f8kgl/swr_power_meter/src/doc/tuto github desktop.docx

Installation de github desktop

Se rendre à l’adresse https://desktop.github.com/

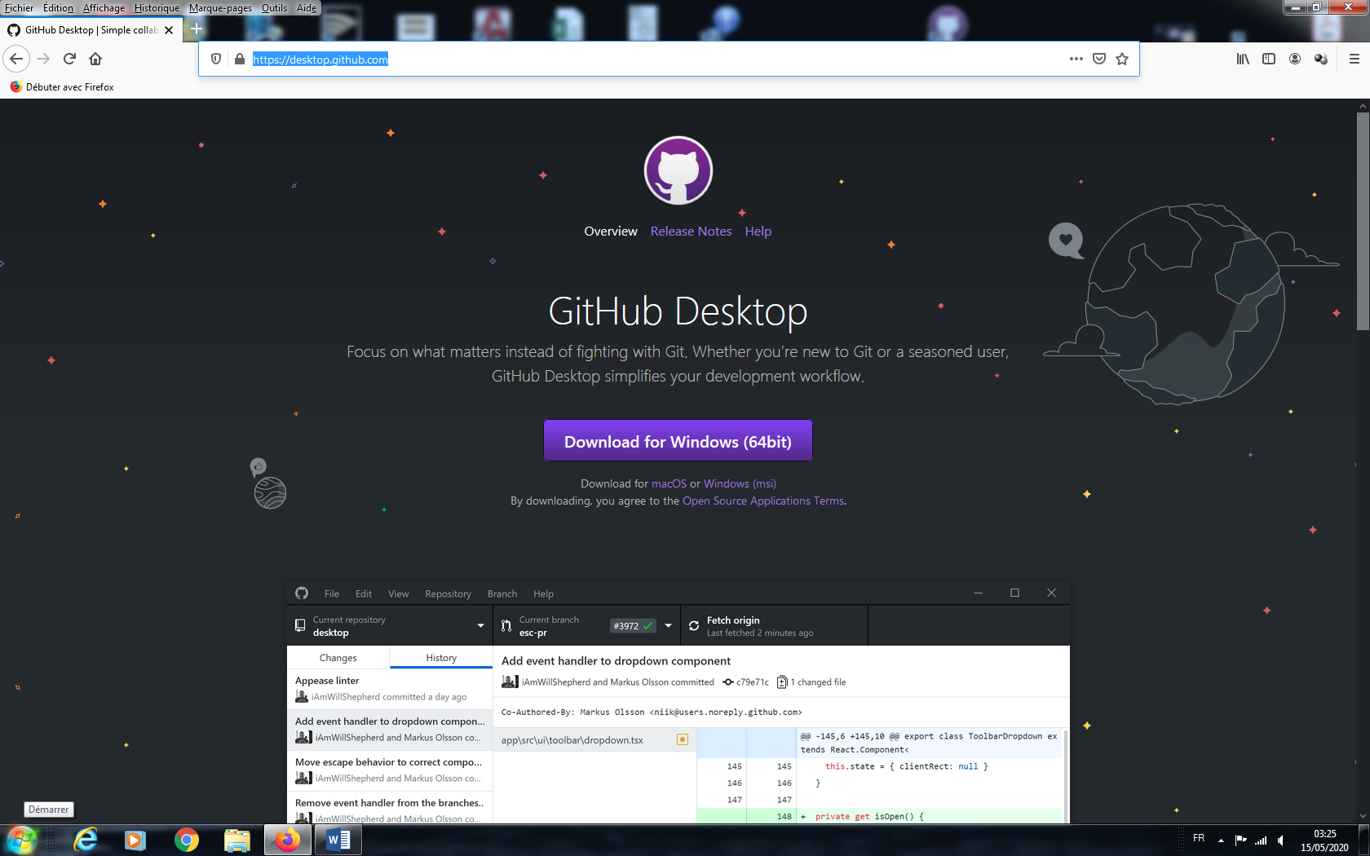
[picture p28: figure]

Cliquer sur

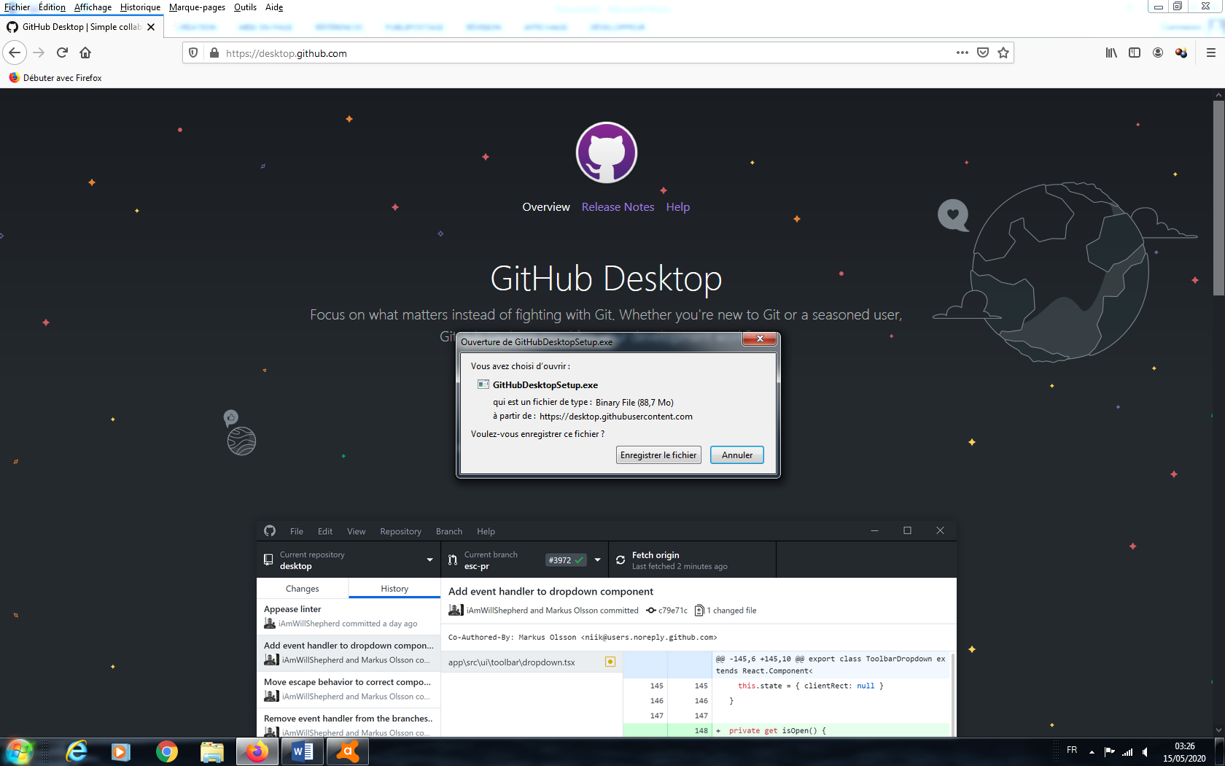
[picture p29: figure]

Enregistrer le fichier puis Exécuter le fichier GitHubDesktopSetup.exe récemment télécharger

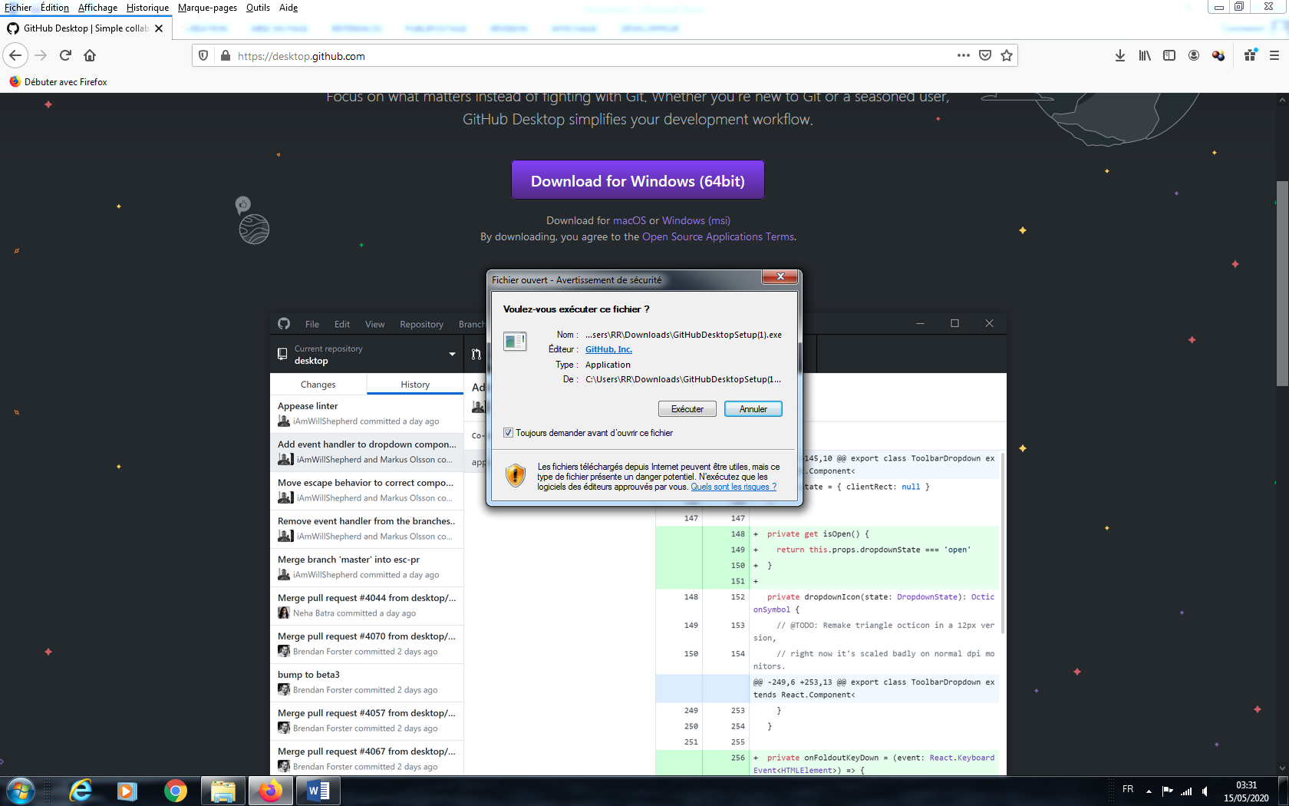
[picture p30: figure]

Cliquer sur Exécuter

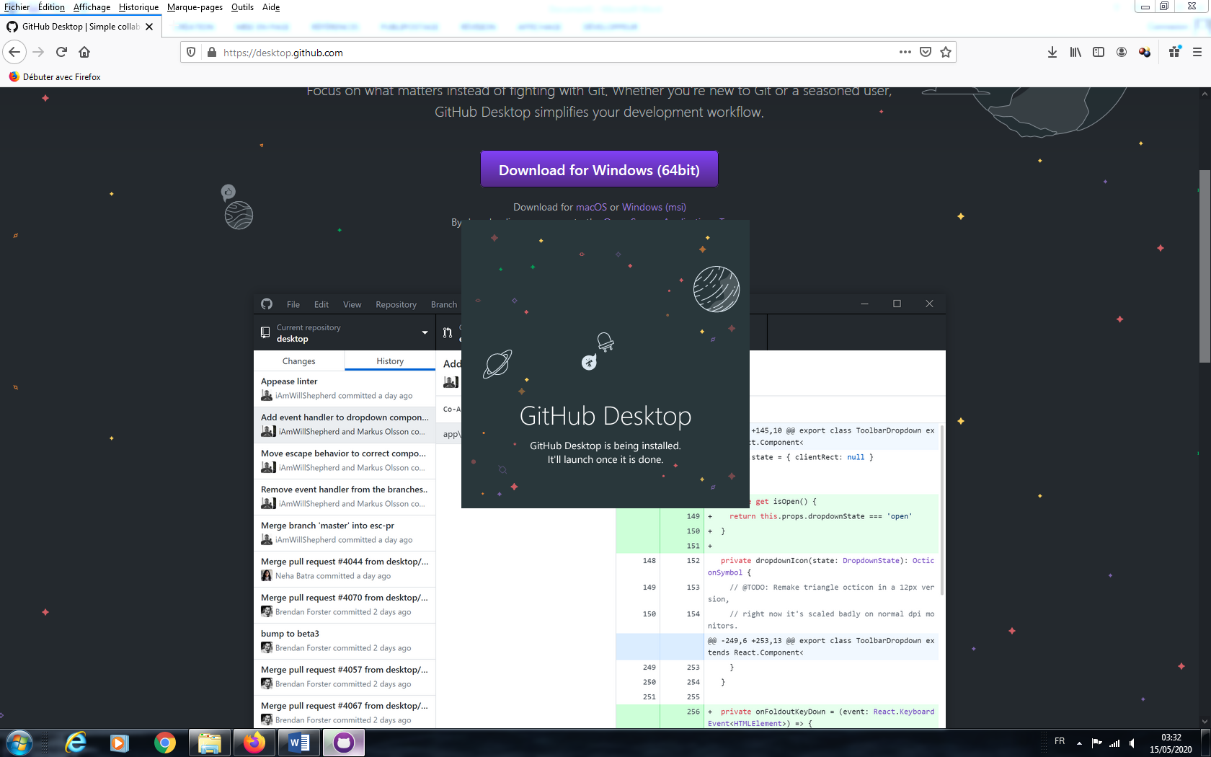
[picture p31: figure]
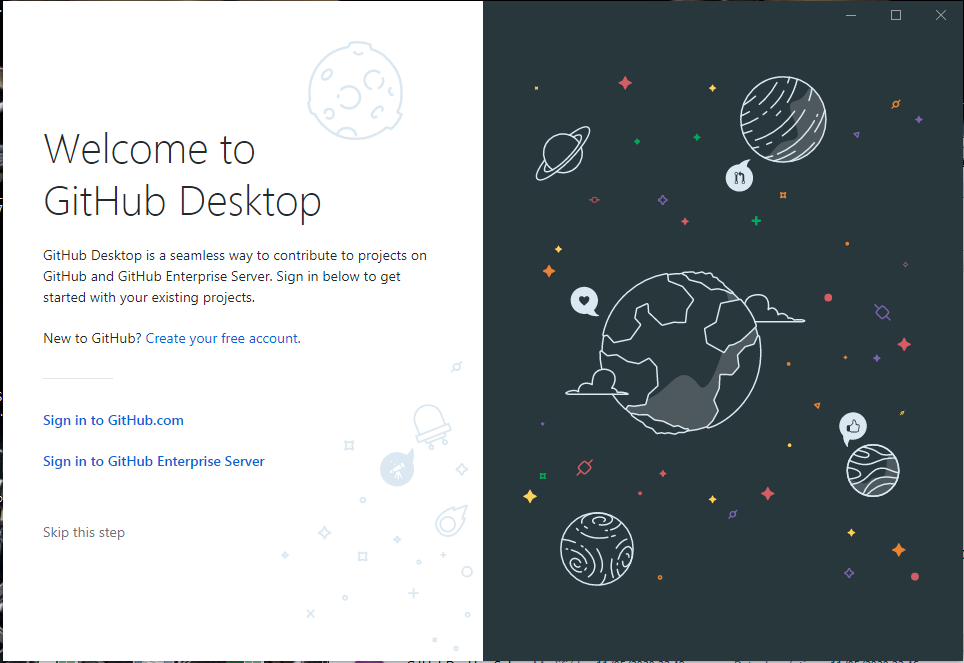
[picture p32: figure]

Cliquer sur Sign in to GitHub.com

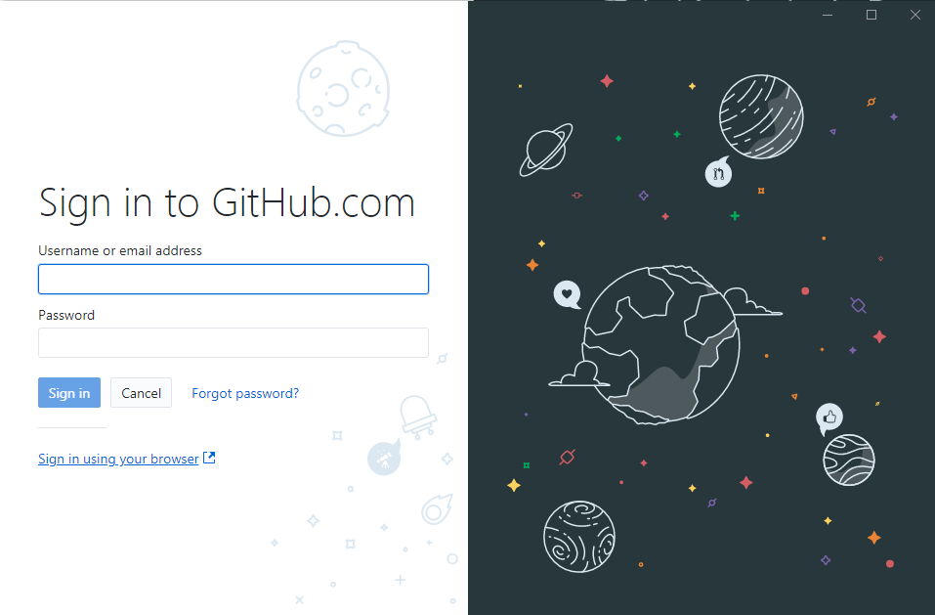
[picture p33: figure]

Renseigner l’adresse mail et le mot de passe

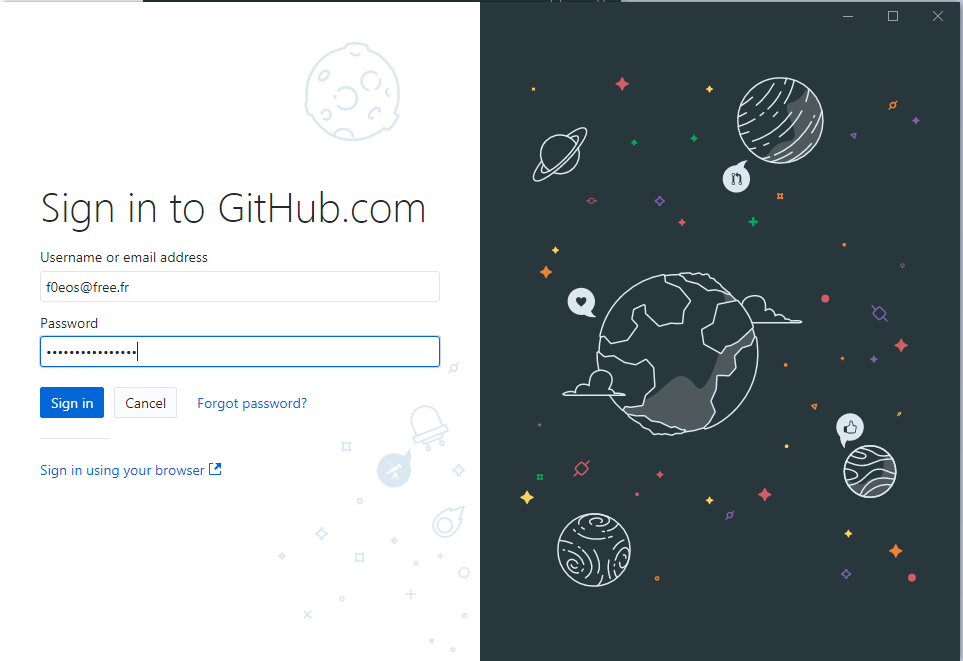
[picture p34: figure]

Renseigner l’adresse mail et le mot de passe puis cliquez sur

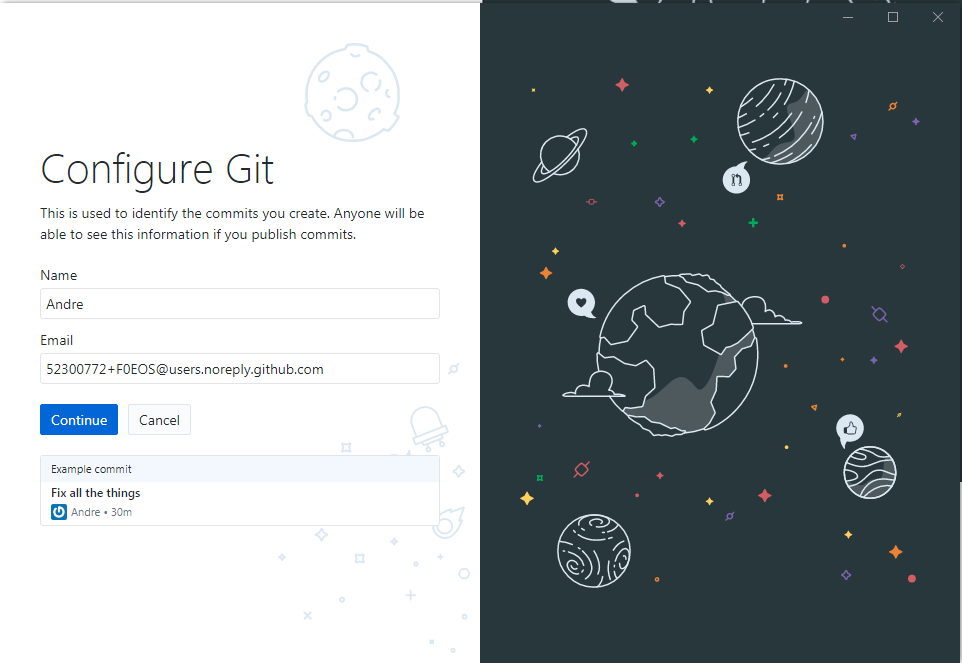
[picture p35: figure]

Cliquez sur continue

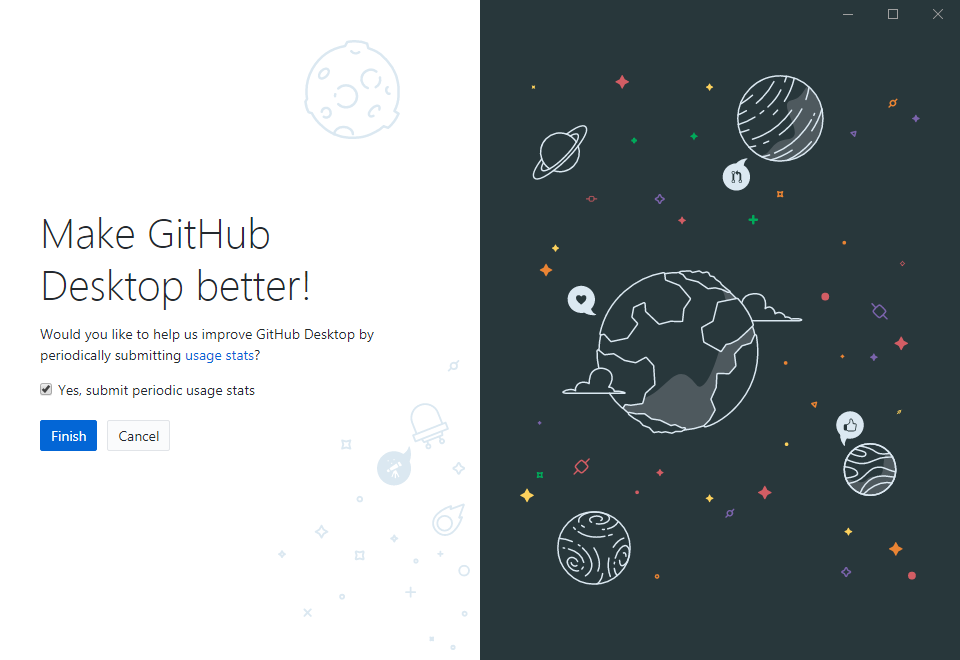
[picture p36: figure]

Cliquer sur Finish

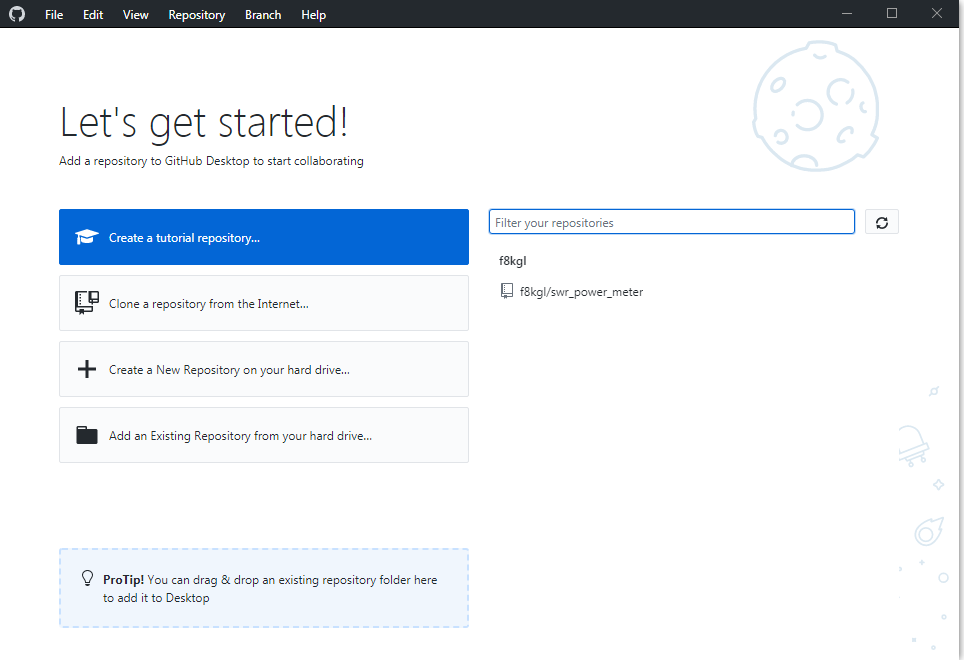
[picture p37: figure]

Cliquez sur « f8kgl/swr_power_meter »

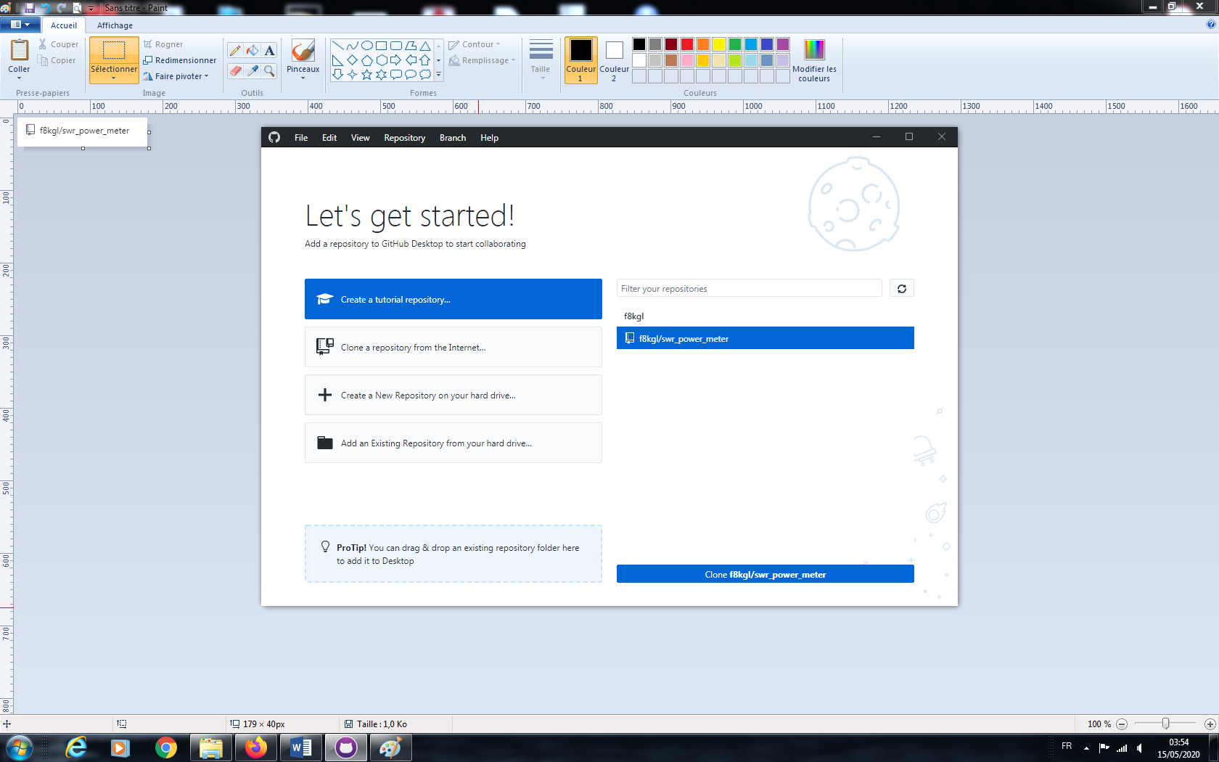
[picture p38: figure]

Cliquez sur

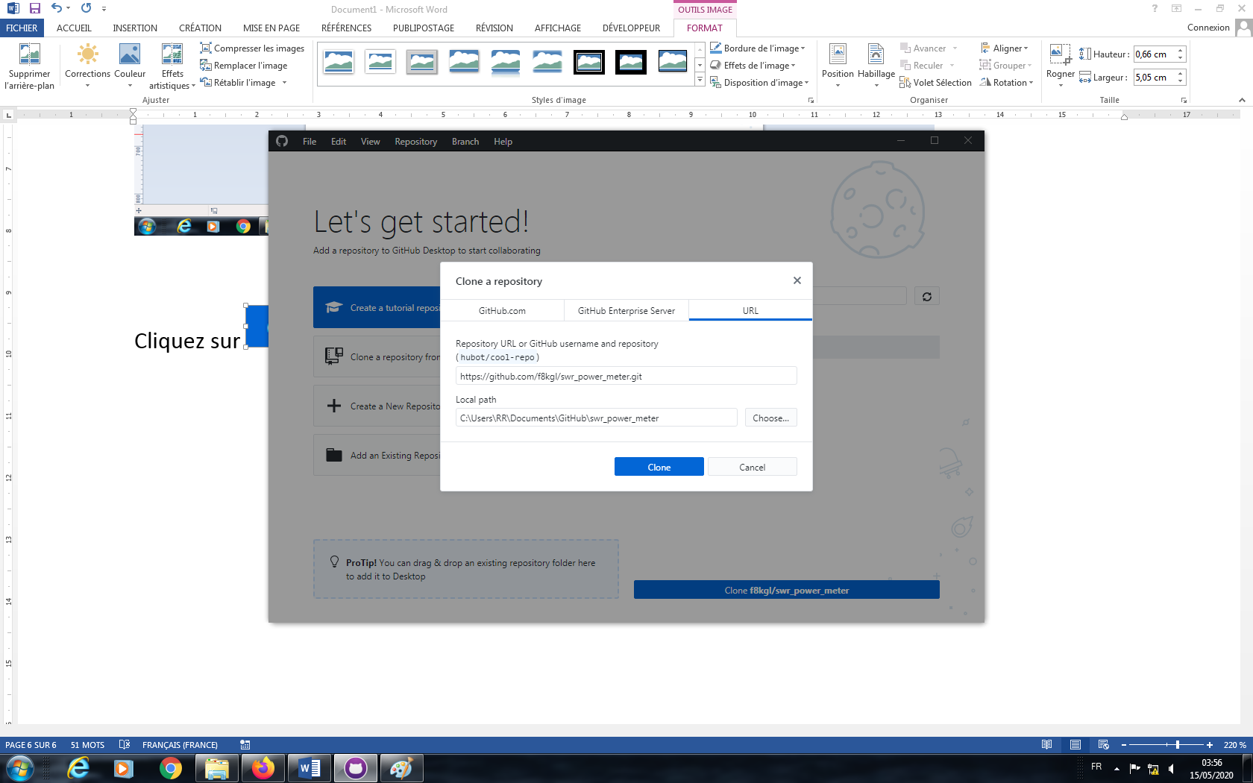
[picture p39: figure]

Cliquer sur

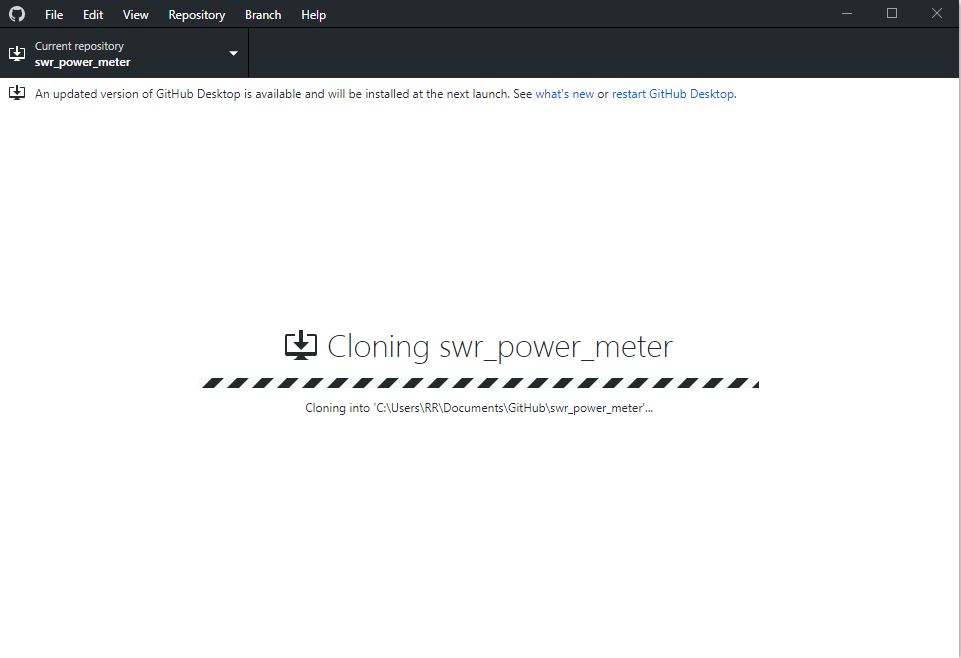
[picture p40: figure]
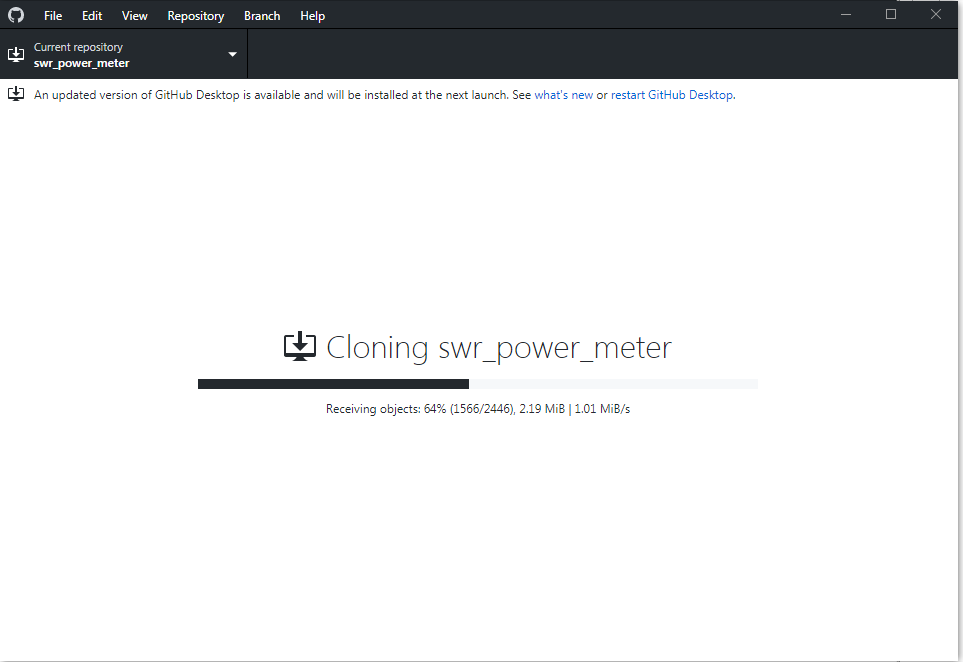
[picture p41: figure]
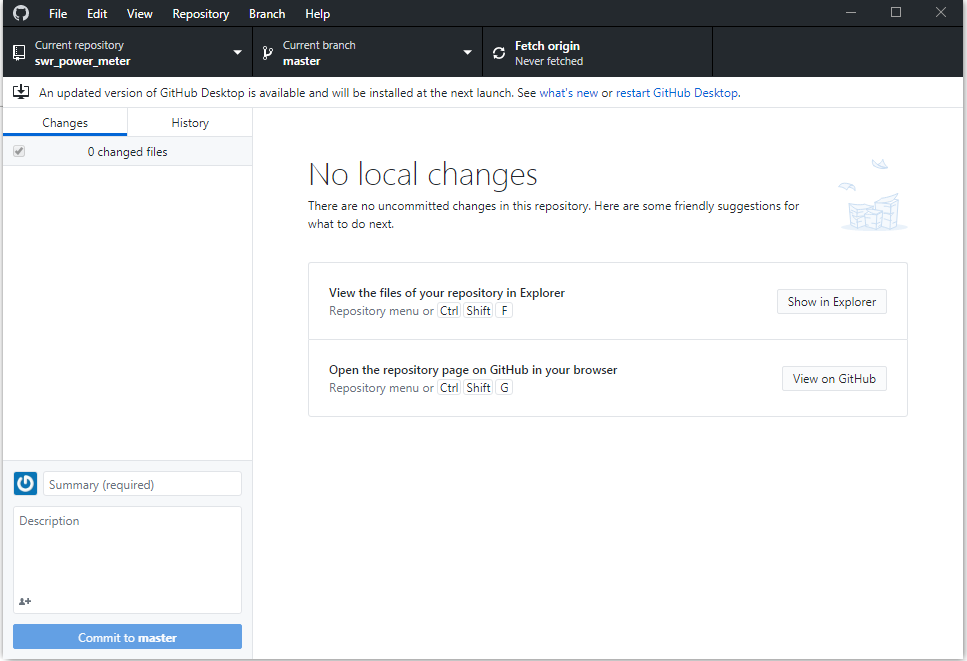
[picture p42: figure]

Tous les fichiers du serveur ont été récupérer et mis dans le répertoire

C:\............\Documents\GitHub\swr_power_meter

Récupération des fichiers du serveur suite a un post

Cliquer sur l’icône

Attendre quelque seconde ou cliquer sur

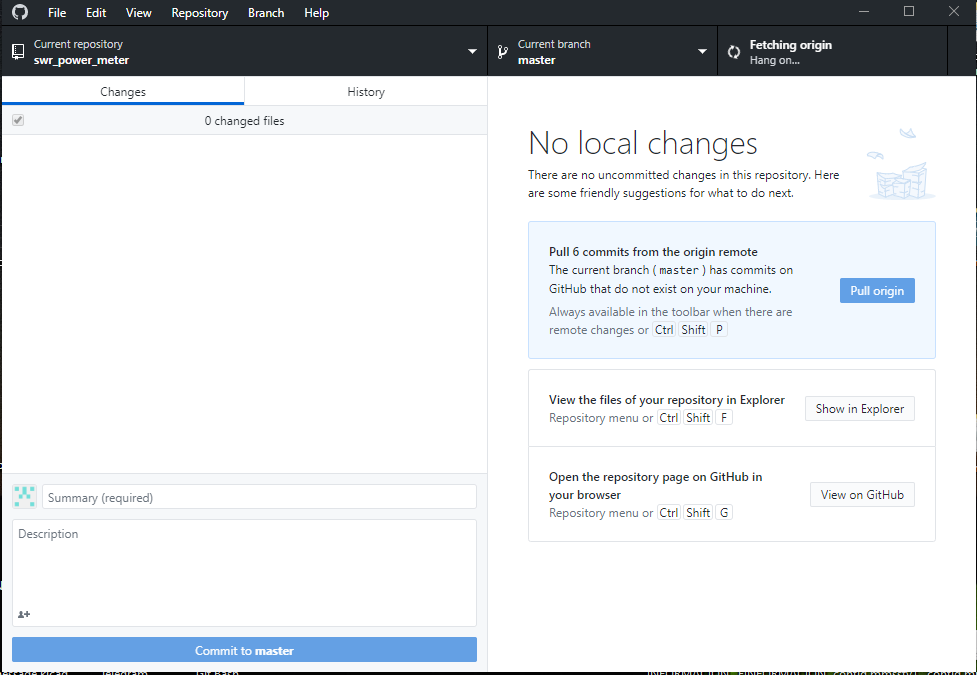
[picture p43: figure]

Cliquer sur

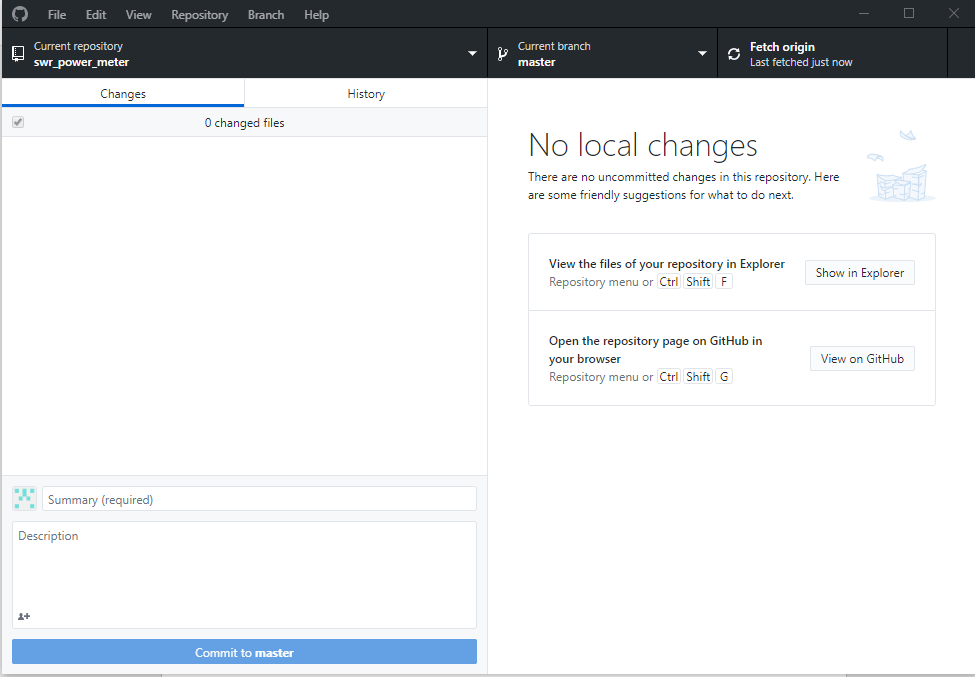
[picture p44: figure]

Pour l’envoie de fichier sur le serveur

Cliquer sur l’icône

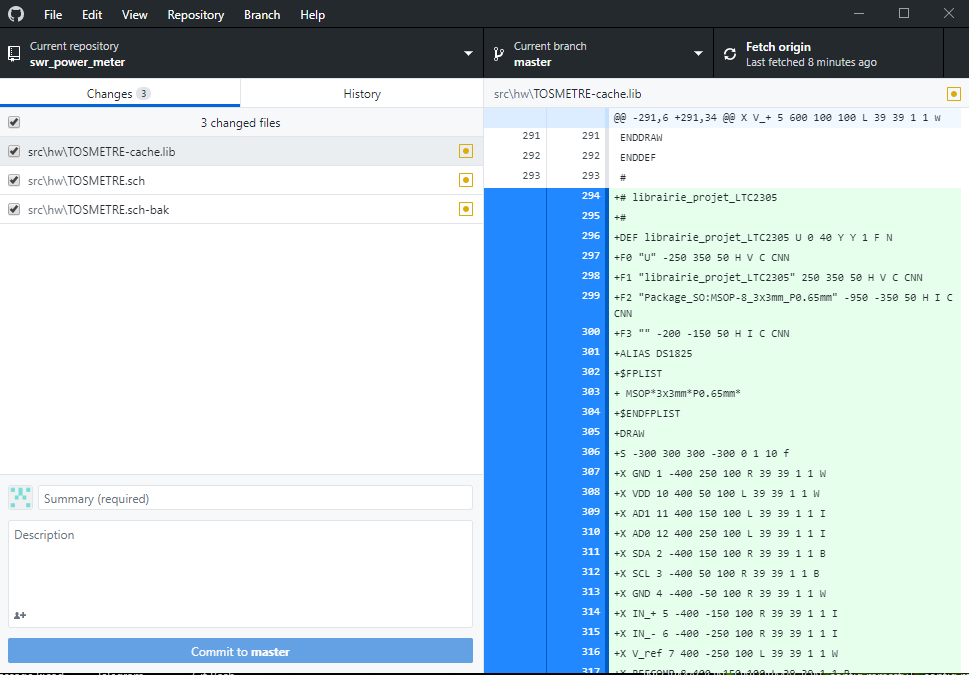
[picture p45: figure]

Dans la première partie à gauche (partie haute) vous trouverez les fichiers qui ont été modifier et qui sont en attente de livraison sur le serveur

Dans la partie basse où il est marqué Summary (required) devra être marque le nom que l’on donne au post

La case description comme sont nom l’indique servira pour decrire le motif de l’envoie les modification faites etc…..

Une fois ces éléments renseigner cliquer sur Commit to master

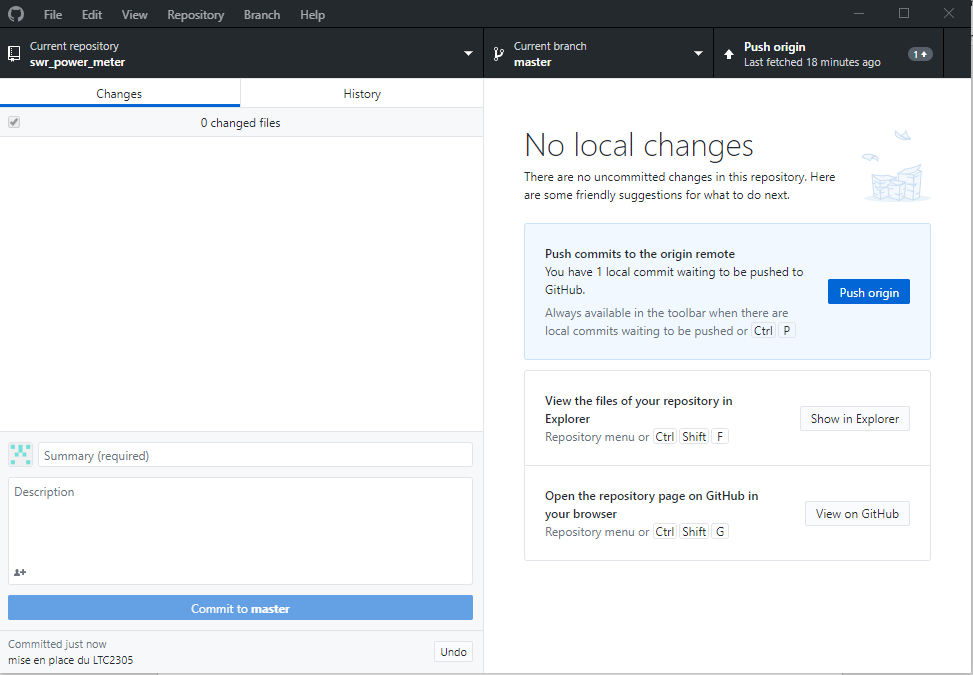
[picture p46: figure]

Puis cliquer sur Push origin en haut a droite de la fenetre

Attendre quelque seconde ou minutes en fonction du nombre de fichiers a poster

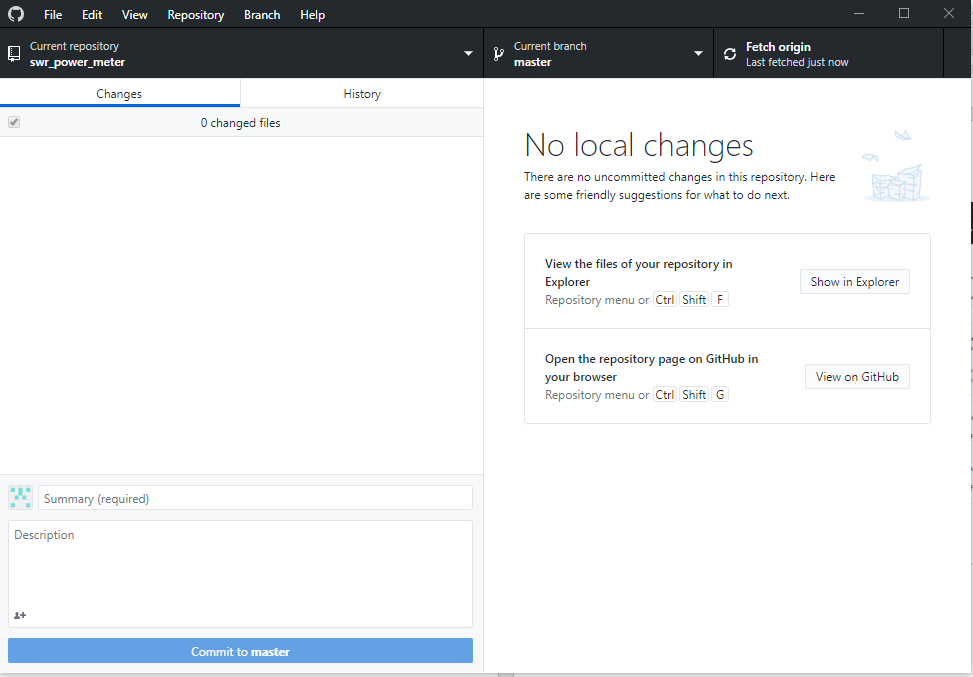
[picture p47: figure]

Fermer la fenetre

Votre serveur est a jour
