f8kgl/swr_power_meter/src/tests/2.1.2.2/result.txt

lcd.jpg : init du LCD, et état de sortie
i2c.jpg : init de l'i2c, et état de sortie
