f8kgl/swr_power_meter/src/tests/2.1.2.5/result.txt

tension.jpg : copie d'écran du LCD
puissance_dBm : copie d'écran du LCD
puissance_W.jpg : copie d'écran du LCD
