f8kgl/swr_power_meter/src/tests/2.1.1.3/result.txt

gpsim.txt : copie sortie console gpsim
gpsim_debug.xls : tableau excel relevé ADC, Vout_AOP + colonnes résultats théoriques
