f8kgl/swr_power_meter/doc/SWR_POWER_METER_Tests.pdf

SWR POWER METER F8KGL

Tests

V 0.8

F0EOS-F4BJH-18/04/21-Vauréal Amitié Radio

SWR_POWER_METER_Tests.fodt | 1/16

## Table des matières

## 1-INTRODUCTION

## 1.1-Objectifs

L’objet du présent document est de spécifier les tests à faire pour leSWR_POWER_METER. Les tests doivent pouvoir permettre de :

- valider le modèle théorique du document d’étude
- valider les choix d’architecture HW et SW du SWR POWER METER et du xWATT METER
- valider les performances obtenues.

Les tests prévus doivent se décliner sous 4 formes :
- test des fonctionnalités logicielles développées dans le firmware de test
- test de conformité par rapport aux spécifications HW de chacun des composants
- test de conformité par rapport aux fonctionnalités HW attendues
- test du modèle théorique décrit dans le document d’étude

Tout défaut relevé durant les tests devront faire l’objet d’une fiche sur le dépôt github du projet.

## 1.2-Pré-requis

1. GPUTILS
1. Désinstaller la version courante de la distribution
2. Télécharger la version 1.5.0-1 en suivant ce lien : https://sourceforge.net/projects/gputils/files/gputils/1.5.0/gputils-1.5.0-1.tar.gz/download
3. Installation
$ tar –xvzf gputils-1.5.0-1.tar.gz
$ cd gputils-1.5.0-1.tar.gz
$ ./configure
$make
$sudo make install

2. GPSIM
1. Désinstaller la version courante de la distribution
2. Télécharger la version 0.31.0 en suivant ce lien : https://sourceforge.net/projects/gpsim/files/gpsim/0.31.0/
3. Installation
$tar -xvzf gpsim-0.31.0.tar.gz
$cd gpsim-0.31.0/
$./configure
$make
$sudo make install
$sudo /sbin/ldconfig
4. Librairie et module GPSIM
1. Création de lien symboliques vers les sources de la librairie, des modules, et le Makefile
$ cd .../gpsim0.31/modules #répertoire ou gpsim a été dézippé
$ ln -s .../swr_power_meter/src/hw/sim/gpsim/lib/Makefile.am
$ ln -s .../swr_power_meter/src/hw/sim/gpsim/lib/ltc2305.cc
$ ln -s .../swr_power_meter//f8kgl/swr_power_meter/src/hw/sim/gpsim/lib/ltc2305.h $ ln -s .../swr_power_meter/src/hw/sim/gpsim/lib/swrpowermeterf8kgl_modules.cc
2. compiler les fichiers ajoutés
$cd .../gpsim0.31/ #répertoire ou gpsim a été dézippé
$ autoreconf
$./configure
$make
$sudo make install
$sudo /sbin/ldconfig
3. Utilisation du projet swr_power_meter_f8kgl
1. Télécharger le projet : git clone https://github.com/f8kgl/swr_power_meter $ cd .../prj
$ make test

2. Calibrator
$ cd .../prj
$ make calibration_gpsim

Ce make génère le fichier .hex de calibration, à flasher dans l'EEPROM du PIC, u travers de l’éxecution du programme « calibrator » :
Usage :
calibrator [-o][-t][-f][-r][-a adc_value][-p P_in]
-o : calibration pour le fw opérationnel
-t : calibration pour le fw de test
-f : Port FWD
-r : Port REF
-a : valeur d'ADC (ADC_m)
-p : Valeur de puissance en W (Pfwd)
3. Simulation
1. Intégration de la calibration
Modifier le fichier .../swr_power_meter/prj/swr_power_meter.stc pour utiliser le fichier de calibration généré à l'étape précédente. Effecter la mise à jour du projet gpsim :

$ cd .../swr_power_meter/prj
$ make update_gpsim
2. Lancement de gpsim
$ cd .../bin
$ gpsim -c swr_power_meter.stc

## 2-FW DE SIMULATION

## 2.1-Tests fonctionnels

2.1.1-Génération de FW et environnement de tests

2.1.1.1-Compilation sans erreur ni warning

Description | Compilation sans erreur ni warning
Objectifs | Vérifier que la compilation ne génère pas d’erreur ni de warning, « from scratch » ou pas
Conditions | Gputils 1.5.0-1
Méthode | $ cd prj $ make clean $ make calibration_gpsim $ make update_gpsim_prj $ make all

Résultats attendus
Test V0.8 | OK|NOK
Restrictions V0.8 | Pas de firmware de calibration
Test V1.0
Restrictions V1.0

2.1.1.2-Chargement du fw par GPSIM

Description | Chargement du projet dans gpsim
Objectifs | Vérifier que le chargement du projet dans GPSIM est correcte : sans erreur.
Conditions | Gpsim 0.31
Méthode | $ cd .../bin $ gpsim -c swr_power_meter.stc Faire une copie d’écran de GPSIM chargé avec le .stc

Résultats attendus
Test V0.8 | OK|NOK
Restrictions V0.8
Test V1.0
Restrictions V1.0

2.1.1.3-Traces de debug dans gpsim

Description | Mesures de debug dans gpsim
Objectifs | Vérifier la validité du modèle des compants GSIM développés spécialement pour le projet : ltc2305, AOP
Conditions | Activer le flag de DEBUG dans ltc2305.cc
Méthode | Faire une copie d’écran des traces GPSIM Relever la tension de sortie de l’AOP, la sortie de l’ADC pour différentes valeurs de tension d’entrée.
Résultats attendus | Dans les traces : R2 voltage AOPout=− ×voltageinput R1 2 N ( ADC)=v×

Valim
Test V0.8 | OK|NOK
Restrictions V0.8
Test V1.0
Restrictions V1.0

2.1.2-Initialisation

2.1.2.1-Message de boot

Description | Affichage du message de boot
Objectifs | Vérifier que le message de boot s’affiche correctement Valide le démarrage du xWATT METER et du SWR POWER METER

Conditions
Méthode | Copie d’éran du LCD sous GPISM au démarrage
Résultats attendus
S | W | R | - | P | O | W | E | R | m | e | t | e | r
F | 8 | K | G | L | | | | | | | V | n | . | m
Test V0.8 | OK|NOK
Restrictions V0.8 | Le fw de simulation ne gère qu’un LCD 2 lignes
Test V1.0
Restrictions V1.0

2.1.2.2-Initialisation des composants SW

Description | Initialisation des composants SW
Objectifs | Vérifier la procédure d’initialisation des composants logicielles, et que celle -ci est conforme aux spécifications du composants, normes, etc...

Conditions
Méthode | Relevé des signaux au moment de l’initialisation du LCD, bus I2C et de l’ADC
Résultats attendus | A l’issue de l’initialistation du LCD : A l’issue de l’initialisation du bus I2C : SDA=SCL=1
Test V0.8 | OK|NOK
Restrictions V0.8
Test V1.0
Restrictions V1.0

2.1.2.3-Log au démarrage

Description | Log au démarrage
Objectifs | Vérifier que le registre RCON a un contenu correct au démarrage Test fonctionnel minimal du logiciel Calibration des timers
Conditions | Compilation avec flag DEBUG_ISSUE_380
Méthode | Relever les logs au démarrage : registres du PIC, timer
Résultats attendus
Test V0.8 | NOK
Restrictions V0.8 | Fiche #380 La tempo de 160us remonte 147us

Test V1.0
Restrictions V1.0

2.1.2.4-Menu tension

Description | Menu tension
Objectifs | Par défaut, après affichage du message de boot, le SWR POWER METER rentre dans le menu tension

Conditions
Méthode | Copie d’écran du LCD après le message de boot
Résultats attendus
Test V0.8 | OK|NOK
Restrictions V0.8
Test V1.0
Restrictions V1.0
F | W | D | u | u | u | h | - | v | v | v | v | m | V
R | E | F | x | x | x | h | - | y | y | y | y | m | V

2.1.2.5-Bouton bande

Description | Test du bouton bande
Objectifs | Vérifier que le bouton bande est correctement géré : passage par les 3 menue (tension, puissance en dBm et en W), et sans rebond

Conditions
Méthode | Appui sur le bouton bande, et vérifier l’affichage du LCD
Résultats attendus | Dans le menu tension :
F | W | D | u | u | u | h | - | v | v | v | v | m | V
R | E | F | x | x | x | h | - | y | y | y | y | m | V
Dans le menu puissance en dBm
F | W | D | - | x | x | . | x | d | B | m
R | E | F | - | y | y | . | y | d | B | m
Test V0.8 | OK|NOK
Restrictions V0.8 | Est-ce possible de vérifier l’anti rebond sous GPSIM ?
Test V1.0
Restrictions V1.0

2.1.2.6-LCD

Description | Test du LCD pour automatisation des tests
Objectifs | Vérifier que la cohérence entre le contenu de la RAM, et les valeurs affichées sur le LCD

Conditions
Méthode | Avec le firmware de test, vérifier l’affichage du LCD et le contenu de v_fwd_and_ref_ascii, v_fwd_and_ref_mV_ascii, v_Pfwd_and_ref_dBm_ascii Avec le firmware opérationnel SWR_POWER_METER, vérifier l’affichage du LCD et le contenu de v_Pfwd_W_ascii
Résultats attendus | Avec le firmware de test Dans le menu tension, relever les valeurs affichées, et le contenu des variables v_fwd_and_ref_ascii et v_fwd_and_ref_mV_ascii. Dans le menu puissance en dBm, relever les valeurs affichées, et le contenu de la variable v_Pfwd_and_ref_dBm_ascii Avec le firmware opérationnel SWR_POWER_METER, relever les valeurs affichées et le contenu de v_Pfwd_W_ascii
Test V0.8 | OK|NOK
Restrictions V0.8
Test V1.0
Restrictions V1.0

2.1.2.7-Calibration DONE

Description | Test de détection de Calibration DONE
Objectifs | Vérifier qu’en l’absence de calibration, le LCD affiche « NO CALIBRATION »
Conditions | firrware opérationnel ne pas charger de fichier de calibration
Méthode | Sans charger de calibration,
Résultats attendus | après l’affichage du message de boot, le LCD affiche :
| N | O | C | A | L | I | B | R | A | T | I | O | N
Test V0.8 | OK|NOK

Restrictions V0.8
Test V1.0
Restrictions V1.0
2.1.3-Mesure ADC brute et mV
- Avec un maximum de valeurs possibles de tension d’entrées (par pas de 1mv? Moins que ça ?)

2.1.4-Mesure de puissance en dBm

2.1.5-Mesure de puissance en W

2.1.6-Test des logs
- Fonctionnalité des niveaux de traces ‘c à d, test de tous les tags possibles, et l trace est effectviement remontée en EEP

•

## 2.2-Mesure de performance

2.2.1-Temps de conversion ADC

Description
Objectifs | Vérifier que le temps de conversion de l’ADC est respecté
Conditions
Méthode | Activation de la trace

Résultats attendus | Temps entre la trame write et la trame > 1,3us
Test V0.8 | OK|NOK
Restrictions V0.8
Test V1.0
Restrictions V1.0
Sensibilité et dynamique en mV, dBm, W les timers

Bloc | Configuration HW | Description des tests
| | Nom | MCU1
| | Nature | Test de programmation
| | Moyens de test | ICD2, câble de programmation dédié
| | Déroulé
| | Résultats attendus | Programmation OK. Démarrage du PIC OK
| | Nom | MCU2
| | Nature | Test de programmation
| | Moyens de test | Raspberry, câble de programmation dédié
| | Déroulé
| | Résultats attendus | Programmation OK. Démarrage du PIC OK
| | Nom | MCU3
| | Nature | Test fonctionnel
| | Moyens de test
| | Déroulé
| | Résultats attendus | Affichage OK Appui bouton poussoir OK (sans effet rebond) contrôle de l’affichage du message de boot, des menus mesure, calibration et calcul
Alimentation | | Nom | ALIM1
| | Nature | Tests fonctionnels
| | Moyens de test | Alimentation 13,8V Alimentation 6,5V (4x1,5V)
| | Déroulé | Relever la tension de sortie du régulateur
| | Résultats attendus | Tension de sortie du régulateur = 5V Précision de la tension de sortie conforme aux spécifications des composants (ADC, AOP, etc...) Démarrage du PIC OK
ADC | U5 monté (et passifs associés) | Nom | ADC1
| | Nature | Tests fonctionnels
| | Moyens de test
| | Déroulé | Appliquer différentes tension dans la dynamique
MCU | U1, U2 montés (et passifs associés) LCD Bouton poussoirs

| | | de l’ADC (0V, 2,5V, 5V) en entrée de l’ADC (IN+ et IN-) à l’aide des ponts de résistances Relever la tension d’entrée de l’ADC Reproduire pour différentes valeur de tensions
| | Résultats attendus | Dans le menu « mesure », sur le LCD, contrôler les valeurs affichées par rapport à la tension en entrée de l’ADC (décimale et hexadécimale)
| | Nom | ADC2
| | Nature | Tests de performances
| | Moyens de test
| | Déroulé | Relever la sensibilité et la précision de la mesure en direct sur l’entrée de l’ADC (IN+ et IN-), dans le menu mesure sur le LCD
| | Résultats attendus | Sensibilité et précision conforme à la résolution de l’ADC (1mV)
| | Nom | ADC3
| | Nature | Tests d’interface
| | Moyens de test | Oscilloscope
| | Déroulé | Relever une trame I2C
| | Résultats attendus | Contrôler la conformité avec les spécifications I2C (timings, niveau et protocole)
| | Nom | ADC4
| | Nature | Tests de performance
| | Moyens de test | Oscilloscope
| | Déroulé | tbd
| | Résultats attendus | Contrôler le niveau de bruit ramené en entrée de l’ADC
AOP | U6, R4, R6 U3, R1, R5 | Nom | AOP1
| | Nature | Test fonctionnel
| | Moyens de test
| | Déroulé | Appliquer une tension de 2,5V en entrée des AOP (fwd et ref) à l’aide d’un pont de résistance en entrée de l’AOP (en lieu et place du circuit de compensation de température) Relever la tension d’entrée de l’ADC Reproduire pour différentes valeur de tensions Relever la sensibilité et la précision de la

| mesure dans le menu mesure sur le LCD
Résultats attendus | Dans cette configuration (R5=R6=1000Ω), le gain de l’AOP vaut 1. Sensibilité et précision conforme à la résolution de l’ADC (1mV)
Nom | AOP2
Nature | Test fonctionnel
Moyens de test
Déroulé | Reproduire le test AOP1, avec : R5=R6=tbd tester avec différentes valeurs de G sur la voie FWD et REF
Résultats attendus | Pour chaque G de l’AOP, valeur mesurée dans le menu mesure conforme Sensibilité et précision conforme à la résolution de l’ADC (1mV/G)

Mesure de la précision et % d’erreur de la mesure de tension (menu tension) voir divers_rf_calc.ods feuille « adc »

Test simple de validation de la square lwa region Test avec 2 puissances à 10dB d’écart résultat attendu = *10 en tension

Test de dispersion Calcul du K du détecteur, sur plusieurs diode Noter les valeurs de K, en déduire la dispersion En déduire aussi les paramètres pour les tess en production (ie, les valeurs max d’ADC sur toute la dynmaique d’entrée)

Test de calcul de la sensibilité A partir de la mesure du K sur plusieurs diodes, en déduire la sensi théorique, et la confirmer par la pratique (permet de valider le niveau de bruit max atteint)

Tuner les circuits d’adaptation des détecteurs HF. Ce circuit doit être reproductible !!! (ie avoir les même valeurs de composants partout, tout le temps, sur tous les circuits)
Test de stabilité de mesure Sur 1 même circuit, relever la stabilité brute de la mesure, avec et sans circuit de compensation en T°

Test de dynamique d’entrée rester dans la square law region relever la dynamique en fonction du gain appliqué (R=625Ω, R=2Ω) tuner la valeur de R le cas échéant

Opération de calibration suivant la méthode trouvée dans l’étude §6.1.3.1

Test des détrompeurs (alim et pile)

Test timer FXM1616U #377
confirmer les résultats théoriques attendus permettra de calibrer le timer pour FXD1616U
