f8kgl/swr_power_meter/src/tests/2.1.2.3/result.txt

log_boot.txt : contenu des logs au démarrage
