f8kgl/swr_power_meter/src/tests/2.1.2.4/result.txt

lcd.jpg : copie d'écran du LCD après le message de boot
