f8kgl/swr_power_meter/(threads)

Thread 1 (2019-06-27):

Revoir la structure de la doc

f4bjh, 2019-06-27:
Mettre ne premier l'architecture en schéma block, sans entrer dans le détail des composants. Pour chacun des dispositifs, préciser quels sont les paramètres qui feront l'objet d'une spec dans les chapitre suivant.

Puis, dans un chapitre spec matérielle, préciser les solutions retenues, et les spécifications qu'elles doivent suivrent

f4bjh, 2019-07-07:
L'architecture de la doc a été revue, et est bien plus claire  à présent.

commit a9cd62aadc24666369c7a07f75b1db16b431439f

Closed 2019-07-07.

Thread 4 (2019-06-29):

Prototype de coupleur directionnel

f4bjh, 2019-06-29:
Monter une manip pour mesurer les pertes et le facteur de couplage des coupleurs suivants :

-coupleur en cable coaxial rigide (sur une idée de Pierre F1FDD)
-ligne imprimée sur circuit
-coupleur avec tore
-coupleur du commerce, issu d'une épave de TOS-mètre
-coupleur du commerce issu d'un Wattmètre du monde professionnel (type Bird, ou power 	sensor 4B250 de Thruline

F0EOS, 2019-07-06:
1 calculer la ligne imprimee par qucs
2 Schema + PCB sous kicad
3 Fabrication (JLPCB ?)

F0EOS, 2019-07-06:
erreur manip

F0EOS, 2019-07-06:
recup parametre circuit FR4
faire deux CI  deux et trois lignes
http://qucs.sourceforge.net/docs/tutorial/coupler.pdf page 5
(F4BJH voir pour simulation ?)

f4bjh, 2019-07-07:
Pour la simulation sous Qucs, attention à #7

f4bjh, 2020-05-07:
#75

f4bjh, 2020-05-18:
Compte tenu des évolutions prévues en  V0.8, et en particulier d la nouvelle fonctionnalité de xWATT METER prévue, le proto de ligne de couplage ne pourra effectivement se faire qu'avec l'arrivée du 1er proto matériel...

==> fiche repoussée en V1.0

f4bjh, 2022-02-07:
vu avec André, au 600 ohms : cette fiche est mise de côté pour le moment.
il faudra la réouvrir quand nous serons en V1.0

Closed 2022-02-07.

Thread 5 (2019-06-29):

Comparatif ROS mètre du commerce

f4bjh, 2019-06-29:
Faire un comparatif entre les différents tos-mètre du commerce radioamateur

Daiwa
Bird
... et autres

Renseigner le QSJ

f4bjh, 2019-07-10:
Pourrais-tu rajouter le QSJ de chacun des tosmètre du commerce ?

f4bjh, 2019-07-10:
Rajouter également, éventuellement, un ou 2 tos mètre numérique au tableau. Comme le MFJ849 par exemple

Closed 2020-04-27.

Thread 6 (2019-07-01):

Erreur de segmentation  qucs

f4bjh, 2019-07-01:
L'ouverture du fichier SWR_POWER_METER_F8KGL_etude_detecteur_V0.6_@2.1.1.dpl provoque une Erreur de segmentation  sous Qucs (Debian 9)

f4bjh, 2019-07-02:
Non reproduit ce jour ???

Closed 2020-04-21.

Thread 18 (2019-07-02):

Impossible d'ouvrir le PCB sous Kicad

f4bjh, 2019-07-02:
sous  Linux debian

Erreur en chargement du PCB.
--
PARSE_ERROR: Expecting 'symbol' in input/source
"/home/f4bjh/DEVEL/swr_power_meter/trunk/src/hw/
TOSMETRE.kicad_pcb", line 1, offset 37
from /tmp/buildd/kicad-
0.20140622+bzr4027/common/dsnlexer.cpp :
Expecting() : line 285

f4bjh, 2019-07-07:
Non reproduit sous Kicad 5.0.2

Closed 2019-07-07.

Thread 21 (2019-07-02):

Changer le PIC pour un 18F1320

f4bjh, 2019-07-02:
Etudier la possibilité de changer le PIC : 16F88 →18F1320

f4bjh, 2019-07-02:
r49-50
r91-102
r104

doc/SWR_POWER_METER_F8KGL_description_specification_v0.5.odt
--
prj/main.asm
prj/Makefile
src/hw/TOSMETRE.sch
src/hw/TOSMETRE.kicad_pcb

Closed 2019-07-02.

Thread 22 (2019-07-02):

Reproductibilité du détecteur à diode

f4bjh, 2019-07-02:
Quelle est la reproductibilité de la mesure du détecteur à diode ?
Peut-on s'assurer que la courbe Vdetect=f(puissance) sera bonne pour toutes les diodes ?

f4bjh, 2019-07-07:
#23

Faire une étude approfondie du pont de mesure
--
moyen de mesure (générateur, ampli de puissance,???)
fabrication de la ligne
fabrication du détecteur
variabilité des composants => quelle variabilité sur la mesure ?
principe de la calibration (courbe P=f(ADC) + offset de la ligne)
un offset par bande ? Combien de point par bande ?
taille de l'EEPROM
s'aider du mode test

doc/SWR_POWER_METER_F8KGL_etude_detecteur_HF_v0.6.odt

f4bjh, 2019-07-08:
il faut faire un prototype à base de BAS70

#69

Closed 2020-04-23.

Thread 23 (2019-07-02):

Mise en œuvre du tableau de calibration

f4bjh, 2019-07-02:
coder le tableau courbe_Vdetect.ods

calibration des pertes de la ligne de mesure

f4bjh, 2019-07-02:
r51

f4bjh, 2019-07-02:
doc/SWR_POWER_METER_F8KGL_description_specification_v0.6.odt
--
src/sw/calc/calc_power.asm

f4bjh, 2019-07-08:
La relation P=f(Vout) est donc de la forme P=K*(Vout^a). K et a seront déterminés par le mode calibration, selon les formules suivantes :

a=log(y1/y0) / log(x1/x0)
K=P0/(V0)^a

La relation P=K*(Vout^a) devra être implémentée dans le firmware
Les 2 relations a=log(y1/y0) / log(x1/x0) et K=P0/(V0)^a ont vocation a être implémentée dans l'outil de calibrationpour l'OM (ou le club, si c'est le club qui prend la responsabilité de calibrer tous les tosmètre...)

Les questions suivantes qui vont se poser sont :
-comment implémenter la fonction puissance dans le PIC ? Par une table ? Par une routine mathématique.
Dans le 1er cas, la flash du PIC aura t'elle une taille suffisante ? (8k dans le 18F1320) Sachant que l'ADC (MAX11100) fait 16 bits (=>65535 mots de de 16 bits) + la table de calcul du SWR ???
Dans le 2ème cas, le PIC sera t'il assez rapide pour exécuter le calcul ? Cf AN660 de chez Microchip

f4bjh, 2019-07-08:
#67

f4bjh, 2019-07-10:
#72

Closed 2020-04-27.

Thread 25 (2019-07-02):

Fichiers inutiles de src/hw

f4bjh, 2019-07-02:
pour gagner un peu de place sur SVN, supprimer les fichiers inutiles
--

f4bjh, 2019-07-02:
r47-48

src/hw/TOSMETRE2.net
--
src/hw/TOSMETRE3.net
src/hw/TOSMETRE4.net
src/hw/*.bak
src/hw/*.jpg

Closed 2019-07-02.

Thread 27 (2019-07-02):

Bande de fréquence utilisable

f4bjh, 2019-07-02:
prévoir un commutateur par bande de fréquence
--
calibration par bande de fréquence

f4bjh, 2019-07-17:
Pour le point "prévoir un commutateur par bande de fréquence", doublon avec #39

Pour "la calibration par bande de fréquence", doublon avec  #79

Closed 2019-07-17.

Thread 31 (2019-07-02):

Rajouter un interrupteur en série avec le pack pile

f4bjh, 2019-07-02:
pour couper l’alimentation par le pack pile. Sur alim externe, le branchement suffit à faire démarrer le système

F0EOS, 2019-07-06:
Voir avec Jack Alim qui coupe les pile si alimentation via Alimentation Stabilise

f4bjh, 2020-04-28:
https://github.com/f8kgl/swr_power_meter/commit/9dbf88e6ae1ed61137ce3cdc3c19a4f8113eb1b9

Closed 2020-04-28.

Thread 34 (2019-07-02):

Evolution LCD

f4bjh, 2019-07-02:
Passer le LCD sur 4 lignes
évolution de gpsim

f4bjh, 2020-05-04:
Idéalement, il faudrait qu'il y ait qu'un seul firmware...à voir comment on peut gérér cela (interroger le LCD ?)

f4bjh, 2021-04-01:
#188

f4bjh, 2022-02-07:
repoussé en V1.0

Thread 36 (2019-07-03):

Abandon du bouton reset/validation calibration

f4bjh, 2019-07-03:
Abandoner le bouton poussoir reset/validation de la calibration

développer un outil PC qui calcule le fichier de calibration. Il faudra le reflasher dans le PIC.

Appli test : inchangée
Appli calibration : uniquement calibration (a priori, ne sera pas utilisée par l'utilisateur)
Appli opérationnelle = calibration + opérationnelle. Si le PIC n'est pas calibré (test d'un bit en EEP), avec une appli opérationnelle, placer le tosmètre automatiquement en mode calibration sans possibilité d'en changer. Après calibration, monter le bit de calibration en EEP

f4bjh, 2019-07-17:
Quelque puisse être la diode choisie, la validation de la calibration pourra se faire par un chargement des valeurs en EEP (ou en Flash ?)
Plus besoin d'un bouton de validation

Closed 2019-07-17.

Thread 38 (2019-07-06):

Cablage MAX 4624

F0EOS, 2019-07-06:
IN commande PIC
GNG Et COM  masse
V+  alimentation +5v
NO et NC  vers FWD et REF

f4bjh, 2019-07-11:
Suite au commit 4f309e5536476682bc40797a770bac94114bafbe, rajouter au schéma les switch du §3.4.1 des spécifications (doc/SWR_POWER_METER_F8KGL_specifications.ods p 23)

f4bjh, 2020-04-27:
avec le passage en V0.7, le switch devient inutile

Closed 2020-04-27.

Thread 39 (2019-07-07):

Préférer un bouton poussoir, plutôt qu'un commutateur pour le sélectionneur de bande

f4bjh, 2019-07-07:
Dans un sousci d'économie du nombre d'I/O du PIC.

Faut-il le faire fonctionner sous IT ? Sans doute que oui du coup, si jamais le PIC est pris dans ses calculs de puissance et de SWR...difficile de faire du polling, si ce n'est pas assez rapide. A voir...Commencer par faire du polling.

Implémenter un compteur pour déterminer la bande de fréquence.

f4bjh, 2020-04-28:
https://github.com/f8kgl/swr_power_meter/commit/9dbf88e6ae1ed61137ce3cdc3c19a4f8113eb1b9

Closed 2020-04-28.

Thread 40 (2019-07-07):

Spécifier le boitier

f4bjh, 2019-07-07:

f4bjh, 2019-07-10:
§3.1.1
Dimensions = 155x80x100 (mm

Est-ce suffisant ?

F0EOS, 2019-07-11:
155 de large OK
80 de hauteur  ok voir un peu plus petit reste a déterminer en fonction de l'afficheur
profondeur 100 pk pas 70 me parait pas mal non plus

Reste a affiner les dimensions en fonction de ce que l'on mettra dedans et son agencement

f4bjh, 2022-02-07:
#223

Closed 2022-02-07.

Thread 41 (2019-07-07):

Définir un mode test

f4bjh, 2019-07-07:
Spécifier un mode test qui remonte simplement les valeurs d'ADC (debug des prototypes)

définir un flag de compilation

f4bjh, 2019-07-07:
sera peut-être réutilisé pour la calibration ??? #23

f4bjh, 2019-07-07:
SVN42
SVN62

Closed 2019-07-07.

Thread 47 (2019-07-07):

Si on corrige #46 en fixant la calibration en 0xC00

f4bjh, 2019-07-07:
voir pour contrôler l'étendue du code, pour ne pas marcher sur la table de calibration

f4bjh, 2019-07-07:
SVN62

Closed 2019-07-07.

Thread 64 (2019-07-07):

les goto génère des nop

f4bjh, 2019-07-07:
ça peut potentiellement poser pb dans les timers de tempo

f4bjh, 2020-05-16:
en prévision de tirer une nouvelle branche "menu_aop" pour les dev de la V0.8

f4bjh, 2020-06-11:
c'est vraisemblablement tout à fait normal. Les goto nécessitent 2 instructions machines

Closed 2020-06-11.

Thread 66 (2019-07-07):

Impossible de faire une droite en échelle log pour des données de la forme y = b*10^(ax)

f4bjh, 2019-07-07:
Dans LibreOffice, pourquoi la courbe d'interpolation par une puissance de 10, passant par les 2 points de calibration n'est pas une droite en échelle logarithmique, alors qu'elle est bien de la forme y = b*10^(ax) ?

commit c96d1924545a78ad263c0e9ad5e32a4788f28c43

Closed 2019-07-08.

Thread 67 (2019-07-08):

[TEST] Implémentation de la relation P=K*(Vout^a) dans le PIC

f4bjh, 2019-07-08:
Implémentation par une routine mathématique dans le firmware de test
Afficher le résultat de ce calcul sur le LCD
Relever les temps d'éxecution, et l'afficher sur le LCD
Implémentation du bouton poussoir, initialement prévue pour le commutateur de bande, pour basculer entre l'affichage des ADC, et l'affichage du calcul de P dans le firmware de test

f4bjh, 2019-07-10:
#79

Closed 2019-07-10.

Thread 69 (2019-07-08):

Prototype de détecteur HF

f4bjh, 2019-07-08:
Faire un prototype et relever Vout=f(P)
Confirmer la square law region (=> doc)

Pour le schéma du proto, voir la simulation sous Qucs

f4bjh, 2019-07-10:
commit c530a0d

Closed 2019-07-10.

Thread 70 (2019-07-09):

Comment gérer le changement de calibre ?

f4bjh, 2019-07-09:

f4bjh, 2019-07-17:
Demandera confirmation, mais si on trouve la bonne diode, la dynamique de sortie du détecteur pourrait ainsi rentrer dans la dynamique de l'ADC 16bits...
Du coup, plus besoin de changer de calibre

Closed 2020-04-23.

Thread 72 (2019-07-09):

Voir le comportement de différentes diodes schottky

f4bjh, 2019-07-09:
Actuellement, nous partons sur la BAS70

Daiwa utilise des 1N60 (ou 1K60 ?)
Et Bird ?

Et la HSMS-2822 ? (problème de simulation sous Qucs ?)

f4bjh, 2019-07-09:
[BAS70_1PS7XSB70_SER.pdf](https://github.com/f8kgl/swr_power_meter/files/3372354/BAS70_1PS7XSB70_SER.pdf)

[hsms28xx.pdf](https://github.com/f8kgl/swr_power_meter/files/3372381/hsms28xx.pdf)

Utilisé par Daiwa :
[1n60.pdf](https://github.com/f8kgl/swr_power_meter/files/3372395/1n60.pdf)

f4bjh, 2019-07-09:
[DetectorOverview.pdf](https://github.com/f8kgl/swr_power_meter/files/3373406/DetectorOverview.pdf)
[an988.pdf](https://github.com/f8kgl/swr_power_meter/files/3373407/an988.pdf)
[BAT54XV2T1-D.PDF](https://github.com/f8kgl/swr_power_meter/files/3373408/BAT54XV2T1-D.PDF)
[AN969.pdf](https://github.com/f8kgl/swr_power_meter/files/3373409/AN969.pdf)

f4bjh, 2019-07-09:
[av02-1320en_ds_hsms-282x_2014-11-26.pdf](https://github.com/f8kgl/swr_power_meter/files/3373534/av02-1320en_ds_hsms-282x_2014-11-26.pdf)

f4bjh, 2019-07-09:
#69

f4bjh, 2019-07-10:
La formule de HP de la square Law Region n'est valable qu'à +/-15% environ avec la diode HSMS2822. (doc/courbe_Vdetect.ods)

commit c530a0d

Le modèle est-il valable ? Si non, pourquoi ?
Problème de mesure ? (précision des appareils de mesures utilisés à préciser dans la doc)
Problème de montage du prototype ?
Autre ?

f4bjh, 2019-07-10:
-En d'autres terme,, la relation P=K*(Vout)^a est-elle valable dans la square law region ?

-Comment la précision du montage (ie, tolérance du géné HF, toélrance du millivoltmètre) influe t'il sur relevé de cette mesure

[Understanding-Operating-and-Interfacing-to-Integrated-Diode-Based-RF-Detectors.pdf](https://github.com/f8kgl/swr_power_meter/files/3376866/Understanding-Operating-and-Interfacing-to-Integrated-Diode-Based-RF-Detectors.pdf)

f4bjh, 2019-07-10:
-Calculer, et/ou mesurer les écarts entre le relevé expérimental de la courbe avec la spec de la diode "Figure 8. Typical Output Voltage vs. Input Power, Large Signal Detector Operating at 915 MHz."

f4bjh, 2019-07-10:
[an986.pdf](https://github.com/f8kgl/swr_power_meter/files/3376894/an986.pdf)

f4bjh, 2019-07-10:
[detector.pdf](https://github.com/f8kgl/swr_power_meter/files/3377202/detector.pdf)

f4bjh, 2019-07-10:
En analysant de manière plus approfondie le prototype de détecteur HF, on est en droit de se demander comment la puissance de puissance a été faite par HP, dans la figure 8 de av02-1320en_ds_hsms-282x_2014-11-26.pdf
En effet, s'agit t'il de la puissance d'entrée mesurée sur 50ohms, ou sur 68ohms ?
Pour ma part, dans courbe_Vdetect.ods, la puissance est mesurée sur la charge de 68ohms. Cela peut engendrer une différence de 0,1dB. Ce qui ramènerait l'erreur max de 15% à 13%.
A celà, s'ajoute aussi peut-être la précision de la calibration du générateur HF (j'ai du rajouté manuellement 0,5dB)

Cependant, après RE-calibration avec des valeurs de puissances corrigées, on retrouve encore des écarts >10% entre la puissance d'entrée théorique (corrigée), et la puissance calculée par P=K*(Vout)^a

f4bjh, 2019-07-10:
La précision de mon voltmètre est la suivante:

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

Ce qui peut tout à fait expliquer les écarts de 15%...

f4bjh, 2019-07-10:
Remarque reportée dans doc/SWR_POWER_METER_F8KGL_etude_detecteur_HF_v0.6.odt
commit 497fa2a5e6c0d3bbb16c9a41cf75df82370280c1

f4bjh, 2019-07-15:
Rajouter les références à ces docs en PDF, en annexe de ma documentation

f4bjh, 2019-07-15:
#84 a montré un problème de méthode dans le choix de la diode.

Ma démarche est la suivante :
Dans l'étude du détecteur HF, trouver la relation V=f(P). Et relier cette relation, et les paramètres (a et K) qu'elle contient, aux specs d'une diode schottky.
Sur la base des specs générales (ie précision de 10% + dynamique d'entrée), en déduire dans le document de spécification, les valeurs de la spec de la diode à trouver
Dans la doc d'implémentation (à scinder en 2 pour le HW et le SW ?), justifier le choix de la diode effectivement choisie sur la base des spécfications.

L'ennui, c'est que pour le moment, je n'arrive qu'à trouver la valeur de a. Et en plus, la valeur ainsi trouvée impose des valeurs un peu bizaroïdes sur la dynamique d'entrée.
Remarque : la valeur de a trouvée correspond à la toute 1ère zone de la diode. Dans les autres feuilles, j'utilisais plutôt la 2ème zone. Peut-être cela simplifie t'il le problème. Mais encore faudrait-il pouvoir le justifier...

Closed 2020-04-23.

Thread 73 (2019-07-09):

Impossible de reproduire la valeur basse de calibration sous Qucs

f4bjh, 2019-07-09:
En partant de src/hw/sim/qucs/SWR_POWER_METER_F8KGL_etude_detecteur_V0.6_@2.1.1.sch

commit d7290f8aba0ae91e491c89fead2e36a6a69f35aa

Impossible de reproduire Vout = 400uV pour Pin=-10dBm telle que mise dans doc/courbe_Vdetect.ods
commit c418c608f6545184f5a9f2b115ca11c6d4ac4f36

f4bjh, 2020-04-21:
non reproduit

Closed 2020-04-21.

Thread 74 (2019-07-09):

probleme de post

F0EOS, 2019-07-09:
probleme de post  a chaque envoie j'ai ce msg

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

f4bjh, 2019-07-09:
Visiblement, il faut **d'abord** se mettre à jour avant d'uploader une modif quelqueconque

Si je ne dis pas de bêtise, cliquer sur "Git Sync", pour faire la synchronisation

Pour rappel, uplader une modif, se dit aussi "faire un commit", ou faire "git push"
Se synchroniser (menu Git sync dans Windows") se dit aussi "faire un git pull"

f4bjh, 2019-07-09:
Peux -tu vérifer ce que je dis là ? C'est à dire :

1-faire une modif bidon dans le schéma
2-Faire Git Sync
3-Faire le commit, et vérifier que tu n'as plus de message d'erreurs. Dans le cas contraire, poster içi même la copie d'écran de l'erreur

f4bjh, 2019-07-10:
C'est bon ? C'est résolut du coup ?

f4bjh, 2020-01-05:
On peut fermer ce bug ?

F0EOS, 2020-01-05:
Je suis passer sous W10 donc plus rien sur le pc

J au reinstaller kicad et rien d autre

Fait que je re installe tout le reste sauf que je me souviens pas, me souviens pas de parametre et mot de passe mais surtout comment ca refonctionne

Donc besoin tuto par mail lol

Donc je ne peux pas te repondre

----- Mail d'origine -----
De: Fabrice DECROP LONGET <notifications@github.com>
À: f8kgl/swr_power_meter <swr_power_meter@noreply.github.com>
Cc: F0EOS <F0EOS@FREE.FR>, Assign <assign@noreply.github.com>
Envoyé: Sun, 05 Jan 2020 17:39:23 +0100 (CET)
Objet: Re: [f8kgl/swr_power_meter] probleme de post (#74)

On peut fermer ce bug ?

--
You are receiving this because you were assigned.
Reply to this email directly or view it on GitHub:
https://github.com/f8kgl/swr_power_meter/issues/74#issuecomment-570927559

f4bjh, 2020-01-05:
OK.

En attendant que tu remontes ton système, je ferme ce bug.

Au besoin, on le rouvrira si tu as de nouveaux des problèmes similaires.

Closed 2020-01-05.

Thread 75 (2019-07-09):

Caracteristique FR4

F0EOS, 2019-07-09:
je ne comprends pas la correspondance des caracteristique du FR4 pour paramettre QUBS

De meme en parametre par default j'ai des piste large de 2 ou 3 mm et je trouve cela bizarre

[CARACTERISTIQUE FR4.xlsx](https://github.com/f8kgl/swr_power_meter/files/3374361/CARACTERISTIQUE.FR4.xlsx)

f4bjh, 2019-07-09:
Tout d'abord, pour info : commit 94bb4ea00321671a34b73466ccb6c8338c337daf

**NE PAS UTILISER D'ESPACE DANS LES NOMS DE FICHIERS OU DE REPERTOIRE**
Préferer le caractère "underscore", ou tiret du chiffre 8

f4bjh, 2019-07-09:
Dans QUCS, pourrais-tu me dire quels sont les paramètres qui te manquent exactement ?

F0EOS, 2019-07-09:
tous je ne comprends pas les correspondances entre les caracteristique du FR4 et les parametre de Qucs

f4bjh, 2019-07-09:
Dans QUCS, avec l'outil qui fait la synthèse de la ligne imprimée, si tu passes la souris juste au dessus du nom du paramètre, il te dit de quoi il s'agit.

Exemple : "Er" ----> Permitivité relative ==> Google est ton ami
[https://fr.wikipedia.org/wiki/Permittivit%C3%A9](url)

Et là, tu apprends que la permitivité relative est la même chose que la constante diélectrique.
"Mur" ---> Perméabilité relative ==> Google est ton ami

[https://fr.wikipedia.org/wiki/Perm%C3%A9abilit%C3%A9_magn%C3%A9tique](url)

et ainsi de suite...

Closed 2020-05-18.

Thread 76 (2019-07-10):

nettoyage des commit 0ecaa69dd6f8bc7af803491b78190ec2dfddce83 et commit 4fcc67b1dd28b33aa8be7d4707608642628ec698

f4bjh, 2019-07-10:
Nettoyage des derniers commit :

1-Renommer COMPARATIF TOSMETRE.xlsx en COMPARATIF_TOSMETRE.xlsx
2-Renommer Ligne Imprimee en ligne_imprimee
3-Renommer l'ensemble des fichiers
Ligne imprime.kicad_pcb
Ligne imprime.net
Ligne imprime.pro
Ligne imprime.sch

en

ligne_imprime.kicad_pcb
ligne_imprime.net
ligne_imprime.pro
ligne_imprime.sch

4-Déplacer src/hw/doc/COMPARATIF_TOSMETRE.xlsx vers doc (depuis la racine)

**Il faut d'abord se mettre à jour avant d'uploader une modif quelqueconque**

Si je ne dis pas de bêtise, cliquer sur "Git Sync", pour faire la synchronisation

Pour rappel, uplader une modif, se dit aussi "faire un commit", ou faire "git push"
Se synchroniser (menu Git sync dans Windows") se dit aussi "faire un git pull"

#74

Closed 2020-04-26.

Thread 77 (2019-07-10):

Square Law Region n'est valable qu'à +/-15% environ

f4bjh, 2019-07-10:
La formule de HP de la square Law Region n'est valable qu'à +/-15% environ avec la diode HSMS2822. (doc/courbe_Vdetect.ods)

commit c530a0d0fa73b10098a55bc4d818485fff1fe895

 Le modèle est-il valable ? Si non, pourquoi ?
Problème de mesure ? (précision des appareils de mesures utilisés à préciser dans la doc)
Problème de montage du prototype ?
Autre ?

f4bjh, 2019-07-10:
#72

Closed 2019-07-10.

Thread 79 (2019-07-10):

Comparatif des différentes solutions de calibration

f4bjh, 2019-07-10:
1/Par implémentation de routines mathématiques dans le fw de test #67
Afficher le résultat de ce calcul sur le LCD
Relever les temps d'éxecution, et l'afficher sur le LCD
Implémentation du bouton poussoir, initialement prévue pour le commutateur de bande, pour basculer entre l'affichage des ADC, et l'affichage du calcul de P dans le firmware de test
Compatibilité BLU ?

2/Par implémentation d'une table
Quelle taille ?
Combien de table par rapport au choix de la bande de fréquence, choix du calibre, port FWD et REV ?
Besoin d'une EEP Ext ? quel impact sur le choix du MCU ?

=> à reporter dans la spec #23

f4bjh, 2019-07-16:
Peut-être est-ce un faux problème. En effet, le commit 79b8f14  met en évidence que la Square Law Region est atteignable, dans la dynamique de l'ADC.
Du coup, la reltion V=f(P) devient une bête relation linéaire. il suffirait alors juste d'adapter plus ou moins le code DEJA existant (adc_theoric_cal.asm)

Closed 2020-04-23.

Thread 82 (2019-07-11):

Comment fait-on pour répondre sur Github ?

f4bjh, 2019-07-11:
Quand on poste un issue, GitHub envoie un mail aux personnes concernées, avec le contenu de l'issue. Par ex :
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

Pour y répondre, il faut :
1-Cliquer sur "view it on GitHub"
2-Répondre dans l'espace commentaire, située en dessous
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

f4bjh, 2019-07-11:
Est-ce que ça répond à ta question ?

F0EOS, 2019-07-11:
pas connecter donc pas de fenêtre réponse

Closed 2019-07-11.

Thread 84 (2019-07-11):

Dans la 1ère zone de la diode, il faut a<0,13

f4bjh, 2019-07-11:
Contrairement à ce que semble vouloir montrer l'étude du détecteur (où a<0,3 suffirait à avoir une précision de 10%), un rapide tableau dans courbe_Vdetect.ods semble vouloir montrer que a<0,13 par dichotomie

f4bjh, 2019-07-15:
Le problème semble venir d'une confusion entre P0 et P, dans la 1ère zone du détecteur HF.

Maintenant, j'ai rajouté une feuille dans courbe_Vdetect.ods, pour confirmer cela. Et elle montre, à mon grand étonnement, que les autres zones ne conviennent pas aux spécifications que je voulais me fixer. En particulier, cela semble montrer que les points de calibration 10W, et 100W ne sont pas atteignables.

Maintenant, il faut voir aussi que, en utilisant cette méthode, j'ai arbitrairement fixé la 1ère zone de la diode comme étant le point de départ de la dynamique d'entrée. Dans les autres feuilles de calcul, j'utilisais plutôt la 1ème zone, sans pour autant me soucier non plus de la précision finale.

Du coup, tout ça pose quand même un peu un problème de méthode, qui reviennent à se poser la question de #72 #27 et #22

Plusieurs solutions s'offrent à moi :
-continuer dans ce "délire" et voir où cela nous mène. Avec le risque de faire une étude du détecteur HF qui soit beaucoup trop théorique, et faire un système au final qui n'a plus aucun degré de liberté, et qui ne fonctionne pas.
-faire machine arrière, et monter _au hasard_ une diode, et voir ce qui se passe...

Les 2 méthodes ne sont évidemment pas satisfaisantes.
Le problème ayant été bien décrit dans les autres fiches citées ci-dessus, il ne sera pas créé de nouveau bug pour tracer cette difficulté. Eventuellement, par la suite, on fermera la palanquée de bugs liés à ce sujet, pour n'en faire qu'un seul, quand le problème aura été finement et précisemment compris...

Closed 2019-07-15.

Thread 85 (2019-07-12):

Erreur dans la doc : la formule pour le calcul de a dans l'étude du détecteur HF est fausse

f4bjh, 2019-07-12:
Annexe A de SWR_POWER_METER_etude_du_detecteur_HF.ods

Ce n'est pas V1-V0 mais log10(V1) - log10(V0)

f4bjh, 2019-07-15:
commit 08dc2e77a7b60e171f2acf72c15468688d149055

Closed 2019-07-15.

Thread 88 (2019-07-17):

Comment spécifier la Square Law Region en fonction de P ?

f4bjh, 2019-07-17:
Dans le §1.2.2 de l'étude du détecteu HF, je prétends que la square LAw Region correspond à la zone où I=O dans la caratérisitque I-V de la diode...

Rien ne me paraît plus faux...

D'après Radio Frequency & Microwave Power Measurement - Alan Fantom – Chapitre 8, c'est plutôt la zone de tension où l'intérieur de l'exponentielle est égale à 1.

Closed 2020-04-21.

Thread 89 (2019-08-29):

Le K de la simu ne vaut pas le K theorique

f4bjh, 2019-08-29:
Voir l'effet de Rs ?
Et si la square law région était une approximation ? Dans ce cas, quelle est l'erreur de mesure ? Peut on la limiter ? Comment ?

f4bjh, 2019-08-29:
Pour approfondir et mieux cerner la pbmatique, analyser le graphe i v ?

f4bjh, 2019-08-29:
K théorique = le K calculé à partir du DL autour de 0 de i = f(V)

Closed 2020-04-21.

Thread 91 (2020-01-05):

Routage de masse

f4bjh, 2020-01-05:
Placer une via sur la borne "-" de l'alim en entrée.
Eviter la ligne de masse entre C1, C2 et U3, qui risque de faire antenne, et placer des via de masse au plus proche des composants.
Recentrer C4
Dessiner le contour du PCB
A voir (???) : placer un plan de masse en dessous du boitier de U2 (???)

f4bjh, 2020-01-05:
Placer une via de masse sur C4

f4bjh, 2020-03-09:
https://github.com/f8kgl/swr_power_meter/commit/d068d41402ae436b3c028524527057c7facadf2c

Closed 2020-03-09.

Thread 92 (2020-01-06):

Pb de DRC dans le routage

f4bjh, 2020-01-06:
Le résultat de l'analyse des DRC sous Kicad donne des erreurs :

** Drc report for /home/f4bjh/devel/f8kgl/swr_power_meter/src/hw/TOSMETRE.kicad_pcb **
** Created on 2020-01-06 23:36:39 **

** Found 0 DRC errors **

** Found 5 unconnected pads **
ErrType(2): Items non connectés
    @(87,630 mm, 137,160 mm): Via 0,600 mm [GNDREF] sur F.Cu - B.Cu
    @(85,405 mm, 133,350 mm): Piste 0,250 mm [GNDREF] sur couche F.Cu, long.: 0,780 mm
ErrType(2): Items non connectés
    @(100,900 mm, 147,560 mm): Via 0,600 mm [GNDREF] sur F.Cu - B.Cu
    @(99,740 mm, 142,830 mm): Pad 1 de J3 sur Toutes couches cuivre
ErrType(2): Items non connectés
    @(99,260 mm, 140,740 mm): Piste 0,250 mm [GNDREF] sur couche F.Cu, long.: 0,510 mm
    @(100,510 mm, 135,780 mm): Piste 0,250 mm [GNDREF] sur couche F.Cu, long.: 2,050 mm
ErrType(2): Items non connectés
    @(100,610 mm, 133,630 mm): Via 0,600 mm [GNDREF] sur F.Cu - B.Cu
    @(100,710 mm, 125,460 mm): Piste 0,250 mm [GNDREF] sur couche F.Cu, long.: 2,250 mm
ErrType(2): Items non connectés
    @(90,170 mm, 121,920 mm): Pad 2 de U2 sur Toutes couches cuivre
    @(98,550 mm, 121,640 mm): Via 0,600 mm [GNDREF] sur F.Cu - B.Cu

** End of Report **

f4bjh, 2020-03-09:
https://github.com/f8kgl/swr_power_meter/commit/d068d41402ae436b3c028524527057c7facadf2c

Closed 2020-03-09.

Thread 94 (2020-01-08):

EEschéma remonte des erreurs lors du test des règles électriques

f4bjh, 2020-01-08:
Rapport d'erreur (mer. 08 janv. 2020 01:22:08 CET, Encodage UTF8 )

***** Feuille /
ErrType(3): Pin connectée à d'autres pins, mais aucune pin pour la piloter
    @(207,01 mm, 133,35 mm): Pin 1 (Power input) du composant #PWR03 non pilotée (Net 1).
ErrType(3): Pin connectée à d'autres pins, mais aucune pin pour la piloter
    @(196,85 mm, 116,84 mm): Pin 1 (Entrée) du composant U1 non pilotée (Net 6).
ErrType(3): Pin connectée à d'autres pins, mais aucune pin pour la piloter
    @(80,01 mm, 29,21 mm): Pin 1 (Power input) du composant U2 non pilotée (Net 10).
ErrType(2): Pin non connectée (utiliser un marqueur de "non connexion" pour supprimer cette erreur)
    @(144,78 mm, 57,15 mm): La pin 1 (Entrée) du composant U4 est non connectée.
ErrType(2): Pin non connectée (utiliser un marqueur de "non connexion" pour supprimer cette erreur)
    @(168,91 mm, 57,15 mm): La pin 10 (Entrée) du composant U4 est non connectée.
ErrType(2): Pin non connectée (utiliser un marqueur de "non connexion" pour supprimer cette erreur)
    @(144,78 mm, 64,77 mm): La pin 4 (Entrée) du composant U4 est non connectée.
ErrType(2): Pin non connectée (utiliser un marqueur de "non connexion" pour supprimer cette erreur)
    @(144,78 mm, 67,31 mm): La pin 5 (Entrée) du composant U4 est non connectée.
ErrType(2): Pin non connectée (utiliser un marqueur de "non connexion" pour supprimer cette erreur)
    @(168,91 mm, 59,69 mm): La pin 9 (Entrée) du composant U4 est non connectée.
ErrType(2): Pin non connectée (utiliser un marqueur de "non connexion" pour supprimer cette erreur)
    @(201,93 mm, 91,44 mm): La pin 18 (Entrée) du composant U1 est non connectée.
ErrType(2): Pin non connectée (utiliser un marqueur de "non connexion" pour supprimer cette erreur)
    @(219,71 mm, 116,84 mm): La pin 10 (Bidirectionnel) du composant U1 est non connectée.
ErrType(2): Pin non connectée (utiliser un marqueur de "non connexion" pour supprimer cette erreur)
    @(204,47 mm, 91,44 mm): La pin 17 (Entrée) du composant U1 est non connectée.
ErrType(2): Pin non connectée (utiliser un marqueur de "non connexion" pour supprimer cette erreur)
    @(199,39 mm, 91,44 mm): La pin 19 (Entrée) du composant U1 est non connectée.
ErrType(2): Pin non connectée (utiliser un marqueur de "non connexion" pour supprimer cette erreur)
    @(199,39 mm, 116,84 mm): La pin 2 (Entrée) du composant U1 est non connectée.
ErrType(2): Pin non connectée (utiliser un marqueur de "non connexion" pour supprimer cette erreur)
    @(201,93 mm, 116,84 mm): La pin 3 (Bidirectionnel) du composant U1 est non connectée.
ErrType(2): Pin non connectée (utiliser un marqueur de "non connexion" pour supprimer cette erreur)
    @(204,47 mm, 116,84 mm): La pin 4 (Bidirectionnel) du composant U1 est non connectée.
ErrType(2): Pin non connectée (utiliser un marqueur de "non connexion" pour supprimer cette erreur)
    @(214,63 mm, 116,84 mm): La pin 8 (Bidirectionnel) du composant U1 est non connectée.
ErrType(2): Pin non connectée (utiliser un marqueur de "non connexion" pour supprimer cette erreur)
    @(217,17 mm, 116,84 mm): La pin 9 (Bidirectionnel) du composant U1 est non connectée.

** messages ERC: 17  Erreurs 0  Avertissements 17

f4bjh, 2020-01-08:
Pour la plupart, je pense qu'il suffit de placer un marqueur de non connexion...
Mais je n'ai pas tout regardé dans le détail

f4bjh, 2020-03-09:
Pour la plupart, je pense qu'il suffit de placer un marqueur de non connexion...
Mais je n'ai pas tout regardé dans le détail

f4bjh, 2020-03-09:
https://github.com/f8kgl/swr_power_meter/commit/d068d41402ae436b3c028524527057c7facadf2c

f4bjh, 2020-03-09:
Il y a du mieux, il y a moins d'erreur, mais il en reste :

Rapport d'erreur (lun. 09 mars 2020 20:52:09 CET, Encodage UTF8 )

***** Feuille /
ErrType(3): Pin connectée à d'autres pins, mais aucune pin pour la piloter
    @(140,39 mm, 65,25 mm): Pin 1 (Power input) du composant #PWR0101 non pilotée (Net 2).
ErrType(3): Pin connectée à d'autres pins, mais aucune pin pour la piloter
    @(196,85 mm, 116,84 mm): Pin 1 (Entrée) du composant U1 non pilotée (Net 3).
ErrType(3): Pin connectée à d'autres pins, mais aucune pin pour la piloter
    @(80,01 mm, 29,21 mm): Pin 1 (Power input) du composant U2 non pilotée (Net 8).
ErrType(2): Pin non connectée (utiliser un marqueur de "non connexion" pour supprimer cette erreur)
    @(204,47 mm, 91,44 mm): La pin 17 (Entrée) du composant U1 est non connectée.
ErrType(2): Pin non connectée (utiliser un marqueur de "non connexion" pour supprimer cette erreur)
    @(201,93 mm, 91,44 mm): La pin 18 (Entrée) du composant U1 est non connectée.
ErrType(2): Pin non connectée (utiliser un marqueur de "non connexion" pour supprimer cette erreur)
    @(199,39 mm, 91,44 mm): La pin 19 (Entrée) du composant U1 est non connectée.
ErrType(2): Pin non connectée (utiliser un marqueur de "non connexion" pour supprimer cette erreur)
    @(199,39 mm, 116,84 mm): La pin 2 (Entrée) du composant U1 est non connectée.
ErrType(2): Pin non connectée (utiliser un marqueur de "non connexion" pour supprimer cette erreur)
    @(201,93 mm, 116,84 mm): La pin 3 (Bidirectionnel) du composant U1 est non connectée.
ErrType(2): Pin non connectée (utiliser un marqueur de "non connexion" pour supprimer cette erreur)
    @(204,47 mm, 116,84 mm): La pin 4 (Bidirectionnel) du composant U1 est non connectée.
ErrType(2): Pin non connectée (utiliser un marqueur de "non connexion" pour supprimer cette erreur)
    @(214,63 mm, 116,84 mm): La pin 8 (Bidirectionnel) du composant U1 est non connectée.
ErrType(2): Pin non connectée (utiliser un marqueur de "non connexion" pour supprimer cette erreur)
    @(217,17 mm, 116,84 mm): La pin 9 (Bidirectionnel) du composant U1 est non connectée.
ErrType(2): Pin non connectée (utiliser un marqueur de "non connexion" pour supprimer cette erreur)
    @(144,78 mm, 57,15 mm): La pin 1 (Entrée) du composant U4 est non connectée.
ErrType(2): Pin non connectée (utiliser un marqueur de "non connexion" pour supprimer cette erreur)
    @(168,91 mm, 57,15 mm): La pin 10 (Entrée) du composant U4 est non connectée.
ErrType(2): Pin non connectée (utiliser un marqueur de "non connexion" pour supprimer cette erreur)
    @(219,71 mm, 116,84 mm): La pin 10 (Bidirectionnel) du composant U1 est non connectée.
ErrType(2): Pin non connectée (utiliser un marqueur de "non connexion" pour supprimer cette erreur)
    @(144,78 mm, 64,77 mm): La pin 4 (Entrée) du composant U4 est non connectée.
ErrType(2): Pin non connectée (utiliser un marqueur de "non connexion" pour supprimer cette erreur)
    @(144,78 mm, 67,31 mm): La pin 5 (Entrée) du composant U4 est non connectée.
ErrType(2): Pin non connectée (utiliser un marqueur de "non connexion" pour supprimer cette erreur)
    @(168,91 mm, 59,69 mm): La pin 9 (Entrée) du composant U4 est non connectée.

** messages ERC: 17  Erreurs 0  Avertissements 17

F0EOS, 2020-03-09:
Je vais voir avec kicad comment on fait pour le signale en non connecté

J ai pas vu l'option je vais la chercher

----- Mail d'origine -----
De: Fabrice DECROP LONGET <notifications@github.com>
À: f8kgl/swr_power_meter <swr_power_meter@noreply.github.com>
Cc: Andre <F0EOS@FREE.FR>, Assign <assign@noreply.github.com>
Envoyé: Mon, 09 Mar 2020 20:54:27 +0100 (CET)
Objet: Re: [f8kgl/swr_power_meter] EEschéma remonte des erreurs lors du test des règles électriques (#94)

Il y a du mieux, il y a moins d'erreur, mais il en reste :

Rapport d'erreur (lun. 09 mars 2020 20:52:09 CET, Encodage UTF8 )

***** Feuille /

ErrType(3): Pin connectée à d'autres pins, mais aucune pin pour la piloter

 @(140,39 mm, 65,25 mm): Pin 1 (Power input) du composant #PWR0101 non pilotée (Net 2).

ErrType(3): Pin connectée à d'autres pins, mais aucune pin pour la piloter

 @(196,85 mm, 116,84 mm): Pin 1 (Entrée) du composant U1 non pilotée (Net 3).

ErrType(3): Pin connectée à d'autres pins, mais aucune pin pour la piloter

 @(80,01 mm, 29,21 mm): Pin 1 (Power input) du composant U2 non pilotée (Net 8).

ErrType(2): Pin non connectée (utiliser un marqueur de "non connexion" pour supprimer cette erreur)

 @(204,47 mm, 91,44 mm): La pin 17 (Entrée) du composant U1 est non connectée.

ErrType(2): Pin non connectée (utiliser un marqueur de "non connexion" pour supprimer cette erreur)

 @(201,93 mm, 91,44 mm): La pin 18 (Entrée) du composant U1 est non connectée.

ErrType(2): Pin non connectée (utiliser un marqueur de "non connexion" pour supprimer cette erreur)

 @(199,39 mm, 91,44 mm): La pin 19 (Entrée) du composant U1 est non connectée.

ErrType(2): Pin non connectée (utiliser un marqueur de "non connexion" pour supprimer cette erreur)

 @(199,39 mm, 116,84 mm): La pin 2 (Entrée) du composant U1 est non connectée.

ErrType(2): Pin non connectée (utiliser un marqueur de "non connexion" pour supprimer cette erreur)

 @(201,93 mm, 116,84 mm): La pin 3 (Bidirectionnel) du composant U1 est non connectée.

ErrType(2): Pin non connectée (utiliser un marqueur de "non connexion" pour supprimer cette erreur)

 @(204,47 mm, 116,84 mm): La pin 4 (Bidirectionnel) du composant U1 est non connectée.

ErrType(2): Pin non connectée (utiliser un marqueur de "non connexion" pour supprimer cette erreur)

 @(214,63 mm, 116,84 mm): La pin 8 (Bidirectionnel) du composant U1 est non connectée.

ErrType(2): Pin non connectée (utiliser un marqueur de "non connexion" pour supprimer cette erreur)

 @(217,17 mm, 116,84 mm): La pin 9 (Bidirectionnel) du composant U1 est non connectée.

ErrType(2): Pin non connectée (utiliser un marqueur de "non connexion" pour supprimer cette erreur)

 @(144,78 mm, 57,15 mm): La pin 1 (Entrée) du composant U4 est non connectée.

ErrType(2): Pin non connectée (utiliser un marqueur de "non connexion" pour supprimer cette erreur)

 @(168,91 mm, 57,15 mm): La pin 10 (Entrée) du composant U4 est non connectée.

ErrType(2): Pin non connectée (utiliser un marqueur de "non connexion" pour supprimer cette erreur)

 @(219,71 mm, 116,84 mm): La pin 10 (Bidirectionnel) du composant U1 est non connectée.

ErrType(2): Pin non connectée (utiliser un marqueur de "non connexion" pour supprimer cette erreur)

 @(144,78 mm, 64,77 mm): La pin 4 (Entrée) du composant U4 est non connectée.

ErrType(2): Pin non connectée (utiliser un marqueur de "non connexion" pour supprimer cette erreur)

 @(144,78 mm, 67,31 mm): La pin 5 (Entrée) du composant U4 est non connectée.

ErrType(2): Pin non connectée (utiliser un marqueur de "non connexion" pour supprimer cette erreur)

 @(168,91 mm, 59,69 mm): La pin 9 (Entrée) du composant U4 est non connectée.

** messages ERC: 17 Erreurs 0 Avertissements 17

--

You are receiving this because you were assigned.

Reply to this email directly or view it on GitHub:

https://github.com/f8kgl/swr_power_meter/issues/94#issuecomment-596748064

f4bjh, 2020-04-23:
MAJ du DRC suite au commit https://github.com/f8kgl/swr_power_meter/commit/9f2989986ff7ac75562613929bf327e1f65362b7

***** Feuille /
ErrType(3): Pin connectée à d'autres pins, mais aucune pin pour la piloter
    @(72,39 mm, 29,21 mm): Pin 1 (Power input) du composant U2 non pilotée (Net 3).
ErrType(3): Pin connectée à d'autres pins, mais aucune pin pour la piloter
    @(196,85 mm, 116,84 mm): Pin 1 (Entrée) du composant U1 non pilotée (Net 5).
ErrType(3): Pin connectée à d'autres pins, mais aucune pin pour la piloter
    @(165,10 mm, 82,55 mm): Pin 1 (Power input) du composant #PWR0106 non pilotée (Net 7).

F0EOS, 2020-04-23:
sALUT FABRICE

comprends pas trop les erreurs
la pin 1 de U1 est bien connecter a la pin 1 de U3 alors que ton message l'indicque en erreur

en fait je ne sais pas a quoi cela correspond

Andre
Bien recuperer ta livraison

----- Mail original -----
De: "Fabrice DECROP LONGET" <notifications@github.com>
À: "f8kgl/swr_power_meter" <swr_power_meter@noreply.github.com>
Cc: "Andre" <F0EOS@FREE.FR>, "Assign" <assign@noreply.github.com>
Envoyé: Jeudi 23 Avril 2020 21:44:24
Objet: Re: [f8kgl/swr_power_meter] EEschéma remonte des erreurs lors du test des règles électriques (#94)

MAJ du DRC suite au commit 9f29899

***** Feuille /
ErrType(3): Pin connectée à d'autres pins, mais aucune pin pour la piloter
@(72,39 mm, 29,21 mm): Pin 1 (Power input) du composant U2 non pilotée (Net 3).
ErrType(3): Pin connectée à d'autres pins, mais aucune pin pour la piloter
@(196,85 mm, 116,84 mm): Pin 1 (Entrée) du composant U1 non pilotée (Net 5).
ErrType(3): Pin connectée à d'autres pins, mais aucune pin pour la piloter
@(165,10 mm, 82,55 mm): Pin 1 (Power input) du composant #PWR0106 non pilotée (Net 7).

—
You are receiving this because you were assigned.
Reply to this email directly, view it on GitHub , or unsubscribe .

f4bjh, 2020-04-27:
avec le passage en V0.7, les DRC précédents n'ont plus de sens

Closed 2020-04-27.

Thread 96 (2020-03-09):

Supprimer le connecteur de programmation

f4bjh, 2020-03-09:
A voir : supprimer le connecteur de programmation ??? et profiter du connecteur LCD pour le flashage du PIC ?

Auquel cas, il faudra peut-être déplacer la pin de masse du LCD...mais c'est peut-être pas obligatoire. Et à la limite, spécifier dans la doc le cable du programmateur qui sera un connecteur 8 broches, mais pour lequel seuls 4 broches seront effectivement cablé vers le PC...

A étudier de plus près...car l'avantage serait d'avoir un connecteur en moins, allégerait grandement le routage...enfin bref, plein d'avantages !!!

f4bjh, 2020-05-07:
#110

f4bjh, 2020-05-26:
1/supprimer J3
2/correction schéma LCD : suivre ce branchement :
pin LCD RS -> RB2
pin LCD_E -> RB3
pin LCD_D4 ->RB4
pin LCD_D5 ->RB5
pin LCD_D6 ->RB6
pin LCD_D7 ->RB7

3/on utilisera J4 pour programmer le PIC et l'EEP
=>chercher sur le net comment on pourrait programmer un PIC et une EEP I2C via une Raspberry Pi

4/spécifier et cabler les broches de J4 en conséquence pour la partie programmateur

f4bjh, 2020-05-28:
Dans l'état actuel des specs, si on cable RS et E sur RB2 et RB3 (respectivement), il va y avoir croisement avec le VDD du PIC

==> à déplacer sur RB0, RB1
spec à modifier + regénérer les PDF #261
implémentation dans le fw, et breadboard  #262
modif schéma #263

Closed 2020-06-16.

Thread 98 (2020-04-04):

connection MAX11100

F0EOS, 2020-04-04:
est ce que la borne 6 ( ref )  du max11100  il y a que le C4 ou faut il aussi autre chose a connecter dessus

Voir ligne sur le schéma dans le vide, je ne sais pas si c'est une erreur de ma part ou si j'ai oublier de connecter qque chose a la fin

f4bjh, 2020-04-04:
OK, je vais regarder ça très prochainement.

F0EOS, 2020-04-04:
j'ai cemessage quand j'ouvre le projet avec kicad

----- Mail original -----
De: "Fabrice DECROP LONGET" <notifications@github.com>
À: "f8kgl/swr_power_meter" <swr_power_meter@noreply.github.com>
Cc: "Andre" <F0EOS@FREE.FR>, "Author" <author@noreply.github.com>
Envoyé: Samedi 4 Avril 2020 16:52:11
Objet: Re: [f8kgl/swr_power_meter] connection MAX11100  (#98)

OK, je vais regarder ça très prochainement.

—
You are receiving this because you authored the thread.
Reply to this email directly, view it on GitHub , or unsubscribe .

f4bjh, 2020-04-05:
Il faut créer une autre fiche pour cela...sinon, on risque de tout mélanger...

f4bjh, 2020-04-23:
Il y a des erreurs de cablage sur U4 (MAX11100)

1/il faut relier SCLK(pin 10), CS (pin 9), OUT (pin 1) à des pins encore libre du PIC.
Parmi les disponibles il y a : 2,3,4, 8,9,10,17,18,19
Choisir celle qui facilite le routage.

2/relier AGND (pin 8) à la masse
3/déconnecter la pin 1 du PIC pour la mettre sur la pin AIN(pin 5) du MAX11100

f4bjh, 2020-04-23:
Attention : Erreur sur le point 3/
Laisser la pin 1 du PIC telle quelle est cablée aujourd'hui
Mais cabler la pin 5 de U3 sur la pin 5 de U4

F0EOS, 2020-04-23:
a l'occas on s'apelle  parce que sur U4 il y a que 10 bornes

pas de borne 17-18-19

----- Mail original -----
De: "Fabrice DECROP LONGET" <notifications@github.com>
À: "f8kgl/swr_power_meter" <swr_power_meter@noreply.github.com>
Cc: "Andre" <F0EOS@FREE.FR>, "Author" <author@noreply.github.com>
Envoyé: Jeudi 23 Avril 2020 21:52:42
Objet: Re: [f8kgl/swr_power_meter] connection MAX11100  (#98)

Il y a des erreurs de cablage sur U4 (MAX11100)

1/il faut relier SCLK(pin 10), CS (pin 9), OUT (pin 1) à des pins encore libre du PIC.
Parmi les disponibles il y a : 2,3,4, 8,9,10,17,18,19
Choisir celle qui facilite le routage.

2/relier AGND (pin 8) à la masse
3/déconnecter la pin 1 du PIC pour la mettre sur la pin AIN(pin 5) du MAX11100

—
You are receiving this because you authored the thread.
Reply to this email directly, view it on GitHub , or unsubscribe .

f4bjh, 2020-04-23:
les pin 2,3,4, 8,9,10,17,18,19 sont les pin disponibles du PIC
il faut relier les pin 1, 9 10 de U4 à l'une des pin du PIC encore disponibles. Choisir celles qui facilitent le routage

f4bjh, 2020-04-27:
En prévision du tag V0.6, cette fiche ne sera pas résolue (évolution de U4 à définir)

Closed 2020-04-27.

Thread 99 (2020-04-21):

Théorie de la "Square Law Region" non validée en simu et en pratique

f4bjh, 2020-04-21:
Suite à ce commit : https://github.com/f8kgl/swr_power_meter/commit/b7ac412a5245403de885ab061d53094d28445feb

La Square Law Region est à présent bien délimitée : Pin < -22dBm
De plus, la relation V=f(P) est bien justifée.

On observe cependant des différences non négligeables entre les résultats de cette théorie, et la simulation, et la pratique (ces 2 dernières étant d'ailleurs assez proches...)

Pourquoi ???

f4bjh, 2020-04-21:
https://ham.stackexchange.com/questions/16499/problem-with-theory-of-hf-detector

f4bjh, 2020-04-22:
1/il faudrait tout de même éclaircir l'étude =>
1.1-faire une étude plus approfondie de la diode schottky :
1.1.1-il existe une zone square law region (avec sa justification fondée sur le DL autour de 0 de la caractérisitque i-v). Donne P=KxV, avec K=... Faire une A.N.
1.1.2-que se passe t'il au-delà (mathématiquement parlant) de la square law region
1.2/résultat plus exhaustif de la simu. Comment le présenter ?
1.3/résultat plus exhaustif des mesures : faire une mesure à 100MHz et 500MHz. Faire une mesure avec la BAT54 et HSMS2822
1.4/faire un § sur les pb de mesures liés au bruit de l'oscillo => limitation dans les mesures
=>faut-il enivsager de faire un milli-voltmètre (voire micro ?)

f4bjh, 2020-04-23:
1/les données constructeurs des diodes ne permettent pas de déterminer le n d'une diode. Il faut se fier aux modèles Qucs, dès lors qu'il offre une bonne approximation de la mesure pratique
A côté de cela, la simu sous Qucs ne permet pas d'atteindre la Square Law Region
Avec mes moyens de mesures, je ne peux pas l'atteindre non plus...il faudrait pouvoir mesurer des microvolts...

f4bjh, 2020-04-23:
si j'arrive à atteindre la SLR en simulation, et que j'arrive à confirmer la SLR par la mesure, alors, il faudra que la dynamique d'entrée tombe dans cette zone !!!

f4bjh, 2020-04-23:
Le seul moyen, a priori, pour atteindre la SLR par la mesure, est de disposer d'un microvoltmètre...ou bien de faire le proto

Closed 2020-04-23.

Thread 101 (2020-04-23):

Kicad fait une erreur au démarrage

f4bjh, 2020-04-23:
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

f4bjh, 2020-04-23:
Visiblement, est apparu avec ce commit : https://github.com/f8kgl/swr_power_meter/commit/f18413c56c2a7412bc5f6d7ad0c81c7bb11e8d8b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

On dirait que le résultat d'un diff a été livré dans ce fichier.
=> suppression manuelle

f4bjh, 2020-04-26:
André, tu me confirmes que ce message d'erreur a bien disparu chez toi aussi ?

f4bjh, 2020-04-27:
André, est-ce que tu as toujours cette erreur ? (il faut que tu viennes voir cette fiche sur Github, pour me le confirmer ou pas...j'ai besoin de savoir si je peux ferme cette fiche ou pas, pour poser un tag)

F0EOS, 2020-04-27:
je n'ai plus ce message d'erreur mais un autre

Closed 2020-04-27.

Thread 102 (2020-04-23):

j'ai cemessage quand j'ouvre le projet avec kicad

f4bjh, 2020-04-23:
j'ai cemessage quand j'ouvre le projet avec kicad

----- Mail original -----
De: "Fabrice DECROP LONGET" <notifications@github.com>
À: "f8kgl/swr_power_meter" <swr_power_meter@noreply.github.com>
Cc: "Andre" <F0EOS@FREE.FR>, "Author" <author@noreply.github.com>
Envoyé: Samedi 4 Avril 2020 16:52:11
Objet: Re: [f8kgl/swr_power_meter] connection MAX11100  (#98)

OK, je vais regarder ça très prochainement.

—
You are receiving this because you authored the thread.
Reply to this email directly, view it on GitHub , or unsubscribe .

_Originally posted by @F0EOS in https://github.com/f8kgl/swr_power_meter/issues/98#issuecomment-609090181_

f4bjh, 2020-04-23:
#101

Closed 2020-04-23.

Thread 103 (2020-04-23):

Terminer l'étude du détecteur

f4bjh, 2020-04-23:
1/prototyper un coupleur
2/mesurer la BAT54 et HSMS2822 (en dehors de la SLR malheureusement...
3/compléter avec des mesures à 100MHz et 500MHz

f4bjh, 2020-04-23:
et 4/envisager l'ajout d'AOP en option non monté le cas échéant (montage suiveur ?)

f4bjh, 2020-04-27:
réouvert, pour compléter les mesures de la 3ème BAS70
+ les mesures de la BAT54
et HSMS2822
MAJ des conclusions DEFINITIVE

f4bjh, 2020-04-27:
hsms2822 abandonnée pour des raisons d'apprp

Closed 2020-04-27.

Thread 104 (2020-04-23):

Spécifier la stratégie de calibration

f4bjh, 2020-04-23:
Etablir une stratégie pour la calibration du SWR POWER METER F8KGL à partir des tests qui seront fait sur le prototype.
Editer une doc en conséquence

f4bjh, 2020-04-26:
#107

f4bjh, 2020-04-26:
Il ressort une calibration qui prendrait l'allure suivante :
2 points de calibration -20dBm, et -50dBm (30dB de dynamique pour avoir un Pmin=1W, et Pmax=500W)
Voir regression_diode2 pour voir les formules à mettre en jeu dans le PIC

f4bjh, 2020-05-06:
En simu, à l'issue du merge de la branche i2c_test

A valider sur prototype, bien entendu...

f4bjh, 2020-05-06:
https://github.com/f8kgl/swr_power_meter/blob/master/doc/SWR_POWER_METER_F8KGL_Principe_de_calibration_v0.7.odt

f4bjh, 2020-05-07:
#112

Closed 2020-05-26.

Thread 106 (2020-04-26):

Impossible de livrer sur github avec Turtoise git

f4bjh, 2020-04-26:
A de nombreuses tentatives de livraison avec Turtoise git, cette erreur apparaît :

error: failed to push some refs to 'https://github.com/f8kgl/swr_power_meter'
hint: Updates were rejected because the remote contains work that you do
hint: not have locally. This is usually caused by another repository pushing
hint: to the same ref. You may want to first integrate the remote changes
hint: (e.g., 'git pull ...') before pushing again.
hint: See the 'Note about fast-forwards' in 'git push --help' for details.

Mais ce n'est pas systématique

f4bjh, 2020-04-26:
J'ai ajouté un texte en plein milieu du schéma.
A voir si tu arrives à bien le télécharger avec Turtoise Git.
Le message contient une phrase du style "Texte de test pour André. A supprimer quand la fiche #106 sera résolue"
Ensuite, le supprimer, et relivrer pour voir si ça marche.

f4bjh, 2020-04-26:
référence https://github.com/f8kgl/swr_power_meter/commit/920d66d8e337184d50d51a6e84954f5b0fb8cc69 ci-dessus erronée

F0EOS, 2020-04-26:
nickel pas eu de souci cette fois

Pourvu que ca dure ....

Closed 2020-04-26.

Thread 107 (2020-04-26):

Pmax détecteur en entrée <-20dBm

f4bjh, 2020-04-26:
Rajouter cette conclusion à l'étude du détecteur (suite à https://github.com/f8kgl/swr_power_meter/commit/05c36b9599310062dedfc39fc79ad0e244df730b)

Permet d'élaborer un début de stratégie pour la calibration

Closed 2020-04-26.

Thread 108 (2020-04-27):

Dispersion de la diode Schottky

f4bjh, 2020-04-27:
3 mesures de la BAS70H ont été effectuées.
La première a montré que la zone linéaire était largement en dessous des -20dBm ==> impossible à calibrer ?

Faut-il envisager de fournir plusieurs dans le kit si ça ne fonctionne pas ??? bof bof hein...

f4bjh, 2020-04-27:
Pour cette diode, il faudrait sans doute revoir les a et b par défaut (case J2 et J3 de la feuille "calibrtion" dans detecteur_HF.ods)

De plus, j'ai grandement amélioré le syst-me de mesure, en faisaint une moyenne sur 512 échantillons (§4.2.1 de l'étude du détecteur)

on va pas trop s'affoler là dessus pour le moment...mais à surveiller quand même...

Closed 2021-03-08.

Thread 110 (2020-04-27):

La table de calibration ne rentre pas dans la mémoire du PIC !!!

f4bjh, 2020-04-27:

f4bjh, 2020-04-27:
peut-être que si en fait : voir src/sw/data/adc_theoric_cal.asm

Mais il faut 4096 octets...

f4bjh, 2020-05-04:
et non...car
le port FWD prendra à lui tout seul 2x4096 octets (ADC sur 12 bits)
Idem sur le port REF
Ce qui fait déjà 16ko
et la table de calcul du SWR, qui elle aussi prendre 16ko a priori...

==>implémentation d'une EEP obligatoire.
A spécifier et implémenter

f4bjh, 2020-05-06:
et une table par bande de fréquence.
Il y a 3 bande de fréquence (déca, vhf, uhf)
=>3 x 32ko = 96ko

f4bjh, 2020-05-06:
à 25kHz, pour transmettre 1 octet, il faut 8/25000 = 320us
Pour 96ko, il faut environ 30s => BEAUCOUP TROP LONG !!!

f4bjh, 2020-05-07:
#149

Closed 2020-05-26.

Thread 112 (2020-04-27):

Outil de calibration

f4bjh, 2020-04-27:
A prévoir : développer un outil de calibration (en python ?)

Specs non ehauxtive :
interface graphique convivale
donne les étapes de la calibration (mettre sous tension le SWR POWER METER)
Commncer par le port FWD, et calibrer le gain avec un bouton poussoir
Inscrire la puissance lue par le SWR POWER METER
l'outil calcule la table de calibration et génère le .hex

A prévoir aussi (en marge) un .hex de DE-calibration au cas où...

f4bjh, 2020-05-07:
L'outil de calibration devra tourner une raspberry (ou qqc de plus ou moins équivalent), dans le but de pouvoir programmer la mémoire avec la table de calibration

f4bjh, 2020-05-07:
#146

f4bjh, 2021-04-05:
la spec du calibrator pour le fw de test a été faite https://github.com/f8kgl/swr_power_meter/commit/6cc2faf1f6a761a20fc0b531e3eac7de9b20d01a

reste celle du fw xWATT et SWR_POWER_METER (qui évidemment s'inspirera de celui du fw de test)
la seule différence sera de faire une interface graphique (en Java, a priori...la moins mauvaise solution, pour être multi plateforme a priori)

Thread 113 (2020-04-27):

Poser un tag V0.6

f4bjh, 2020-04-27:
https://git-scm.com/book/fr/v2/Les-bases-de-Git-%C3%89tiquetage

et écrire les specs/implémentation du la chaîne AD5175 LT1818 LTC2305 avec la méthode F1FDD pour les symboles du schéma
rajouter les diodes au schéma
rajouter des connecteurs HF au schéma en entrée

Faire une fiche pour chaque évolution

f4bjh, 2020-04-28:
prévoir 2 empreintes pour la diode ? BAT54 et BAS70 ?

f4bjh, 2020-04-28:
$ git tag -a v0.6 -m "Tag V0.6"
$ git tag
$ git show v0.6
$ git push origin v0.6

https://github.com/f8kgl/swr_power_meter/commit/d6969be17645d152cd1df1a305ba0f0a995dc627

Closed 2020-04-28.

Thread 114 (2020-04-28):

Implémenter SMA à souder sur PCB

f4bjh, 2020-04-28:
Suit au commit : https://github.com/f8kgl/swr_power_meter/commit/bfd3c7d02aea68ed0f56012884240e023a793387

Implémenter 2 fiches SMA à souder sur PCB pour les entrées "signal transmis" et signal réfléchi

Voir p5 §1.3 de https://github.com/f8kgl/swr_power_meter/blob/master/doc/SWR_POWER_METER_F8KGL_implementation_v0.7.pdf

f4bjh, 2020-05-02:
NE vaudrait-il pas mieux des SMA coudés ?

Et idéalement, des SMA ne nécessitant pas de perçage du circuit imprimé...

Enfin...je pense...à voir

Closed 2020-05-13.

Thread 115 (2020-04-28):

Implémenter les boutons

f4bjh, 2020-04-28:
Suite au commit https://github.com/f8kgl/swr_power_meter/commit/9dbf88e6ae1ed61137ce3cdc3c19a4f8113eb1b9

Implémenter les 2 boutons :
M/A pour le pack pile
Sélectionneur de bande

Voir p6 de la doc d'implémentation V0.7

f4bjh, 2020-04-28:
Commencer par définir l'interrupteut et le bouton poussoir que l'on peut mettre...

f4bjh, 2020-05-06:
Pour les boutons de calibration (+ et -), voir pour des boutons styles reste de systèmes informatiques.

Référence chez Radiospares par exemple ?

f4bjh, 2020-06-10:
référence à https://github.com/f8kgl/swr_power_meter/commit/610a26f6fd7f428eeca2596b70bb2eefd70e7606 ci-dessus erronée

f4bjh, 2021-02-18:
#144

Closed 2021-02-18.

Thread 116 (2020-04-28):

Implémenter le détecteur HF

f4bjh, 2020-04-28:
Suit au commit : https://github.com/f8kgl/swr_power_meter/commit/6d290e5a1f2a643e5bfda914ce97e8314124ebf6

Implémenter le détecteur HF avec BAT54 et C=47nF

Voir §3 de la doc d'implémentation : https://github.com/f8kgl/swr_power_meter/blob/master/doc/SWR_POWER_METER_F8KGL_implementation_v0.7.pdf

Spec de la diode : https://github.com/f8kgl/swr_power_meter/blob/master/src/hw/doc/BAT54XV2T1-D.PDF

f4bjh, 2020-04-28:
Pour l'ensemble des fiches #116, #117, #118, #119, je conseille de refaire le symbole du schéma.

Et faire un symbole de schéma qui a le même graphisme que le brochage physique du composant

f4bjh, 2020-05-01:
Voir §3 de la doc d'implémentation : /doc/SWR_POWER_METER_F8KGL_implementation_v0.7.pdf

Spec de la diode : src/hw/doc/BAT54XV2T1-D.PDF

f4bjh, 2020-05-02:
commit https://github.com/f8kgl/swr_power_meter/commit/5e20d087154450a3c2901e72d68861422602fdd7

1/La diode du port FWD n'est pas dans le bon sens
2/les capa ne sont pas au bon endroit (extrait p8 de la doc d'implémentation) :
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

f4bjh, 2020-05-02:
mail du 2/5/2020 (F0EOS->F4BJH)

>un truc m'echappe
>on est ok pour dire que FWD c'est la puissance envoye dans l'antenne ?
Oui
>donc si je met la diode dans l'autre sens rien n'arrivera a l'antenne
Pourquoi ? Où se connecte l'antenne sur le tosmètre ?

Voir les 2 liens ci-dessous :

https://f5zv.pagesperso-orange.fr/RADIO/RM/RM07/RM07g/RM07g01.html

https://fr.qwe.wiki/wiki/Power_dividers_and_directional_couplers

https://www.google.com/url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

f4bjh, 2020-05-06:
Est-ce qu'on est d'accord à présent ?
As-tu bien vu où se connecte précisemment l'antenne ?

f4bjh, 2020-05-07:
#150

Closed 2020-05-13.

Thread 117 (2020-04-28):

Rappel théorique sur les AOP

f4bjh, 2020-04-28:
Dans la doc d'implémentation, decrire un montage non inverseur à base d'amplificateur opérationnel.

Rappeler la formule mathématique reliant la tension de sortie à la tension d'entrée.

Ajouter tout cela dans le §4.1

(ça fait des révisions pour la licence F4 ;-)

f4bjh, 2020-05-06:
Un peu d'aide pour avancer :

http://electronique.aop.free.fr/AOP_lineaire_NF/2_ampli_noninverseur.html

Closed 2020-05-13.

Thread 118 (2020-04-28):

Implémenter les AOP

f4bjh, 2020-04-28:
Suite au commit : https://github.com/f8kgl/swr_power_meter/commit/e3ef3defbd792d0cd920f6b37f88479c1f33cbd2
et
https://github.com/f8kgl/swr_power_meter/commit/0891d1b8b24284d6a6c6991e1124c92b494ceeec

Implémenter l'ampli avec AD5175 et LT1818

Voir §4 de la doc d'implémentation : https://github.com/f8kgl/swr_power_meter/blob/master/doc/SWR_POWER_METER_F8KGL_implementation_v0.7.pdf

Doc de l'AD5175 : https://github.com/f8kgl/swr_power_meter/blob/master/src/hw/doc/AD5175.pdf
Doc du LT1818 : https://github.com/f8kgl/swr_power_meter/blob/master/src/hw/doc/lt1818.pdf

f4bjh, 2020-05-08:
Comme promis, André, on va faire les choses étapes par étapes, si tu veux bien...

f4bjh, 2020-05-08:
Pour commencer, conformément à la doc d'implémentation, le tosmètre comprend les élements suivants :

coupleur directif
détecteur HF (à base de BAT54)
un AOP (AD5175 + LT1818)
un ADC (LTC2305)
un PIC (18F1320)
Pour les besoins de cette fiche, et pour simplifier dans un 1er temps le problème, je ne précise pas connecteurs, le régulateurs, les boutons (etc...). Ci-dessus, il n'y a que les éléments principaux qui assurent la fonction générale de tosmètre.

Dans cette fiche, on se concentre uniquement sur l'AOP : AD5175+LT1818

f4bjh, 2020-05-08:
#155

f4bjh, 2020-05-08:
Pour résoudre la fiche globale, on va procéder étape par étape :

1ère étape : résoudre la fiche #155

f4bjh, 2020-05-09:
Je réponds à tes questions dans cette fiche là (118) :

-faut-il faire une sauvegarde avant de faire des modifs ?
Non. Car git est déjà la sauvegarde, et il est possible de revenir en arrière ("faire un revert") le cas échéant

-faut-il résoudre les fiches au schéma ou pcb, ou les 2 ?
Uniquement au schéma pour le moment

-faut-il générer la netliste après chaque modif ?
Non. Il faut générer la netlist quand le schéma est terminé

f4bjh, 2020-05-10:
Ok !!! C'est parfait. J'ai fait un petit peu de nettoyage supplémentaire dans https://github.com/f8kgl/swr_power_meter/commit/850bf9735af4f7b1d25c55a9879cc933534f86cd

A présent 2ème étape : résoudre la fiche #164

f4bjh, 2020-05-10:
3ème étape : la fiche #168

Mais l'étape suivante sera tout à fait différente...

f4bjh, 2020-05-16:
Tout ça est vraiment parfait !!!

On peut passer à l'étape suivante. Je créée une nouvelle fiche pour t'expliquer ce qu'il faut faire ensuite.

Closed 2020-05-18.

Thread 119 (2020-04-28):

Implémenter l'ADC

f4bjh, 2020-04-28:
Suite au commit : https://github.com/f8kgl/swr_power_meter/commit/5b55b81b6252ab78efbab2f0efc440238d4f107c

Implémenter l'ADC LTC2305

Voir §5 de la doc d'implémentation https://github.com/f8kgl/swr_power_meter/blob/master/doc/SWR_POWER_METER_F8KGL_implementation_v0.7.pdf

Doc du LTC2305 : https://github.com/f8kgl/swr_power_meter/blob/master/src/hw/doc/ltc2305.pdf

f4bjh, 2020-05-01:
J'ai oublié de mettre des résistances de "pull up" sur le bus I2C dans la doc d'implémentation...

Voir içi : http://manubatbat.free.fr/robot/Doc/I2C/I2C.HTM
On va prendre des résistances de 10k, format 1206

Closed 2020-05-26.

Thread 120 (2020-04-28):

Driver ADC

f4bjh, 2020-04-28:

f4bjh, 2020-04-28:
commencer par implémenter l'ADC sous gpsim

f4bjh, 2020-04-28:
Mon analyse pour la mise en oeuvre du LTC2305 sous gpsim :

Exemple : composant i2c2par

Côté I2C, les données doivent passer, à un moment donné, par gpsim-0.30.0/src/i2c-ee.cc qui fait appel à get_data ou put_data.
Ces fonctions sont codées dans modules/i2c2par.cc, qui va charcher les données sur un "IOPort"

Du coup, ce qui vaudrait le coup ce serait :
1/créer une branche sur le projet pour les developpements i2c
2/dans cette branche :
2.1/mettre en oeuvre un driver i2c2par dans le PIC, qui récupère les valeurs du IOPort (fixé à une valeur sur 8 bits, par 01010101 (ou autre peu importe) => vérifier que l'on arrive bien à récupérer la valeur attendue
2.2/créer un nouveau composant stricitement identique à i2c2par, et refaire cette manip
2.3/faire évoluer le composant pour changer IOPort en un port qui reçoit une tension et la converti directement en hexa. La récupérer dans le PIC.

Question : faut-il refaire un make et make install de gpsim après modif d'un composant ?
j'ai installé gpsim par apt-get. Faut-il le désinstaller du coup ?

f4bjh, 2020-04-30:
Régression avec ce commit https://github.com/f8kgl/swr_power_meter/commit/15b4c0a44294a39fe523f65b056f44dc60ba33b1

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

Retour du pb de PCLATH ? #122

f4bjh, 2020-05-02:
-->1/créer une branche sur le projet pour les developpements i2c
implémenté et validé (branche i2c_test)

-->2/dans cette branche :
-->2.1/mettre en oeuvre un driver i2c2par dans le PIC, qui récupère les valeurs du IOPort (fixé à une valeur sur 8 bits, par 01010101 (ou autre peu importe) => vérifier que l'on arrive bien à récupérer la valeur attendue

en cours
pb n°1 : impossible de driver SDA et SCL de i2c2par #131
pb n°2 : plantage du PIC. Bloqué en PCL=0x0CE0 #130

-->2.2/créer un nouveau composant stricitement identique à i2c2par, et refaire cette manip
-->2.3/faire évoluer le composant pour changer IOPort en un port qui reçoit une tension et la converti directement en hexa. La récupérer dans le PIC.

Non commencés

f4bjh, 2020-05-04:
-->2/dans cette branche :
-->2.1/mettre en oeuvre un driver i2c2par dans le PIC, qui récupère les valeurs du IOPort (fixé à une valeur sur 8 bits, par 01010101 (ou autre peu importe) => vérifier que l'on arrive bien à récupérer la valeur attendue

pb n°3 : la sortie de i2c2par vaut 0xD5 au lieu de 0xAA #132

f4bjh, 2020-05-04:
pb n°4 : SCL=400kHz ??? #133

f4bjh, 2020-05-04:
Pour créer une nouvelle librairie et un nouveau composant :
1/créer un ficher source librairie.cc (sur le modèle de libgpsim_modules.cc)
2/créer un fichier source module.cc (sur le modèle de i2c2par.cc)
3/Adapter le Makefile.am (ajout de la librairie et du module)
4/
$cd .../gpsim.0.31
$ autoreconf
$./configure
$make
$sudo make install
$sudo /sbin/ldconfig

f4bjh, 2020-05-04:
-->1/créer une branche sur le projet pour les developpements i2c
implémenté et validé (branche i2c_test)

-->2/dans cette branche :
-->2.1/mettre en oeuvre un driver i2c2par dans le PIC, qui récupère les valeurs du IOPort (fixé à une valeur sur 8 bits, par 01010101 (ou autre peu importe) => vérifier que l'on arrive bien à récupérer la valeur attendue

implémenté et validé (branche i2c_test)

-->2.2/créer un nouveau composant stricitement identique à i2c2par, et refaire cette manip
implémenté et validé (branche i2c_test)
avec malgré un petit souci non rédhibitoire a priori : #136
-->2.3/faire évoluer le composant pour changer IOPort en un port qui reçoit une tension et la converti directement en hexa. La récupérer dans le PIC.

f4bjh, 2020-05-05:
Pour rappel içi, pour placer un scope sous gpsim :

**gpsim> scope.ch0="porta3"
**gpsim> scope.ch1="porta2"

f4bjh, 2020-05-05:
reste à implémenter :

1/CH1
2/les octets de commande du ltc2305

F0EOS, 2020-05-05:
c est quoi tout ces composant que je vois defile

Ca sera a rajouter ?

Il va falloir faire du 2 face on ne pourrapas faire tout tenir sur une

----- Mail d'origine -----
De: Fabrice DECROP LONGET <notifications@github.com>
À: f8kgl/swr_power_meter <swr_power_meter@noreply.github.com>
Cc: Andre <F0EOS@FREE.FR>, Comment <comment@noreply.github.com>
Envoyé: Tue, 05 May 2020 21:12:33 +0200 (CEST)
Objet: Re: [f8kgl/swr_power_meter] Driver ADC (#120)

Pour rappel içi, pour placer un scope sous gpsim :

**gpsim> scope.ch0="porta3"

**gpsim> scope.ch1="porta2"

--

You are receiving this because you commented.

Reply to this email directly or view it on GitHub:

https://github.com/f8kgl/swr_power_meter/issues/120#issuecomment-624251174

f4bjh, 2020-05-06:
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

Tu n'es pas concerné par tout ça...c'est la simulation sous gpsim...

f4bjh, 2020-05-06:
il manque encore la table de calibration de test

f4bjh, 2020-05-11:
référence à 142 ci-dessus eronnée

f4bjh, 2020-05-11:
https://github.com/f8kgl/swr_power_meter/commit/5d00e68406ee17e5fcb0c368d43a4d25a3c3e9fb

restrictions non bloquantes d'ores et déjà connues (liées à gpsim a priori) :
-pas de tempo pour la conversion (normalement, 1,3us) #180
-1ère trame renvoie NACK #134 #159

A faire apparaître dans la doc d'implémentation V0.7

f4bjh, 2020-05-13:
et à reporter sur la doc V0.8

Closed 2020-05-26.

Thread 121 (2020-04-28):

Driver potentiomètre digital

f4bjh, 2020-04-28:

f4bjh, 2020-05-06:
pb de link :

usr/bin/ld: .libs/ltc2305.o: in function `IOPort::IOPort(unsigned int)':
/home/f4bjh/devel/tools/gpsim-0.31.0/modules/ltc2305.cc:91: multiple definition of `IOPort::IOPort(unsigned int)'; .libs/ad5175.o:/home/f4bjh/devel/tools/gpsim-0.31.0/modules/ad5175.cc:91: first defined here
/usr/bin/ld: .libs/ltc2305.o: in function `IOPort::IOPort(unsigned int)':
/home/f4bjh/devel/tools/gpsim-0.31.0/modules/ltc2305.cc:91: multiple definition of `IOPort::IOPort(unsigned int)'; .libs/ad5175.o:/home/f4bjh/devel/tools/gpsim-0.31.0/modules/ad5175.cc:91: first defined here
/usr/bin/ld: .libs/ltc2305.o: in function `IOPort::put(unsigned int)':
/home/f4bjh/devel/tools/gpsim-0.31.0/modules/ltc2305.cc:104: multiple definition of `IOPort::put(unsigned int)'; .libs/ad5175.o:/home/f4bjh/devel/tools/gpsim-0.31.0/modules/ad5175.cc:98: first defined here
/usr/bin/ld: .libs/ltc2305.o: in function `IOPort::get()':
/home/f4bjh/devel/tools/gpsim-0.31.0/modules/ltc2305.cc:109: multiple definition of `IOPort::get()'; .libs/ad5175.o:/home/f4bjh/devel/tools/gpsim-0.31.0/modules/ad5175.cc:131: first defined here
/usr/bin/ld: .libs/ltc2305.o: in function `IOPort::update_pin_directions(unsigned int)':
/home/f4bjh/devel/tools/gpsim-0.31.0/modules/ltc2305.cc:171: multiple definition of `IOPort::update_pin_directions(unsigned int)'; .libs/ad5175.o:/home/f4bjh/devel/tools/gpsim-0.31.0/modules/ad5175.cc:135: first defined here
collect2: error: ld returned 1 exit status
make[2]: *** [Makefile:490: lib_swrpowermeterf8kgl_modules.la] Error 1
make[2] : on quitte le répertoire « /home/f4bjh/devel/tools/gpsim-0.31.0/modules »
make[1]: *** [Makefile:450: all-recursive] Error 1
make[1] : on quitte le répertoire « /home/f4bjh/devel/tools/gpsim-0.31.0 »
make: *** [Makefile:380: all] Error 2

f4bjh, 2020-05-07:
#140

f4bjh, 2020-05-07:
#151

f4bjh, 2020-05-07:
#152

f4bjh, 2020-05-09:
#156 non bloquant a priori

f4bjh, 2020-05-09:
#157 bloquant

f4bjh, 2020-05-09:
#158 non bloquant

f4bjh, 2020-05-09:
#134 non bloquant grâce au flag DEBUG_ISSUE_134
 #159

f4bjh, 2020-05-09:
#161

f4bjh, 2020-05-10:
#167 bloquant

f4bjh, 2020-05-11:
https://github.com/f8kgl/swr_power_meter/commit/5d00e68406ee17e5fcb0c368d43a4d25a3c3e9fb

restrictions non bloquantes d'ores et déjà connues (liées à gpsim a priori) :
-pas de MAJ de la tension d'entrée à la volée #158
-pas de tempo pour la conversion (normalement, 1,3us) #180
-1ère trame renvoie NACK #134 #159

A faire apparaître dans la doc d'implémentation V0.7

f4bjh, 2020-05-13:
et à reporter sur la doc V0.8

Closed 2020-05-26.

Thread 122 (2020-04-30):

PCLATH est-il toujours nécessaire ?

f4bjh, 2020-04-30:
Il reste une trace de PCLATH dans lcd/driver.asm

Est-il nécessaire de le garder ? Le mettre en commentaire bloque le LCD à l'affichage du message de boot... => oui ?

A vérifier dans le mapping du code, si l'octet de poids fort de la fonction f_lcd_convtoascii est à 1 ou pas ....

f4bjh, 2020-05-01:
La réponse est oui : #128

Closed 2020-05-01.

Thread 123 (2020-04-30):

mise a jour DATASHEET

F0EOS, 2020-04-30:
recuperation datasheet BAT54 et AD5175

Manque LT818 je compte sur toi pour le mettre  dans le dossier

je le trouve pas, il y a des LT 8XX mais pas de 818

f4bjh, 2020-05-01:
>recuperation datasheet BAT54 et AD5175
Attention : éviter de mettre des espaces dans les noms de fichier.
De plus, la datasheet que tu as récupéré de la BAT54, n'est pas celle que j'ai mise dans la documentation d'implémentation : https://github.com/f8kgl/swr_power_meter/blob/master/doc/SWR_POWER_METER_F8KGL_implementation_v0.7.pdf

Je corrige ça dans le commit à suivre

f4bjh, 2020-05-01:
--->Manque LT818 je compte sur toi pour le mettre dans le dossier

je le trouve pas, il y a des LT 8XX mais pas de 818

Elle se trouve içi : https://github.com/f8kgl/swr_power_meter/blob/master/src/hw/doc/lt1818.pdf

f4bjh, 2020-05-01:
Petite remarque anodine (parce que je pense que tu ne l'avais peut être pas compris a priori) :

Les liens que j'ai mis dans les commentaires ci-dessus, sont des liens vers le serveur github.
MAIS
ceux sont aussi des liens qui pointent sur les répertoires du projet.

C'est à dire que :
https://github.com/f8kgl/swr_power_meter/blob/master/doc/SWR_POWER_METER_F8KGL_implementation_v0.7.pdf
tu le trouveras chez toi dans swr_power_meter/doc/SWR_POWER_METER_F8KGL_implementation_v0.7.pdf

et
https://github.com/f8kgl/swr_power_meter/blob/master/src/hw/doc/lt1818.pdf
tu le trouveras chez toi dans swr_power_meter/src/hw/doc/lt1818.pdf

Tu comprends ?

Closed 2020-05-02.

Thread 124 (2020-04-30):

message erreur

F0EOS, 2020-04-30:
suite a la creation d'une librairie  pour y mettre l'AD5175 j'ai creer une librairie qui n'ai pas visible

le composant s'etant copier dans le librairie 16F88

f4bjh, 2020-05-01:
peux-tu vérifier que le message à disparu ?

Closed 2020-05-02.

Thread 125 (2020-04-30):

changement de nom librairie

F0EOS, 2020-04-30:
il faudra essaye de changer le nom de la librairie "16F88" en "composants projet"

et faire les essai de fonctionnement pour savoir si KICAD fais bien appel a la nouvelles

je te l'assigne quand meme pour un suivi au cas ou
je vais essayer de faire ca dans les jours qui viennent

f4bjh, 2020-05-01:
avec le commit précédent https://github.com/f8kgl/swr_power_meter/commit/a913d3da5b06c726f6fa0e540a10e91034a88256, j'ai fait un peu de nettoyage

Dorénavant, il y a une librairie qui s'apelle swr_power_meter.lib.

Que tu peux retrouver içi dans l'éditeur de schéma sous le nom "librairie_projet" :
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

Peux-tu vérifier que tout ça marche bien chez toi ?

Dans le doute, fais une recherche "AD5175" quand tu cherches à ajouter un composant au schéma

Closed 2020-05-02.

Thread 126 (2020-05-01):

Faut-il créer une branche de test pour les développements HW ?

f4bjh, 2020-05-01:
Git permet la création de branche :

En partant d'une version à un instant donné, on peut créer un dépot de test supplémentaire, dans lequel on peut faire des livraisons de tests qui n'affectent pas le dépot principal.

Lorsque les livraisons de tests sont terminées et validées, on peut fusionner le dépot de test avec le dépot principal.
Ce dépot supplémentaire serait dédié aux livraisons kicad par exemple.

Est-ce que ça t'intéresse André ?

f4bjh, 2020-05-06:
est-ce que tu veux une branche spéciale pour toi pour faire des livraisons à part ?

F0EOS, 2020-05-06:
non c'etait juste pour les video plus facile a retrouver mais tu as dis pas possible donc non je reste comme ca pour le moment

j'ai plein de sauvegarde sur le pc pour les test au cas ou

Closed 2020-05-06.

Thread 127 (2020-05-01):

Tempo un peu longue sur le message d'acceuil ?

f4bjh, 2020-05-01:
Je trouve la tempo du message d'acceuil un peu longue.

Est-elle conforme à la spec ?
=>la chronométrer et vérifier aussi qu'elle correspond bien à l'implémentation dans le code...

f4bjh, 2020-05-02:
Tempo de 5 secondes conforme aux spécifications (Q=4MHz).

=>trop long ?

f4bjh, 2020-05-02:
André, F0EOS : est-ce qu'elle est trop longue cette tempo d'après toi ?

voir p 15/26 des specs : https://github.com/f8kgl/swr_power_meter/blob/i2c_test/doc/SWR_POWER_METER_F8KGL_specifications_v0.7.pdf

F0EOS, 2020-05-04:
3s serais pas mieux ?

f4bjh, 2020-05-04:
Oui, je suis d'accord

Closed 2020-05-04.

Thread 128 (2020-05-01):

Bug du PCLATH

f4bjh, 2020-05-01:
Lorsqu'on parcourt une table (comme c_testmsgL2 par exemple), par adressage relatif (addition d'un offset directement dans PCL), si le registre PCLATH n'est pas correctement positionnée, le PIC se plante.

Ex :
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

La table de cette image commence en 0x00F8. Au moment d'entrer dans la table (par un call 0x00F8 par exemple), on a la valeur PCLATH=0x00.
Dans le cas des  offset >7, le PCL est incrémenter de 7, mais le PCLATH reste à la valeur 00. Ca a pour conséquence de faire pointer le PC a une mauvaise valeur.
https://pictutorials.com/PCL%20and%20PCLATH.htm
voir §5.4 de la spec du 18F1320, où effectivement, pour les instructions CALL, GOTO, et RCALL, le PC entier est écrit directement. En revanche, si on affecte directement la valeur de PCL, il faut vérifier la valeur de PCLATH en conséquence.

f4bjh, 2020-05-01:
#120 #122

f4bjh, 2020-05-01:
faut appliquer cette correction pour toutes les parties du code qui utilisent un addwf PCL, f ?

f4bjh, 2020-05-01:
reporter cela dans la doc d'implémentation aussi...

Closed 2020-05-13.

Thread 129 (2020-05-02):

Implémenter le LCD 4 lignes

f4bjh, 2020-05-02:
Un LCD 4 lignes a été spécifié dans les specs.

Idéalement, il faudrait qu'il y ait qu'un seul firmware...à voir comment on peut gérér cela (interroger le LCD ?)

f4bjh, 2020-05-04:
#34

Closed 2020-05-04.

Thread 130 (2020-05-02):

Plantage du PIC dans le driver ADC

f4bjh, 2020-05-02:
Le PIC est bloqué en PCL = 0x0CE0

f4bjh, 2020-05-02:
0x00000000004C9A86 p18f1320 0x0CDE 0x50EE movf	postinc0,w,0
  Read: 0x0000 from postinc0(0x0FEE)
  Wrote: 0x0001 to fsr0l(0x0FE9) was 0x0000
  Wrote: 0x000F to fsr0h(0x0FEA) was 0x000F
  Invalid Trace entry: 0x0
  Wrote: 0x0000 to W(0x0FE8) was 0x0000
  Wrote: 0x0006 to status(0x0FD8) was 0x0006
attempt write to invalid file register
    address 0xf01,   value 0x0

Closed 2020-05-02.

Thread 131 (2020-05-02):

Impossible de piloter SDA et SCL de i2c2par

f4bjh, 2020-05-02:
Les signaux SDA et SCL restent bloqué à 1 (flèche rouge dans le breadboard)

Sur les pull up, les singanux semblent bien être drivés par le PIC

f4bjh, 2020-05-02:
upate gpsim0.31 :

$sudo apt-get remove gpsim

https://sourceforge.net/projects/gpsim/files/gpsim/0.31.0/

$tar -xvzf gpsim-0.31.0.tar.gz
$cd gpsim-0.31.0/
$./configure
$make
 $sudo make install
$sudo /sbin/ldconfig

f4bjh, 2020-05-02:
trace gpsim :

0x00000000004C9946 p18f1320 0x0CFC 0x8680 bsf	porta,3,0
  Wrote: 0x00?C to porta(0x0F80) was 0x000C
0x00000000004C9947 p18f1320 0x0CFE 0x8480 bsf	porta,2,0
  Wrote: 0x00?C to porta(0x0F80) was 0x000C
0x00000000004C9948 p18f1320 0x0D00 0x9480 bcf	porta,2,0
  Wrote: 0x00?8 to porta(0x0F80) was 0x000C

c'est quoi ces "?"

f4bjh, 2020-05-04:
vraisemblablement (???), il vaut mieux mettre le mode analogique vs numérique avant d'initialier le mode entrée/sortie d'un port du PIC...

Closed 2020-05-04.

Thread 132 (2020-05-04):

i2c2par ne répond pas correctement à la commande

f4bjh, 2020-05-04:
ou bien la commande n'est pas correctement formaté :

Mot de commande = 0xAA

Sortie de i2c2par = 0xD5 (p7 bit de poids fort)

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

f4bjh, 2020-05-04:
Pas d'ACK de la part de i2c2par

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

f4bjh, 2020-05-04:
sur la 2ème trame : ACK bien rçu par le PIC, et i2c2par positionne correctement le mot 0xAA en sortie :

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

f4bjh, 2020-05-04:
**gpsim> scope.ch0 = "p18f1320.porta3"
**gpsim> scope.ch1 = "p18f1320.porta2"

Closed 2020-05-04.

Thread 134 (2020-05-04):

i2c2par répond NACK à la 1er trame

f4bjh, 2020-05-04:
Pas d'ACK de la part de i2c2par sur la toute première trame

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

sur la 2ème trame (et toutes les suivantes visiblement : ACK bien reçu par le PIC, et i2c2par positionne correctement le mot 0xAA en sortie :

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

f4bjh, 2020-05-16:
en prévision de tirer une nouvelle branche "menu_aop" pour les dev de la V0.8

Pour cette fiche, il faudra tout de même poser la question aux développeurs de gpsim...

f4bjh, 2020-06-05:
faire un petit fw de test dans une branche parallèle, et poser la question à la miling list de gpsim

f4bjh, 2020-06-12:
#159

f4bjh, 2021-04-01:
#392

f4bjh, 2021-04-01:
ah non non, c'est pas un doublon !!!

Thread 135 (2020-05-04):

Cahier de recette

f4bjh, 2020-05-04:
Etablir un cahier de recette à passer sur le prototype, mais aussi sur 1 ou 2 cartes de production

1-valider la communication i2c (en particulier la clock)
2-temps de transfert dans l'eep
3-les alims
4-valider la précision de la mesure finale

f4bjh, 2021-02-12:
#219 #293

Closed 2021-02-18.

Thread 136 (2020-05-04):

le port de sortie du ltc2305 sous Gpsim n'est pas drivable

f4bjh, 2020-05-04:
en plaçant des pull-up sur le port de sortie du ltc2305, les niveaux en entrées du module ne sont pas corrects

f4bjh, 2020-05-04:
faut-il passer du temps sur cette fiche ?

Car de toute façon, le module ltc2305 implémenté dans gpsim est fondé sur i2c2par, et sera complètement revu à ce niveau ...

Closed 2020-05-06.

Thread 138 (2020-05-04):

précision de la mesure pour Pin<10W

f4bjh, 2020-05-04:
Telle qu'implentée à l'heure actuelle, pour les Pin<10W, la précision de 10% ne sera pas atteinte...puisqu'on n'afffichera pas au moins 1 chiffre après la virgule...

A la limite, à voir s'il ne vaudrait pas mieux avoir une table de calibration en ASCII directement...vu qu'on s'oriente vers un EEP I2C externe pour stocker la cable de calibration

f4bjh, 2020-05-06:
#104

Closed 2020-05-06.

Thread 141 (2020-05-07):

Mode d'emploi des fiches sous Github

f4bjh, 2020-05-07:
Spécifier et décrire le mode d'emploi des fiches sous github

Il y a3 familles de fiches : hw, sw et doc (avec chacune leur code de couleur)
Chaque fiche peut se trouver dans 5 états différents : assigné, accepté, implémenté, validé, et fermé
La fiche doit également avoir un objectif de version de résolution, qui correspond à la version de spécifications

Description des étapes :
1/Après création d'une nouvelle fiche, il faut lui attribuer une famille (hw, sw ou doc) et l'assigner (F0EOS, ou F4BJH selon le cas)
*Passe la fiche dans l'état _assigné_
2/L'OM  désigné analyse et étudie la faisabilité de cette fiche.
 2.1/Si l'analyse aboutit à une conclusion négative
  2.1.1/Si l'analyse montre un manque d'information,
  *Préciser les informations manquantes
  *Passer la fiche dans l'état _question_
  *Assigner la fiche au à l'OM demandeur
  2.1.2/Si l'analyse montre que la résolution est impossible
  *Préciser les raisons pour lesquelles la fiche ne pourra être résolu
  *Passer la fiche dans l'état _ne sera pas résolu_
  *Assigner la fiche au à l'OM demandeur
  2.1.3/L'OM  nouvellement redésigné analyse et étudie la faisabilité de cette fiche
   2.1.3.1/S'il peut effectivement apporter les précisions ou corrections nécessaires
   *Apporter les précisions ou corrections nécessaires à la fiche
   *Passe la fiche dans l'état _assigné_ et retour en 2/
   2.1.3.2/Sinon
   *Passe la fiche dans l'état _validé_
 2.2/Si l'analyse aboutit à une conclusion positive
 *passer la fiche dans l'état _accepté_
 *livrer sur github les corrections, évolutions ou les documentations demandées
 2.3/Quand l'OM désigné a livré
 *Passer la fiche dans l'état _implémenté_
 *Assigner la fiche au demandeur
 *Le demandeur analyse, étudie et teste la livraison
 2.3.1/Si l'analyse aboutit à une conclusion négative
 *Créer une nouvelle fiche
 *Référencer dans la fiche mère la nouvelle fiche créée
 *Passer la fiche mère dans l'état _bloqué_
 2.3.2/Si l'analyse aboutit à une conclusion positive
 *passer la fiche dans l'état _validé_

Closed 2020-05-13.

Thread 142 (2020-05-07):

Table de calibration pour le fw de test

f4bjh, 2020-05-07:
Coder la table de calibration pour le fw de test

f4bjh, 2020-05-13:
référence à 120 ci-dessus erronée

f4bjh, 2020-05-26:
le nouveau adc_theoric_cal.asm est trop volumineux...ça ne compile pas :

gplink --map -c -S2 -s /usr/local/share/gputils/lkr/18f1320_g.lkr -o ../bin/swr_power_meter_f8kgl-V0.8.TEST.GPSIM.hex main.TEST.o ../src/sw/data/swversion.TEST.o ../src/sw/data/lcdmsg.TEST.o ../src/sw/data/adc_theoric_cal.o ../bin/libtesttempo.a ../bin/libtestlcd.a ../bin/libtesti2c.a ../bin/libtesteep.a ../bin/libtestflh.a ../bin/libtestadc.a ../bin/libtestcalc.a ../bin/libtestaop.a
error: No target memory available for section ".code".
error: Error while writing object file.
make: *** [Makefile:78: swr_power_meter_f8kgl-V0.8.TEST.GPSIM.hex] Error 1

Closed 2020-06-09.

Thread 148 (2020-05-07):

Faire du nettoyage dans les docs d'implémentation et spécifications

f4bjh, 2020-05-07:
Beaucoup de points sont sujets à ambiguité
De plus, il y a comme un espèce de mélange des genre entre l'implémentation et/ou les spécifications.
De plus, pour gagner du temps finalement, alléger la partie implémentation logicielle et la faire basculer directement dans le code source en commentaire. Ne laisser que l'implémentation des interfaces

f4bjh, 2020-05-11:
#173 bloquant

f4bjh, 2020-05-11:
#174 bloquant

f4bjh, 2020-05-11:
#160 bloquant

Closed 2020-05-13.

Thread 150 (2020-05-07):

C7 n'est pas correctement positionné

f4bjh, 2020-05-07:
Les capa sont en sortie du détecteur HF. C7 n'est donc pas bien placé

commit https://github.com/f8kgl/swr_power_meter/commit/da62503288d41dc8e7989994f7f1e8e834536f91

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

f4bjh, 2020-05-07:
Je pense avoir deviné d'où vient la confusion...

Soit le fonctionnement du coupleur directif n'est pas assez clair dans mes docs, soit il faudrait que tu y jettes quand même un oeil (même rapide) :

Voir §2.1.1 des specifications (mis en pièce jointe içi au format pdf). C'est page 6

[SWR_POWER_METER_F8KGL_specifications_v0.7.pdf](https://github.com/f8kgl/swr_power_meter/files/4593291/SWR_POWER_METER_F8KGL_specifications_v0.7.pdf)

Closed 2020-05-13.

Thread 151 (2020-05-07):

L'afficheur reste bloqué sur "I2C Tester"

f4bjh, 2020-05-07:

f4bjh, 2020-05-07:
Ressemble étrangement à #128
Mapping de la mémoire :

              c_testmsgL1   0x0000f4    program     extern ../src/sw/data/lcdmsg.asm
              c_testmsgL2   0x000100    program     extern ../src/sw/data/lcdmsg.asm

c_testmsgL1 est très très proche d'une nouvelle page

f4bjh, 2020-05-09:
PCLATH n'est pas bien positionné non plus à l'intérieur de la table

f4bjh, 2020-05-09:
#128

Closed 2020-05-13.

Thread 152 (2020-05-07):

Impossible de charger la librairie libgpsim_modules ou lib_swrpowermeterf8kgl

f4bjh, 2020-05-07:
Failed loading libgpsim_modules.so.0: /usr/local/lib/libgpsim_modules.so.0: undefined symbol: _ZN15I2C2PAR_Modules7i2c2par9constructEPKc
failed to open library module libgpsim_modules/home/f4bjh/devel/f8kgl/swr_power_meter/src/hw/sim/gpsim

Et de plus, le chargement de netlist.stc pose problème :

module type pullup not created
***ERROR: syntax error, unexpected EQU_T, expecting MACRO while parsing:
	'Vfwd.capacitance = 0'
module type pullup not created
***ERROR: syntax error, unexpected EQU_T, expecting MACRO while parsing:
	'Vref.capacitance = 0'
module type pullup not created
***ERROR: syntax error, unexpected EQU_T, expecting MACRO while parsing:
	'pullup_1.capacitance = 0'
module type pullup not created
***ERROR: syntax error, unexpected EQU_T, expecting MACRO while parsing:
	'pullup_2.capacitance = 0'
module type pullup not created
***ERROR: syntax error, unexpected EQU_T, expecting MACRO while parsing:
	'high.capacitance = 0'
module type pulldown not created
***ERROR: syntax error, unexpected EQU_T, expecting MACRO while parsing:
	'low.capacitance = 0'
***ERROR: syntax error, unexpected LITERAL_STRING_T, expecting EOLN_T while parsing:
	'attach nFWD p18f1320.porta0 Vfwd.pin ltc2305.CH0'
***ERROR: syntax error, unexpected LITERAL_STRING_T, expecting EOLN_T while parsing:
	'attach nSDA p18f1320.porta2 pullup_1.pin ltc2305.SDA'
***ERROR: syntax error, unexpected LITERAL_STRING_T, expecting SYMBOL_T or GPSIMOBJECT_T while parsing:
	'attach nH high.pin'

f4bjh, 2020-05-07:
le message "failed to open library module libgpsim_modules/home/f4bjh/devel/f8kgl/swr_power_meter/src/hw/sim/gpsim" n'a strictement aucune importance

f4bjh, 2020-05-07:
malgré le commit https://github.com/f8kgl/swr_power_meter/commit/5e897c05e376e0d61b665ddf82093b96cf826292 ça ne fonctionne toujours pas.

Il y a eu une régression...

Et enfin, le seul moyen de retrouer une situation saine (sans les composants ltc2305 et/ou AD5175), reste une recompil from scratch de gpsim...

f4bjh, 2020-05-08:
ça sent le bug gpsim tout de même, et peut-être pas une regression à proprement parlé...

En fait, le problème apparaît dès lors qu'on supprime un fichier source du Makefile.am !!!

f4bjh, 2020-05-09:
avec le commit https://github.com/f8kgl/swr_power_meter/commit/38b6377ced173b81998420cd2196d29cf75642cc, la librairie a changé de nom : libswrpowermeterf8kgl_modules

Closed 2020-05-13.

Thread 154 (2020-05-08):

gpsim crashe si on supprime un fichier source d'une librairie

f4bjh, 2020-05-08:
Date: Fri, 8 May 2020 05:50:31 +0000 (UTC)
From: DECROP Fabrice <f4bjh_95@yahoo.fr>
To: "gpsim-devel@lists.sourceforge.net" <gpsim-devel@lists.sourceforge.net>
Message-ID: <1916422584.15842.1588917031115@mail.yahoo.com>
Subject: Removing source file from modules/Makefile.am causes crash
MIME-Version: 1.0
Content-Type: multipart/alternative;
	boundary="----=_Part_15841_578831487.1588917031112"
References: <1916422584.15842.1588917031115.ref@mail.yahoo.com>
X-Mailer: WebService/1.1.15902 YMailNorrin Mozilla/5.0 (X11; Linux x86_64; rv:68.0) Gecko/20100101 Firefox/68.0
Content-Length: 15968

------=_Part_15841_578831487.1588917031112
Content-Type: text/plain; charset=UTF-8
Content-Transfer-Encoding: quoted-printable

Hi,
I'm a little newbie to gpsim, and also to Makefile mechanics, and not total=
ly sure that this could be the right place to describe my issue...feel free=
 to tell me if so :-)
I download gpsim0.31 tarball, and make it all. Everything is OK then.I adde=
d my personnal module (called ltc2305, wich is an ADC) in libgpsim_modules.=
 My personnal module is based on i2c2par, that I modified to run an analog =
to digital conversion. Everything works fine so far.
For some reasons, I wanted to remove ltc2305.cc, and ltc2305.h from Makefil=
e.am. Then I did :=20
$ autoreconf
$./configure
$make
$sudo make install
$sudo /sbin/ldconfig

Compilation works fine, but when I try to load my new libgpsim_modules (wic=
h should be exactly the same as in the tarball), gpsim crashes :=20

**gpsim>Failed loading libgpsim_modules.so.0: /usr/local/lib/libgpsim_modul=
es.so.0: undefined symbol: _ZN15I2C2PAR_Modules7i2c2par9constructEPKctermin=
ate called after throwing an instance of 'Error'
=C2=A0 what():=C2=A0 failed to open library module libgpsim_modules/home/f4=
bjh/devel/f8kgl/swr_power_meter/bin

Could you please, tell me if I'm doing something wrong ?Thanks in advance f=
or your help.
Best regards,Fabrice, F4BJHPS : if needed, whole project is here : f8kgl/sw=
r_power_meterPS2 : personal module source files are here : f8kgl/swr_power_=
meter

f4bjh, 2020-05-09:
X-Apparently-To: f4bjh_95@yahoo.fr; Fri, 08 May 2020 11:10:43 +0000
Return-Path: <gpsim-devel-bounces@lists.sourceforge.net>
Authentication-Results: mta1141.mail.ir2.yahoo.com;
 dkim=permerror (bad sig) header.i=@sourceforge.net header.s=x;
 dkim=permerror (bad sig) header.i=@sf.net header.s=x;
 spf=pass smtp.mailfrom=@lists.sourceforge.net;
 dmarc=NULL(p=NULL sp=NULL dis=NULL) header.from=flitspace.org.uk;
Received-SPF: pass (domain of lists.sourceforge.net designates 216.105.38.7 as permitted sender)
X-YMailISG: 1lcmsDgWLDsgLaBwiEAHuJpPCdpc_7.f6URSUGyEPxePPUj6
 iW51ZhyulUt1HDgUE774o1M1n81Fe_PjmTiyCu23olPJb8XsljXADZCRe4_5
 3gOmA0h9ig8Z4QGoa0icj.3hLXkGkYypuRYuT6upbFmmheLtNEOG5hSvyP_1
 .XO8cmsglnNoCE_U4NG4jStZRUVtF_yKvhz3UUdy2UDyKfldqFHJ5PcP1Uz7
 Yo_ZMoOIyFkk2WabCsnJLHDHICsPLKOi0IAW57NSDQFG4k0XLSj90zEo.c0_
 TVsGlRAsNXvKycpB5ajmO4Ql_WFnf3OrauWnsyrIhx9L7wl2xe6VnE6UMkjr
 HWlTDgLRKGu1RnBhp1mUpvcvhIBBJqktuJzYH6MrxvUNNAl1Ni5B2guf7m0H
 mLYrGhZOnmbU9jtGZbfwb0bPFnAXaMNpQcNhz3ZbrXwEpF0BXpGAx8CbysmR
 JuRe4qZXy4c3XWVNG_moA4uLzWdABdKs0vT2ORS8tsPA6SbDoHaXNXnlgCRq
 rXpj95sXGPWIs4ZKiJLLfAVJHjdDUcu7saZ8w1MWUgYCcYdTzADUtGjYoN1A
 gmK6tWoQC25v.XT044j9emJsEUU7_JwCYkcIGWmWrMTOoVIMeNPE.PyMciP2
 183SRxcJT91dkDFzxw2wDNdvtyLFUHtEJstyhcua23ZNeO9Y8NhnBmZg1QC7
 Gn8Vbs6EqIcEYiSjFG4skWh3CJL0oNMwoTLKK6NhA.fcfK67jAFB5rHka.WA
 GCj99vcqZ0vIeN84zs2_.bOEq8hPZCgBBDymdDQ4DacFd5beXs0kuBw7Bv1C
 bmfrqYjVWmusBTKjcrjgpr_7bYuNlU6wk.Ktj8eoGJ5f4ns6h07B37ue9iAr
 LWI.IF.NxlHgq6CumApMwygT4N4203Gn8FRtB5Mk_T9QQhyxoww6Lhd6v6dr
 vpFRKRRWX3EoBSh0_EH3rYRJfR42QRgUKuwG3we9ZaczjpDEmMAOm0cFz49c
 shapgQxtPBzRXZAm2SzM1LL83R0RVnQz8x8cwvkG.WNPLXq7YQPKgfSj7h_W
 EYb34m9jb_XrHY1CXmgnhtgUTAhHhQn4jEXPXuEiuJwYuip4n8DpKKG7vxlE
 G8BMNve2EWoAgaDjOgGUZeA3I2YK7rXUVT3TRgLBQ54UOBS6yoDnnkPhZw--
X-Originating-IP: [216.105.38.7]
Received: from 10.200.78.172  (EHLO lists.sourceforge.net) (216.105.38.7)
  by mta1141.mail.ir2.yahoo.com with SMTPS; Fri, 08 May 2020 11:10:43 +0000
Received: from [127.0.0.1] (helo=sfs-ml-2.v29.lw.sourceforge.com)
	by sfs-ml-2.v29.lw.sourceforge.com with esmtp (Exim 4.90_1)
	(envelope-from <gpsim-devel-bounces@lists.sourceforge.net>)
	id 1jX0ti-0000PL-2Y; Fri, 08 May 2020 11:10:30 +0000
Received: from [172.30.20.202] (helo=mx.sourceforge.net)
 by sfs-ml-2.v29.lw.sourceforge.com with esmtps
 (TLSv1.2:ECDHE-RSA-AES256-GCM-SHA384:256) (Exim 4.90_1)
 (envelope-from <list.pic@flitspace.org.uk>) id 1jX0tg-0000PD-Rf
 for gpsim-devel@lists.sourceforge.net; Fri, 08 May 2020 11:10:28 +0000
DKIM-Signature: v=1; a=rsa-sha256; q=dns/txt; c=relaxed/relaxed;
 d=sourceforge.net; s=x; h=Content-Type:In-Reply-To:MIME-Version:Date:
 Message-ID:References:To:Subject:From:Sender:Reply-To:Cc:
 Content-Transfer-Encoding:Content-ID:Content-Description:Resent-Date:
 Resent-From:Resent-Sender:Resent-To:Resent-Cc:Resent-Message-ID:List-Id:
 List-Help:List-Unsubscribe:List-Subscribe:List-Post:List-Owner:List-Archive;
 bh=mt6UhurpqDg+s9L9saYsUlWcCy/vFOE8vahlwgSrfLc=; b=WzYiI3EIp1t/HKLelfZxqHG4e
 E5GfuwuCVVg/gCLxLMdOrqhf4ZWTj37RGB/bTbxICP4pTW+ch+SPoNqhVSx4rn6c+rvCvs2AOsFT6
 ygea3Ir7gLzpANKZcy/6RSG4V0YB7f8I5bsrJZxZCYSBM+/nVvFnqSmx2r1g5yFOsXwiE=;
DKIM-Signature: v=1; a=rsa-sha256; q=dns/txt; c=relaxed/relaxed; d=sf.net; s=x
 ;
 h=Content-Type:In-Reply-To:MIME-Version:Date:Message-ID:References:To:
 Subject:From:Sender:Reply-To:Cc:Content-Transfer-Encoding:Content-ID:
 Content-Description:Resent-Date:Resent-From:Resent-Sender:Resent-To:Resent-Cc
 :Resent-Message-ID:List-Id:List-Help:List-Unsubscribe:List-Subscribe:
 List-Post:List-Owner:List-Archive;
 bh=mt6UhurpqDg+s9L9saYsUlWcCy/vFOE8vahlwgSrfLc=; b=EMZx/B2kIi3r9Y1Mi82APbLbnz
 iD4Cvk2DZVNV0Ob1GxXeR8pkStOW5VBxt3QMJd3xKVXf/p+XhuP+o8fQM4io9VtKI4lUBGtzcjFT+
 Z2rAVILb0csPM3qhXbCYSq2vBYF+k8JZyo34m7UtJ9F+f7vMnPqcetlFHwsRjr8oGe/I=;
Received: from mailomta1-re.btinternet.com ([213.120.69.94]
 helo=re-prd-fep-049.btinternet.com)
 by sfi-mx-4.v28.lw.sourceforge.com with esmtps
 (TLSv1.2:ECDHE-RSA-AES256-GCM-SHA384:256) (Exim 4.92.2)
 id 1jX0te-00FQlZ-0A
 for gpsim-devel@lists.sourceforge.net; Fri, 08 May 2020 11:10:28 +0000
Received: from re-prd-rgout-004.btmx-prd.synchronoss.net ([10.2.54.7])
 by re-prd-fep-049.btinternet.com with ESMTP id
 <20200508111018.FHML8801.re-prd-fep-049.btinternet.com@re-prd-rgout-004.btmx-prd.synchronoss.net>
 for <gpsim-devel@lists.sourceforge.net>;
 Fri, 8 May 2020 12:10:18 +0100
Authentication-Results: btinternet.com;
 auth=pass (PLAIN) smtp.auth=flitspace1@btinternet.com
X-Originating-IP: [86.156.236.56]
X-OWM-Source-IP: 86.156.236.56 (GB)
X-OWM-Env-Sender: flitspace1@btinternet.com
X-VadeSecure-score: verdict=clean score=0/300, class=clean
X-RazorGate-Vade: gggruggvucftvghtrhhoucdtuddrgeduhedrkedvgdefiecutefuodetggdotefrodftvfcurfhrohhfihhlvgemuceutffkvffkuffjvffgnffgvefqofdpqfgfvfenuceurghilhhouhhtmecufedttdenucenucfjughrpefhuffvfhfkffgfgggjtgesrgdtreertdefjeenucfhrhhomheptfhosgcurfgvrghrtggvuceolhhishhtrdhpihgtsehflhhithhsphgrtggvrdhorhhgrdhukheqnecuggftrfgrthhtvghrnheptedutdeffeeutdeigefhfeegfeevgfejhfevvdeuieelleffuefhieegheejieehnecukfhppeekiedrudehiedrvdefiedrheeinecuvehluhhsthgvrhfuihiivgeptdenucfrrghrrghmpehhvghlohepfhhlihhtshhprggtvgdrohhrghdruhhkpdhinhgvthepkeeirdduheeirddvfeeirdehiedpmhgrihhlfhhrohhmpeeolhhishhtrdhpihgtsehflhhithhsphgrtggvrdhorhhgrdhukhequceuqfffjgepkeeukffvoffkoffgpdhrtghpthhtohepoehgphhsihhmqdguvghvvghlsehlihhsthhsrdhsohhurhgtvghfohhrghgvrdhnvghtqecuqfftvefrvfeprhhftgekvddvnehgphhsihhmqdguvghvvghlsehlihhsthhsrdhsohhurhgtvghfohhrghgvrdhnvght
X-RazorGate-Vade-Verdict: clean 0
X-RazorGate-Vade-Classification: clean
Received: from flitspace.org.uk (86.156.236.56) by
 re-prd-rgout-004.btmx-prd.synchronoss.net (5.8.340) (authenticated as
 flitspace1@btinternet.com)
 id 5E3A181A0F6670B4 for gpsim-devel@lists.sourceforge.net;
 Fri, 8 May 2020 12:10:18 +0100
Received: from [192.168.0.20] (isaiah.huneausware.local [192.168.0.20])
 by flitspace.org.uk (Postfix) with ESMTP id E728D3CBF5B
 for <gpsim-devel@lists.sourceforge.net>; Fri,  8 May 2020 12:10:17 +0100 (BST)
From: Rob Pearce <list.pic@flitspace.org.uk>
To: gpsim-devel@lists.sourceforge.net
References: <1916422584.15842.1588917031115.ref@mail.yahoo.com>
 <1916422584.15842.1588917031115@mail.yahoo.com>
Message-ID: <cd54dd8a-0df5-e525-7871-e43a88934cf1@flitspace.org.uk>
Date: Fri, 8 May 2020 12:10:16 +0100
User-Agent: Mozilla/5.0 (X11; Linux x86_64; rv:68.0) Gecko/20100101
 Thunderbird/68.4.2
MIME-Version: 1.0
In-Reply-To: <1916422584.15842.1588917031115@mail.yahoo.com>
Content-Language: en-GB
X-Spam-Score: 2.0 (++)
X-Spam-Report: Spam Filtering performed by mx.sourceforge.net.
 See http://spamassassin.org/tag/ for more details.
 -0.0 SPF_HELO_PASS          SPF: HELO matches SPF record
 0.0 SPF_NONE               SPF: sender does not publish an SPF Record
 1.0 HTML_MESSAGE           BODY: HTML included in message
 1.0 FORGED_SPF_HELO        No description available.
X-Headers-End: 1jX0te-00FQlZ-0A
Subject: Re: [gpsim-devel] Removing source file from modules/Makefile.am
 causes crash
X-BeenThere: gpsim-devel@lists.sourceforge.net
X-Mailman-Version: 2.1.21
Precedence: list
List-Id: gpsim - GNUPIC Simulator development
 <gpsim-devel.lists.sourceforge.net>
List-Unsubscribe: <https://lists.sourceforge.net/lists/options/gpsim-devel>,
 <mailto:gpsim-devel-request@lists.sourceforge.net?subject=unsubscribe>
List-Archive: <http://sourceforge.net/mailarchive/forum.php?forum_name=gpsim-devel>
List-Post: <mailto:gpsim-devel@lists.sourceforge.net>
List-Help: <mailto:gpsim-devel-request@lists.sourceforge.net?subject=help>
List-Subscribe: <https://lists.sourceforge.net/lists/listinfo/gpsim-devel>,
 <mailto:gpsim-devel-request@lists.sourceforge.net?subject=subscribe>
Content-Type: multipart/mixed; boundary="===============6710478341140936270=="
Errors-To: gpsim-devel-bounces@lists.sourceforge.net
Content-Length: 7126

This is a multi-part message in MIME format.
--===============6710478341140936270==
Content-Type: multipart/alternative;
 boundary="------------0A62379E179932B79F9FA197"
Content-Language: en-GB

This is a multi-part message in MIME format.
--------------0A62379E179932B79F9FA197
Content-Type: text/plain; charset=utf-8; format=flowed
Content-Transfer-Encoding: 8bit

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
No, I think this is probably as good a place as any.

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

After removing the file from Makefile.am, did you do exactly as listed?
I think you probably need a "make clean" step after you've removed
something.

However, the symbol shown in that error looks like it belongs to the
file you based yours on, not to your file that you removed. I assume you
had renamed all your classes so there weren't any clashes. Hopefully you
were working in a copy of the unpacked GPSim source, so you have two
directory trees that you can compare (I like meld for this) to confirm
that you've not left anything amiss?

Regards,

Rob

--------------0A62379E179932B79F9FA197
Content-Type: text/html; charset=utf-8
Content-Transfer-Encoding: 8bit

<html>
  <head>
    <meta http-equiv="Content-Type" content="text/html; charset=UTF-8">
  </head>
  <body>
    <div class="moz-cite-prefix">On 08/05/2020 06:50, DECROP Fabrice via
      gpsim-devel wrote:<br>
    </div>
    <blockquote type="cite"
      cite="mid:1916422584.15842.1588917031115@mail.yahoo.com">
      <meta http-equiv="content-type" content="text/html; charset=UTF-8">
      <!--[if gte mso 9]><xml><o:OfficeDocumentSettings><o:AllowPNG/><o:PixelsPerInch>96</o:PixelsPerInch></o:OfficeDocumentSettings></xml><![endif]-->
      <div class="yahoo-style-wrap" style="font-family:Helvetica Neue,
        Helvetica, Arial, sans-serif;font-size:16px;">
        <div dir="ltr" data-setdir="false">Hi,</div>
        <div dir="ltr" data-setdir="false"><br>
        </div>
        <div dir="ltr" data-setdir="false">I'm a little newbie to gpsim,
          and also to Makefile mechanics, and not totally sure that this
          could be the right place to describe my issue...feel free to
          tell me if so :-)</div>
        <div dir="ltr" data-setdir="false"><br>
        </div>
      </div>
    </blockquote>
    <p>No, I think this is probably as good a place as any.</p>
    <p><br>
    </p>
    <blockquote type="cite"
      cite="mid:1916422584.15842.1588917031115@mail.yahoo.com">
      <div class="yahoo-style-wrap" style="font-family:Helvetica Neue,
        Helvetica, Arial, sans-serif;font-size:16px;">
        <div dir="ltr" data-setdir="false">I download gpsim0.31 tarball,
          and make it all. Everything is OK then.</div>
        <div dir="ltr" data-setdir="false">I added my personnal module
          (called ltc2305, wich is an ADC) in libgpsim_modules. My
          personnal module is based on i2c2par, that I modified to run
          an analog to digital conversion. Everything works fine so far.</div>
        <div dir="ltr" data-setdir="false"><br>
        </div>
        <div dir="ltr" data-setdir="false">For some reasons, I wanted to
          remove ltc2305.cc, and ltc2305.h from Makefile.am. Then I did
          : <br>
        </div>
        <div dir="ltr" data-setdir="false">
          <div>$ autoreconf<br>
            $./configure<br>
            $make<br>
            $sudo make install<br>
            $sudo /sbin/ldconfig<br>
            <div><br>
            </div>
            <div dir="ltr" data-setdir="false">Compilation works fine,
              but when I try to load my new libgpsim_modules (wich
              should be exactly the same as in the tarball), gpsim
              crashes : <br>
            </div>
            <div dir="ltr" data-setdir="false"><br>
            </div>
            <div dir="ltr" data-setdir="false">
              <div dir="ltr" data-setdir="false">
                <div><span>**gpsim&gt;</span>Failed loading
                  libgpsim_modules.so.0:
                  /usr/local/lib/libgpsim_modules.so.0: undefined
                  symbol: _ZN15I2C2PAR_Modules7i2c2par9constructEPKc</div>
                terminate called after throwing an instance of 'Error'<br>
                Â  what():Â  failed to open library module
                libgpsim_modules/home/f4bjh/devel/f8kgl/swr_power_meter/bin<br>
                <div><br>
                </div>
                <div><br>
                </div>
                <div>Could you please, tell me if I'm doing something
                  wrong ?</div>
              </div>
            </div>
          </div>
        </div>
      </div>
    </blockquote>
    <p>After removing the file from Makefile.am, did you do exactly as
      listed? I think you probably need a "make clean" step after you've
      removed something.</p>
    <p>However, the symbol shown in that error looks like it belongs to
      the file you based yours on, not to your file that you removed. I
      assume you had renamed all your classes so there weren't any
      clashes. Hopefully you were working in a copy of the unpacked
      GPSim source, so you have two directory trees that you can compare
      (I like meld for this) to confirm that you've not left anything
      amiss?</p>
    <p>Regards,</p>
    <p>Rob</p>
    <p><br>
    </p>
  </body>
</html>

--------------0A62379E179932B79F9FA197--

--===============6710478341140936270==
Content-Type: text/plain; charset="us-ascii"
MIME-Version: 1.0
Content-Transfer-Encoding: 7bit
Content-Disposition: inline

--===============6710478341140936270==
Content-Type: text/plain; charset="us-ascii"
MIME-Version: 1.0
Content-Transfer-Encoding: 7bit
Content-Disposition: inline

_______________________________________________
gpsim-devel mailing list
gpsim-devel@lists.sourceforge.net
https://lists.sourceforge.net/lists/listinfo/gpsim-devel

--===============6710478341140936270==--

Closed 2020-05-13.

Thread 156 (2020-05-09):

Factoriser la gestion du PCLATH

f4bjh, 2020-05-09:
Mettre le calcul du PCLATH dans une fonction extérieure (pour gagner un peu de place)

f4bjh, 2020-05-09:
pas forcément très très évident...car l'appel à cette fonction va elle-même altérer la valeur du PCLATH...

Ce n'est pas bloquant...mais pourrait s'avérer nécessaire si la place dans le code venait à manquer...

A surveiller

f4bjh, 2020-05-16:
en prévision de tirer une nouvelle branche "menu_aop" pour les dev de la V0.8

f4bjh, 2020-06-09:
à date, il reste encore environ 4ko de disponible

Closed 2020-06-11.

Thread 158 (2020-05-09):

Modifier Vfwd ne modifie pas tension de sortie de l'AOP

f4bjh, 2020-05-09:
Dans le breadboard, sous gpsim, si on modifie vfwd, la tension de sortie de l'AOP n'est pas modifiée.

En effet, la tension de sortie n'est modifiée qu'à l'issue d'une écriture sur le bus I2C. Ce cas n'est pas le cas pratique, car en pratique, le couple AD5175 et LT1818 fonctionne en continue, et toute variation en entrée sera répercutée en sortie...

Il faut modifier le composant AD5175 de la librairie gpsim pour que la sortie suive l'entrée (au gain près)

f4bjh, 2020-05-11:
correction à placer dans le fw du PIC sous flasg de debug gpsim (comme DEBUG_ISSUE_134)

faire une mise à jour du gain forcée de manière régulière pour forcer la mise à jour de la tension de sortie de l'AD5175

voir s'il faudrait pas renommer ce blog car finalement, le bloc AOP = AD5175+LT1818 !!!

f4bjh, 2020-05-27:
grâce à https://github.com/f8kgl/swr_power_meter/commit/8eec09ea4d965e0d4a891a900a19d6d2f1f86a43

cette fiche devient invalide.

Car dans le menu ADC, on fait des mise à jours régulières du gain. Du coup, la tension de sortie est régulièrement mise à jour

Closed 2020-06-09.

Thread 159 (2020-05-09):

Enlever le flag DEBUG_ISSUE_134

f4bjh, 2020-05-09:
Il faudra obligatoirement enlever le flag DEBUG_ISSUE_134 des fw de test, calibration et opérationnel. La 1ère trame n'est pas censée provoquée un NACK de l'esclave.

Pour GPSIM, il faudrait, au minimum, avoir une explication...

#134

f4bjh, 2020-06-12:
Le NACK de la 1ère trame aurait t'il disparu comme par enchantement ???

f4bjh, 2020-06-12:
#134

Closed 2021-04-05.

Thread 160 (2020-05-09):

Il manque les octets de commande dans la doc d'implémentation

f4bjh, 2020-05-09:

f4bjh, 2020-05-11:
spécifier l'ensemble des trames i2c pour tous les composants connus à ce joiur
en profiter pour spécifier comment calculer rdac (ce qui servira pour la calibration)
essayer de rendre le schéma p35 avec le nom des chapitres §5.4.2, §5.5.2 etc

Closed 2020-05-13.

Thread 161 (2020-05-09):

Les valeurs lues par l'ADC ne sont pas bonnes

f4bjh, 2020-05-09:
A ce commit là : https://github.com/f8kgl/swr_power_meter/commit/8b4ee64962adcb80085815604fee095201afcd78

Il y a eunune regression ???

Pour Vfwd>0,6V, l'ADC retourne 0xFFF.
Avec des anciens commit, on n'avait pas ces valeurs là (Vfwd>4.096 => ADC=0xFFF)
De plus, les printf dans ltc2305.cc ne fonctionnent plus...

f4bjh, 2020-05-09:
#162 bloquant

f4bjh, 2020-05-10:
il y a un problème de ce que io_port->get est appelé 2 fois en fait (au travers de la trace dprintf en ligne 225 et par le return en ligne 226)

du coup byte_to_send change de valeur à chaque fois...

#165

Closed 2020-05-13.

Thread 162 (2020-05-09):

les printf ne fonctionnent plus dans ltc2305.cc

f4bjh, 2020-05-09:

f4bjh, 2020-05-09:
il reste des bouts de ltc2305 dans libgpsim_modules...et visiblement, c'est ceux là qui sont utilisés.

Du coup, les modifs dans ltc2305.cc, ne sont pas prises en compte...

besoin d'un gros make clean, et repartir from scratch (à nouveau...)

f4bjh, 2020-05-10:
#163 bloquant

Closed 2020-05-13.

Thread 163 (2020-05-10):

lib_swrpowermeterf8kgl_modules ne compile plus

f4bjh, 2020-05-10:
Il y a eu une cagade sur le composant ltc2305 sous gpsim. Il était dans libgpsim_modules. Si bien que les modifs n'ont pas été prises en compte.

En rebasculant finalement, comme ça doit être le cas, dans lib_swrpowermeterf8kgl_modules...le composant ne compile pas :

ltc2305.cc: In member function ‘unsigned int IOPort_ltc2305::get()’:
ltc2305.cc:151:5: warning: this ‘if’ clause does not guard... [-Wmisleading-indentation]
     if (voltage >4.096)
     ^~
ltc2305.cc:154:7: note: ...this statement, but the latter is misleadingly indented as if it were guarded by the ‘if’
       unsigned int converted = (unsigned int)( 4096* voltage )/4.096;
       ^~~~~~~~
ltc2305.cc: At global scope:
ltc2305.cc:278:1: fatal error: opening dependency file .deps/ltc2305.Tpo: Permission non accordée
 } // end of namespace LTC2305_Modules
 ^
compilation terminated.
make[2]: *** [Makefile:543: ltc2305.lo] Error 1
make[2] : on quitte le répertoire « /home/f4bjh/devel/tools/gpsim-0.31.0/modules »
make[1]: *** [Makefile:450: all-recursive] Error 1
make[1] : on quitte le répertoire « /home/f4bjh/devel/tools/gpsim-0.31.0 »
make: *** [Makefile:380: all] Error 2

f4bjh, 2020-05-10:
bon...rien de très grave en soi...

j'ai désinstallé complètement gpsim (et enlevé lib_swrpowermeterf8kgl_modules de usr/local/lib)
j'ai d'abord compilé gpsim "à blanc" sans modif
puis j'ai mis mes liens symboliques dans modules/ vers les fichiers de src/hw/sim/gpsim/lib
et j'ai suivi cette procédure :

$ autoreconf
$./configure
$make
$sudo make install
$sudo /sbin/ldconfig

Closed 2020-05-13.

Thread 165 (2020-05-10):

byte_to_send change de valeur 2 fois

f4bjh, 2020-05-10:
io_port->get est appelé 2 fois en fait (au travers de la trace dprintf en ligne 225 et par le return en ligne 226)

=>revoir la gestion de bytes_to_send, et plutôt la basculer dans ltc2305::get_data(

Closed 2020-05-13.

Thread 167 (2020-05-10):

Avec l'AD5175, l'ADC retourne 0

f4bjh, 2020-05-10:
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

f4bjh, 2020-05-10:
#169  bloquant
#170  bloquant

f4bjh, 2020-05-11:
#179 bloquant

f4bjh, 2020-05-11:
testé ave 0.005 et 0.010V en entrée de l'AOP => OK

restrictions d'ores et déjà connues (liées à gpsim a priori) :
-pas de MAJ de la tension d'entrée à la volée
-pas de tempo pour la conversion (normalement, 1,3us)

Closed 2020-05-13.

Thread 168 (2020-05-10):

Ajouter le LT1818 au schéma

f4bjh, 2020-05-10:
Poser le composant LT1818 au schéma (sans autre ajout supplémentaire pour le moment)

Même principe que la #164

F0EOS, 2020-05-10:
pas dispo dans la bibliothèque de KICAD

faut que je le face

tu le veux en MSOP 8 ou T-SOT23 ?

f4bjh, 2020-05-10:
exact...la doc n'est pas assez précise...

je complète cela dès que possible. #171 bloquant

f4bjh, 2020-05-11:
#172 bloquant

f4bjh, 2020-05-11:
référence ci-dessus erronée

f4bjh, 2020-05-13:
Ahhh y est !!!

On en était là, tu te souviens ?

Tu trouveras tout ce qu'il te manque (a priori, et sauf oubli involontaire de ma part) içi :

https://github.com/f8kgl/swr_power_meter/blob/master/doc/SWR_POWER_METER_F8KGL_specifications_V0.7.pdf

Pour le moment, dans cette fiche, il n'est question "QUE" de poser le composant LT1818 au schéma (sans autre ajout supplémentaire pour le moment)

f4bjh, 2020-05-13:
#118

f4bjh, 2020-05-16:
Very very good job !!! :-)

Closed 2020-05-18.

Thread 169 (2020-05-10):

Supprimer le gain à appliquer à get_nodeVoltage

f4bjh, 2020-05-10:
Pourquoi faut-il appliquer un gain à la prise de mesure dans le ltc2305 :

        voltage0 = (2.5*voltage0)/0.036946;

f4bjh, 2020-05-11:
ne fudrait-il pas passer aussi par un get_Vpullup ?

f4bjh, 2020-05-11:
nécessiterait de casser l'implémentation de l'objet pEE (si c'est bien lui qui est utilisé d'ailleurs, dans l'interface avec gpsim ???)

Closed 2020-05-13.

Thread 170 (2020-05-10):

Utliser une pullup comme modèle pour la sortie de l'AD5175

f4bjh, 2020-05-10:
voir resistor.cc

quelle est la mécanique utilisée dans get_nodeVoltage ?

f4bjh, 2020-05-11:
je pense que set_nodeVoltage utilise ceci (de src/stimuli.cc)

void IOPIN::set_nodeVoltage(double new_nodeVoltage)
{
    if (verbose & 1)
        std::cout << name() << " set_nodeVoltage old=" << nodeVoltage << " new=" << new_nodeVoltage << '\n';

    nodeVoltage = new_nodeVoltage;

    if (nodeVoltage < h2l_threshold)
    {
        // The voltage is below the low threshold
        setDrivenState(false);
    }
    else if (nodeVoltage > l2h_threshold)
    {

        // The voltage is above the high threshold
        setDrivenState(true);

    }
    else
    {
        // The voltage is between the low and high thresholds,
        // so do nothing
    }

    //setDrivenState(getBitChar());
    if (m_monitor)
        m_monitor->set_nodeVoltage(nodeVoltage);
}

déjà, je suis pas sûr du tout des valeurs de l2h_threshold et h2l_threshold.
Et puis de toute façon, c'est pas le but recherché...

f4bjh, 2020-05-11:
voir dans src/stimuli.h :

set_Vpullup
et les 3 variables :
    bool   bPullUp;  // True when pullup is enabled
    double Zpullup;  // resistance of the pullup
    double Vpullup;  // Voltage the pullup resistor is tied to.

f4bjh, 2020-05-11:
#176 bloquant

f4bjh, 2020-05-11:
#177 bloquant

f4bjh, 2020-05-11:
#178 bloquant

Closed 2020-05-13.

Thread 171 (2020-05-10):

Préciser l'implémentation du module AOP

f4bjh, 2020-05-10:
boitier à utiliser
schéma AOP non inverseur
compléter toutes les pins
vérifier l'adresse du device

ajouter une résistance de test "NM" à la place de l'AD5175

f4bjh, 2020-05-11:
référence à #168 ci-dessus érronée

f4bjh, 2020-05-11:
référence à 168 erronée

Closed 2020-05-13.

Thread 173 (2020-05-11):

Petit tutoriel de GitHub Desktop

f4bjh, 2020-05-11:
Pourrais-tu me faire un rapide tutoriel de l'utilisation que tu fais de GitHub Desktop s'il te plait ?

Une dizaine (ou même moins) suffirait largement. Avec quelques copies d'écran.

Merci :-)

f4bjh, 2020-05-12:
référence 148 erronée

f4bjh, 2020-05-16:
Il est parfait ton Tuto github !!!

Merci beaucoup !!!

f4bjh, 2020-05-16:
A intégrer dans la doc d'implémentation

Thread 175 (2020-05-11):

faire la doc d'implémentation sw

f4bjh, 2020-05-11:
faire le détail de l'implémentation dans la doc
mettre dans le code source, en commentaire, que les interfaces

ou bien faire l'inverse ???

f4bjh, 2020-05-11:
à bien y réfléchir...cette doc pourra être faite que lorsque les tests auront été effectués...

Thread 180 (2020-05-11):

Tenir compte du temps de conversion de l'ADC (1,3us)

f4bjh, 2020-05-11:
A implémenter sous gpsim (=>renvoyer des NACK)

rajouter une tempo de 10us (?) entre chaque trame write et chaque trame read (de telle manière à être sûr d'avoir un ACK)

f4bjh, 2021-02-26:
A mettre dans l'étude (V0.8)

la doc HP en parle (en gros, il faut 3 ou 4 cycles de porteuse avant de pouvoir lire Vdc)

f4bjh, 2021-04-01:
s'agissant du détecteur HF, s'il répond en 5 coup de porteuse, ça fait jamais plus que 400ns...

par contre, pour le temps de conversion, il faudrait déjà mesurer le temps entre la trame write et la trame read...

à rajouter aux tests déjà

Thread 183 (2020-05-12):

PIC Stack overflow avec AOP Refléchi

f4bjh, 2020-05-12:
suite au commit https://github.com/f8kgl/swr_power_meter/commit/280d4db1029d5610b5f3062fcf108836a3268a73

le PIC se plante sous gpsim :

Reset on Stack overflow
 real time clearing

f4bjh, 2020-05-12:
le calcul de PCLATH dans c_bootmsgL2 n'est pas correct.

Dès le 1er caractère, la dite correction fixe le PCLATH à 0x02, ce qui n'est pas correct.

Closed 2020-05-13.

Thread 186 (2020-05-13):

livraison des docs sous git

f4bjh, 2020-05-13:
Le problème vient de ce que les docs sont au format binaire. Et le merge est compliqué dans ce cas là...

1/déplacer les .odt, xls, etc de swr_power_meter/doc vers src/doc et envlever les numéro de versions
2/dans la doc d'implémentattion, comment il faut générer des .ps et .pdf (et/ou autre) dans swr_power_meter/doc avec le numéro de version de l'étiquette

Closed 2020-05-13.

Thread 188 (2020-05-13):

Spécifications V0.8

f4bjh, 2020-05-13:
-Calibration
ajout de l'EEP (interface HW)
spécifier les fonctionnalités haut niveau + driver EEP pour le sw

-Programmateur
Raspberry + interface I2C et PIC

-Spécifier les versions en kit (monté totalement ou partiellement (sans ligne de mesure), en kit total)

-fiche #187

-mettre à jour les version (calibration à partir de la V0.8)

f4bjh, 2020-05-16:
#104
#110
#149

f4bjh, 2021-02-19:
http://www.tscm.com/detector.pdf

https://analog.intgckts.com/rf-power-detector/diode-detector-2/

https://cds.cern.ch/record/211448/files/CERN-92-03-V1-V2.pdf

https://cds.cern.ch/record/211448?ln=fr

https://cds.cern.ch/record/1982420/files/101-156%20Caspers.pdf

https://iopscience.iop.org/article/10.1088/1361-6641/aa89ce/pdf

THE HIGH FREQUENCY PERFORMANCE OF A SCHOTTKY
DIODE DETECTOR
by
Albert Sears Crane

f4bjh, 2021-02-19:
http://g3ynh.info/circuits/diode_data/AN986.pdf

f4bjh, 2021-02-22:
https://www.cambridge.org/core/journals/international-journal-of-microwave-and-wireless-technologies/article/noise-conversion-of-schottky-diodes-in-mmwave-detectors-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

f4bjh, 2021-02-22:
http://astro.physics.free.fr/pcsi/10.pdf

f4bjh, 2021-02-22:
http://www.dl5neg.de/powermeter/theory/apn1014.pdf

f4bjh, 2021-02-22:
https://assets.testequity.com/te1/Documents/pdf/keysight/RF-microwave-fundamentals-2.pdf

f4bjh, 2021-02-23:
#326

f4bjh, 2021-02-23:
#309

Closed 2022-02-07.

Thread 189 (2020-05-13):

Offset AOP

f4bjh, 2020-05-13:
Un AOP, alimenter de manière symétrique, génère forcément un offset en sortie

f4bjh, 2020-05-16:
en prévision de tirer une nouvelle branche "menu_aop" pour les dev de la V0.8

f4bjh, 2020-05-26:
à reporter dans le fw ET dans GPSIM !!!

Closed 2020-06-09.

Thread 190 (2020-05-13):

fixer la résistance plutôt que le gain du bloc AOP

f4bjh, 2020-05-13:
§5.5.2 des spec V0.8

f4bjh, 2020-05-26:
Ben non en fait...

Vu qu'on imposer G = puissance de 2, repasser par un calcul de Rdac supposer de refaire un calcul de division...ce que l'on veut précisemment éviter.

Préférer largement une table de conversion G -> Rdac

Closed 2020-06-09.

Thread 191 (2020-05-13):

LIBRAIRIE PROJET

F0EOS, 2020-05-13:
lors de la création du LT818 et sont enregistrement j'avais deux dossier librairie projet PK ??

dans les post  librairie projet n'a pas ete poste, il ne sais pas sélectionner automatiquement normal ??

f4bjh, 2020-05-13:
Sous Kicad, dans l'éditeur de schéma, peux tu aller dans "Préférences->Configurer les librairies de symbole ->Librairies Spécifiques au Projet" ?

Et faire une copie d'écran

f4bjh, 2020-05-13:
#168

f4bjh, 2020-05-14:
André :

**1/Problème de librairie**
Sous Kicad, dans l'éditeur de schéma, peux tu aller dans "Préférences->Configurer les librairies de symbole ->Librairies Spécifiques au Projet" ?

Et faire une copie d'écran

**2/Erreur nom de composant**
attention, le nom du composant ajouté est erroné.
Il faut mettre LT1818 et non pas LT818

**3/Oubli de la chaine "REF**
Si tu regardes bien les specs, il faut deux fois le composant AD5175, et deux fois le composant LT1818

Voilà, voilà

f4bjh, 2020-05-16:
Je suppose donc que ton problème de librairie est finalement résolu.

Closed 2020-05-18.

Thread 194 (2020-05-16):

rajouter un connecteur d'alim pour le xWATT-METER F8KGL

f4bjh, 2020-05-16:
Je suis en train de bosser sur les specs de la V0.8.

Vu que pour le moment, tu bosses sur la V0.7, pour le moment, ne traite pas encore cette fiche.

De plus, il faudra que je t'explique ce qu'est ce "xWATT METER F8KGL", qui est la grande nouveauté de la V0.8 (en gros, c'est la possibilité de convertir la partie wattmètre du projet en un micro-wattmètre...). Mais pour cela, il faudrait que tu ais accès aux nouvelles spécifications...

Ce n'est donc pas pour tout de suite.

Closed 2021-03-08.

Thread 195 (2020-05-16):

Dans les specs, rajouter une restriction à la V0.7

f4bjh, 2020-05-16:
La conversion en mV n'est pas bonne (car la table de calibration n'est pas bonne).

Cet aspect est corrigé dans les specs de la V0.8, en cours de rédaction

f4bjh, 2020-05-18:
https://github.com/f8kgl/swr_power_meter/commit/957d6ebf1e19beadbc88f2f863e3d878068082c3

Closed 2020-05-26.

Thread 196 (2020-05-16):

Mettre l'architecture hw au schéma

f4bjh, 2020-05-16:
Voici (enfin !!!) l'étape suivante à faire au schéma, suite à la mise au schéma des ADC, AOP, diodes, etc...

L'étape suivante **est** une étape **trèèèèès** délicate, et complexe. Elle nécessite attention et concentration. Si cette étape est mal aboutie, elle peut carrément provoquer des erreurs de routage sur le circuit imprimé, ou bien provoquer un circuit complètement inroutable...voire même...faire un circuit qui ne fonctionne pas !!! C'est dire si cette étape est **particulièrement** cruciale

L'idée générale est de d'ordonner les composants du schéma de telle manière à ce que  : **1/AUCUN FIL NE SE CROISE JAMAIS**
**2/NE JAMAIS DESSINER AUCUN FIL DE CONNEXION SUR LE SCHEMA POUR LE MOMENT**
**3/IMAGINER LES CONNEXIONS PAR LA PENSEE EN CHERCHANT A FAIRE LES CONNEXIONS LES PLUS DIRECTES POSSIBLES**
On parle donc _d'architecture du schéma_

Je conseille de procéder de la manière suivante :
-ouvrir le fichier pdf des spécifications sur la moitié gauche de l'écran.
-ouvrir le schéma sur la moitié droite de l'écran

D'après le schéma bloc de la page 18, le bloc "détecteur HF" est connecté au bloc "AOP". Le bloc "AOP" est constitué de l'AD5175 et du LT1818 =>
Commencer par rassembler l'AD5175 et le LT1818 l'un à côté de l'autre de telle manière à ce que aucun fil ne se croise sans dessiner aucun fil de connexion, et que les connexions soient les plus courtes et directes possibles. Quand tu es arrivé là, tu rapproches le bloc AOP du détecteur HF de telle manière qu'aucun fil ne se croise non plus sans dessiner aucun fil de connexion, et que les connexions soient les plus courtes et directes possibles.

Quand tu es arrivé là, tu fais la même chose avec l'ADC.
Puis la même chose avec le PIC
Puis la même chose avec le LCD
Puis la même chose avec le régulateur.

Il est tout à fait possible, qu'à un moment donné tu te retrouves bloqué, il faudra alors analyser la situation en créant une nouvelle fiche.

J'ai commencé à regarder la faisabilité de cette fiche. Je pense que c'est possible. Mais je pense que tu vas devoir refaire les connexions PIC/LCD pour y arriver...à voir...

 Voilà, voilà.
N'hésite pas à poser des questions si c'est pas clair.

f4bjh, 2020-05-16:
OK. C'est pas mal.

Peux tu relier les entrée "IN+" des LT1818 aux détecteur HF FWD et REF ? Sans avoir de fil qui se croise bien sûr...

f4bjh, 2020-05-16:
Oublie ma question.

Vas-y continue...

f4bjh, 2020-05-18:
dernier commit de bonne qualité !!!

Je te propose de commencer par traiter la fiche #203 pour commencer

Closed 2020-05-26.

Thread 197 (2020-05-16):

Ajouter un flag de compilation pour le xWATT METER

f4bjh, 2020-05-16:
pour les fw de calibration et opérationnel

f4bjh, 2021-04-05:
https://github.com/f8kgl/swr_power_meter/commit/6cc2faf1f6a761a20fc0b531e3eac7de9b20d01a

implémenté depuis belle lurette :-p

Closed 2021-04-05.

Thread 200 (2020-05-16):

Menu "ADC"

f4bjh, 2020-05-16:
Implémenter le menu ADC dans le fw de test

A priori, il n'y que la fonction de conversion ASCII à corriger (ou plus précisemment, supprimer la table de calibration actuellement embarquée dans la flash)

Closed 2020-06-09.

Thread 202 (2020-05-17):

Problème d'extraction de police de caractère dans les docs en pdf

F0EOS, 2020-05-17:
une erreur de police a l'ouverture de SWR_POWER_METER_F8KGL_specifications

cela s'affiche quand j'arrive a la page 21

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

F0EOS, 2020-05-17:
j'ai oublier j'ai plein de tbd ou Tbd rouge sur le pdf en question

Ça correspond a quoi ?

f4bjh, 2020-05-18:
en fait "tbd" ça veut dire (en anglais) "To Be Defined"...
Par exemple, en page 19 tu trouves :

Le bloc « Alimentation » est composé de tbd modules :
tbd

c'est à dire qu'à l'heure actuelle, je ne sais pas encore exactement combien il y aura de composant dans le bloc "Alimentation" du schéma...bon, cet exemple n'est pas encore super parlant...parce qu'en fait on sait déjà qu'il y a un régulateur 5V...et horsmis cela, je vois pas trop ce qu'on pourrait enlever ou rajouter...faudrait que je fasse un petit effort pour enlever tous les "tbd" et entièrement tout spécifier.
A vrai dire ce n'est pas ma priorité à l'heure actuelle. Je suis surtout sur les algorithmes de calibration, qui sont des sujet beaucoup plus complexes pour moi...

Autrement dit, et en résumé, tout partout ou tu vois des "tbd" en rouge, ça veut simplement dire que je n'ai pas encore assez travaillé ce sujet là en particulier. Mais qu'un jour ou l'autre, ce sujet là sera précisé et entièrement spécifié.

Ca veut dire qu'il y aura encore des modifs de schéma ? C'est possible oui...

f4bjh, 2020-05-18:
S'agissant du problème d'extraction de police, il semblerait que cela vient d'un paramètre de configuration à placer dans Libreoffice, qui me sert d'éditeur de document.

C'est un bug. Je le corrigerai (du moins j'essaierai...) quand j'aurais traiter tous les autres bugs (et j'en ai quelque uns ;-)

f4bjh, 2020-05-27:
Malheureusement, je crains qu'il ne soit pas possible de résoudre ce problème :

https://ask.libreoffice.org/en/question/190046/exported-pdf-gives-liberationserif-font-error-in-adobe-acrobat-reader/

Closed 2020-06-09.

Thread 203 (2020-05-18):

Condensateur de découplage ?

f4bjh, 2020-05-18:
Dans les spécifications, on trouve des capa de découplage.

Faut-il appliquer les capa de découplage par circuit intégré, ou bien juste une seule fois ?

commit : https://github.com/f8kgl/swr_power_meter/commit/276b805cb30e5b73475a4ad56100f380ebf32168

f4bjh, 2020-05-18:
Alors, pour répondre à ta question, je t'invite à lire cette excellente page Wikipedia :
https://fr.wikipedia.org/wiki/Condensateur_de_d%C3%A9couplage

Et je te retourne la question : Faut-il appliquer les capa de découplage par circuit intégré, ou bien juste une seule fois pour tous les circuits intégrés du schéma ? Et pourquoi ?

f4bjh, 2020-05-19:
https://github.com/f8kgl/swr_power_meter/commit/44e5e039900b94dcaa12221737dca48e4b943d86

Il faut effectivement un jeu de capa de découplage par circuit intégré. Cablé au plus court, pour que les signaux soient bien filtrés à _chaque_ fois

Closed 2020-05-26.

Thread 204 (2020-05-18):

Spec pas clair sur le bloc AOP

f4bjh, 2020-05-18:
https://github.com/f8kgl/swr_power_meter/commit/276b805cb30e5b73475a4ad56100f380ebf32168

Les specs V0.7 sont un peu figées à vrai dire. Et le mettre à jour supposerait de dévoiler les specs V0.8, et donc de taguer sur git la V0.7...

Bref...tout ça pour dire que dans l'état actuel des choses...va falloir se creuser un tout petit peu les méninges pour effectivement comprendre les specs dans l'état dans lequel elle se trouve.

Mais je ne vais pas non plus te laisser en rade...Donne moi juste un tout petit de temps, pour pouvoir t'aider.

Closed 2020-05-26.

Thread 212 (2020-05-19):

Résistance de "test" à mettre au schéma

f4bjh, 2020-05-19:
https://github.com/f8kgl/swr_power_meter/commit/44e5e039900b94dcaa12221737dca48e4b943d86

Voir spec page 27 : il faut une résistance de test entre A et W pour chaque AD5175 (U4 et U7)

Closed 2020-05-26.

Thread 215 (2020-05-19):

Raccourcir les fils connectés à GND

f4bjh, 2020-05-19:
https://github.com/f8kgl/swr_power_meter/commit/44e5e039900b94dcaa12221737dca48e4b943d86

Dans le mesure du possible, rapporcher les GND aux pins qui y sont connectées en direct.

Exemple : la pin 4 de U5, la pin 10 de U4.

Au routage, ces pins seront connectées au plan de masse par une via...autant alléger le schéma tout de suite

Closed 2020-06-16.

Thread 216 (2020-05-19):

Rapprocher les capa de découplage

f4bjh, 2020-05-19:
https://github.com/f8kgl/swr_power_meter/commit/44e5e039900b94dcaa12221737dca48e4b943d86

Autant que possible, rapprocher les capas de découplage des composants.

Par exemple :

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

et sans doute les tourner de 90° pour qu'elles aient la tête en bas

Closed 2020-06-16.

Thread 217 (2020-05-19):

revue des deltas spec V0.7 versus V0.8

f4bjh, 2020-05-19:
et faire une revue des fiches en conséquence

f4bjh, 2020-05-26:
§3.1 -> #224
§3.2.1 -> #223
§3.4 -> #225
§4.2 -> #16
§4.3 -> #144
tracer le bus I2C au schéma : #226
RDAC OTP ? -> #227 §4.6.1.1
§4.6.2 -> #210
§4.6.2.1 -> #228
§4.7.2 -> #229 et #222
§4.8.1 -> #231
§4.8.2 -> #222
§4.9 -> #34
§4.10 -> #208 et #232
§5.1.1 -> #233 #234
§5.2 -> #235
#209
#200 #201

Closed 2020-05-26.

Thread 219 (2020-05-19):

Etablir une procédure de tests de production

f4bjh, 2020-05-19:
https://github.com/f8kgl/swr_power_meter/commit/5ca3b4ec26eb540c530912a147dba88cd136aa3a

La procédure sera établie à partie de la V1.0 seulement.

C'est à dire sur le proto, et avec le FW de test.

Définitivement pas de fw de calibration sur la V0.8

f4bjh, 2021-02-18:
#293

Closed 2021-02-18.

Thread 220 (2020-05-19):

Etablir un cahier de recette pour le fw de TEST

f4bjh, 2020-05-19:
doit contenir une validation élément par élément sur le proto
doit contenir une validation de l'architecture avec le FW de test
doit contenir une validation des perf avec le FW de test (typiquement, dynamique d'entrée)
doit contenir une validation des élements de la spec
doit permettre d'établir une procédure de calibration

f4bjh, 2021-02-12:
#293

Closed 2021-02-18.

Thread 223 (2020-05-26):

Spécifications du boitier

f4bjh, 2020-05-26:
Actuellement spécifié :  155x80x100 mm

Dépend des dimensions du LCD, de la ligne de mesure
155 de large OK
80 de hauteur ok voir un peu plus petit reste a déterminer en fonction de l'afficheur
profondeur 100 pk pas 70 me parait pas mal non plus

f4bjh, 2021-04-01:
#188

f4bjh, 2022-02-07:
repoussé en V1.0 lors des tests de montage

Thread 226 (2020-05-26):

Tracer le bus I2C au schéma

f4bjh, 2020-05-26:
Faire les connexions du bus I2C de U7 et U4, et de l'EEP

f4bjh, 2020-05-27:
Voici un lien qui donne de bonnes informations sur ce qu'est un bus I2C :

https://fr.wikipedia.org/wiki/I2C

Closed 2020-06-16.

Thread 244 (2020-05-26):

Ajout du détecteur HF à GPSIM

f4bjh, 2020-05-26:

f4bjh, 2021-02-18:
trop complexe, et pas assez de temps pour le faire, compte tenu du gain que cela pourrait effectivement apporté
de plus, il y a trop de dispersions entre 2 diodes pour que cela vale le coup de développer un tel truc...de simulation...

Closed 2021-02-18.

Thread 245 (2020-05-26):

Impédance d'entrée du détecteur HF

f4bjh, 2020-05-26:
Faudrait-il prévoir un petit circuit d'adapation en entrée du détecteur HF ?

Est-ce bien raisonnable ? Et varie t'il en fonction de la puissance d'entrée (car fonctionnement non linéaire !!!)

f4bjh, 2021-04-05:
circuit Pi ajouté en entrée du détecteur HF

Closed 2021-04-05.

Thread 246 (2020-05-26):

Entrée de l'AOP est elle suffisament haute impédance ?

f4bjh, 2020-05-26:
Pose finalement surtout la question de l'interface Détecteur HF/AOP.

Quels sont les risques ? De quel nature ? Quelles conséquences ???

Mmmhhh....vastes et nombreuses questions....

Closed 2021-04-05.

Thread 249 (2020-05-26):

Ajout des pull up sur le bus I2C au schéma

f4bjh, 2020-05-26:

f4bjh, 2020-05-27:
Les "pull up" sont des résistances de connexion entre le "+" de l'alimentation et un signal (numérique en général)
Elles ont pour but de fixer ce signal à +5V par défaut. Dans le cas contraire, la tension serait flottante, et le comportement deviendrait aléatoire.

Closed 2020-06-16.

Thread 250 (2020-05-26):

Fixer le gain à G=2 dans le menu ADC du fw de test

f4bjh, 2020-05-26:
voir spec p42 !!!

f4bjh, 2020-05-27:
Je viens de m'apercevoir que la resistance Raw de l'AD5175 est en fait soumise à dispersion. Sa valeur calibre peut être obtenue avec un lecture I2C dans l'AD5175. Ce sera à implémenter dans le fw de calibration et opérationnel. Du coup, il faudra sans doute prévoir de mettre la table de gain en EEPROM (ça prendre une dizaine d'octet par voie...à peine...)

La table de gain devra être calculé par le calibrateur. Par contre, ça veut dire qu'il risque d'y avoir un impact (peut-être pas négligeable) sur la précision de la mesure.

f4bjh, 2020-05-27:
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

f4bjh, 2020-05-27:
#200

Closed 2020-06-09.

Thread 254 (2020-05-27):

faire des tableaux similaires au §4.8.1 pour tous les autres composants

f4bjh, 2020-05-27:
histoire d'avoir un peu déjà une idée de la conso
d'assurer que tous les Vdd sont bien à 5V (hum hum...)
et vérifier 2 ou 3 paramètres sont bien dans les clous...

mettre tout ça dans la spec

Closed 2021-03-08.

Thread 255 (2020-05-27):

changement de méthode de chargement par gpsim

f4bjh, 2020-05-27:
grâce au commit https://github.com/f8kgl/swr_power_meter/commit/bc73183f2d8df874e9ca1dd2ffdd4f80191650d0

il n'est plus nécessaire, dorénavant, de faire les manips de changement de fréquence (freq 4000000) et de charger netlist.stc au démarrage de gpsim.

la seule commande suivante suffit :

$ cd .../swr_power_meter/bin
$ gpsim -c swr_power_meter.stc

Au préalable, dans swr_power_meter/bin, il faut avoir créer les liens symboliques :

$ ln -s ../prj/swr_power_meter.stc
$ ln -s ../src/hw/sim/gpsim/netlist.stc

A documenter (en profiter pour retrouver la manière de mettre un oscillo sous gpsim, si c'est pas déjà documenté dans la doc d'implémentation => à vérifier)

f4bjh, 2020-06-05:
ajouter un scope par défaut, connecté sur le bus I2C

Closed 2021-02-18.

Thread 256 (2020-05-27):

le bouton poussoir sous gpsim n'est pas à relâchement

f4bjh, 2020-05-27:
du coup, dès qu'on appuit dessus, le signal reste à 1 (ou à 0 suivant le cas)...

C'est embếtant...et a priori ne reflète le vrai fonctionnement des boutons

f4bjh, 2020-05-28:
mouais...c'est pas clair ce truc là non plus...

Il semblerait que si, mais le fil reste rouge tant qu'on appuie pas sur le bouton du breadboard.

=>création d'un flag DEBUG_ISSUE_256

f4bjh, 2020-06-03:
contournement https://github.com/f8kgl/swr_power_meter/commit/521a0d3bd67d80226fae8f1d65b6d6060583ee99

permet de gérer aussi l'antirebond par la même occasion

Closed 2020-06-09.

Thread 257 (2020-05-27):

Sous GPSIM, dans le menu ADC, erreur de remontée de mesure pour V=1mV

f4bjh, 2020-05-27:
On s'attend à lire 2mV, puisque G=2, et pourtant, le LCD affiche 1mV

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

f4bjh, 2020-06-08:
mais en fait, aussi pour V=10mV...car la mesure remonte 9mV...

f4bjh, 2020-06-08:
en forçant 5k pour R2, Rdac=0x200, la sortie AOP passe à 2,068V

ad5175.cc:226 ad5175::match_address() 0x5e
ad5175.cc:179 ad5175::put_data() 0x6
ad5175.cc:186 set rdac to 0x200
ad5175.cc:179 ad5175::put_data() 0x0
ad5175.cc:196 set rdac to 0x200
ad5175.cc:105 rdac=5000.000000
ad5175.cc:114 voltage_in=0.010000 voltage_out=2.068000
ad5175.cc:200 vPullup=2.068000

f4bjh, 2020-06-08:
mais l'ADC ne mesure visiblement pas correctement :

ltc2305.cc:158 voltage=2.067989 (0x0813)

Closed 2020-06-09.

Thread 258 (2020-05-28):

passer la gestion des boutons sous IT

f4bjh, 2020-05-28:

f4bjh, 2020-05-28:
uniquement le bouton "bande" et uniquement lorsque l'on veut veut changer de menu

f4bjh, 2020-05-29:
en fait l'idéal, et puis surtout après être tombé dans le bug #256, il s'avère que le plus malin, simple et intéressant, ce serait de déveopper une machine d'état.

Machine qui calculerait l'état suivant (en fonction de l'état des boutons typiquement, mais aussi de l'état courant évidemment) sous une IT timer de 1ms.
Chaque état contiendrait alors une fonction élementaire (temps d'éexcution <1ms)
On garantirait ainsi le tps de conversion ADC par la même occasion (!!!)
un état codé sur 8 bits, donne au max 255 état possibles (ce qui semble pas mal quand même)
on est certain de ne pas râter des appuis boutons s'ils arrivent au minimum toutes les ms (à l'échelle de l'humain, c'est laaaargement suffisant...les OM ne sont pas des lucky luck ;-)
Après, le delta T entre 2 conversions vaudra au max 255ms...ce qui semble déjà pas mal finalement
cette machine d'état sera ré-employable (et sans doute ré-employé) dans les fw de calibration et (surtout !!!) mesure
pour s'assurer des timings, il faudra tracer le temps mis par chaque état dans les logs. En admettant qu'une trace de timer prendrait 5 octets (tag, longueur + 2 octets de valeur + marqueur de fin), en admettant un nombre max d'état de 32, ça prendrait 160 octets dans l'EEP du PIC. Ca laisse un tout petit peu de place pour logger les autres évenements

f4bjh, 2020-06-03:
pas nécessaire : https://github.com/f8kgl/swr_power_meter/commit/521a0d3bd67d80226fae8f1d65b6d6060583ee99

Closed 2020-06-09.

Thread 260 (2020-05-28):

ajout d'un pont diviseur au schéma, pour les tests

f4bjh, 2020-05-28:
à placer en entrée de l'AOP, connecté sur le + d'alim

mettre un pont diviseur à l'entrée des AOP FWD et REF, qui ramène 1V, bien calibré.

Profiter de la capa de 47n, pour mettre une option "résistance"

A spécifier, plus implémenter

Closed 2021-02-18.

Thread 263 (2020-05-28):

Déplacer RS et E du LCD sur RB0 et RB1 au schéma

f4bjh, 2020-05-28:

f4bjh, 2020-05-28:
#261

f4bjh, 2020-05-28:
p29 et 30 des specs

En profiter pour mettre des marqueurs de non connections sur RA6, RA7,RB2,RB3

f4bjh, 2020-06-02:
Dis-voir...est-ce qu'on prévoir de déporter le LCD sur la face avant du boitier ?

Parce que dans ce cas...on se moque pas mal du brochage du connecteur LCD...vu qu'il y aura une nappe électrique entre le LCD physique et la platine de mesure...et le cable (qui contiendra 8 fils si je compte bien) se chargera de croiser les fils si besoin est. Tu piges l'idée ?

Closed 2020-06-16.

Thread 264 (2020-05-28):

doc V2.0

f4bjh, 2020-05-28:
Faire une et une seul doc avec absolument tout dedans :

1/basculer le laïus sur les piles et le lcd en annexe
2/mettre en annexe l'étude du détecteur HF, l'implémentation, le cahier de tests, principe de calibration, le bref descriptif pour le proceedings de CJ, le mode d'emploi...etc etc...

f4bjh, 2021-02-23:
fiche tampon, qui recevra les livraisons pour doc V1.0 à l'état de brouillon

f4bjh, 2022-02-07:
a spécifier en V1.0 :

fonctionnalités SW calibration et opérationnel
LCD 4 lignes – 16 caractères
lignes de couplage (imprimée et coax semi rigides)

f4bjh, 2022-05-23:
en v1.0 on se limitera peut-être à l'aspect calibration. à voir dans la doc

Thread 271 (2020-05-28):

implémenter "calcul des tensions calibrées" dans [CALC]

f4bjh, 2020-05-28:
voir si spec complètes et implémentables en l'état

à implémenter

f4bjh, 2020-05-28:
bloque #188

f4bjh, 2020-05-28:
spec a priori OK en l'état

f4bjh, 2020-06-05:
le commit https://github.com/f8kgl/swr_power_meter/commit/809d66de1319a6596edb9c0df0c39f17f612ac6c est une 1ère mouture

Plusieurs problèmes vus, après un test rapide :
1/à la sortie du menu de calcul, la valeur de n est réinitialisée
2/l'affichage de la tension calibrée "saute"
3/il faudra simplifier la fonction f_calc_partie_decimale, et factoriser tout ça (ça va prendre une place folle en flash sinon)
4/la partie décimale est bloquée à 0

la partie entière a l'air d'être plutôt bien calculée

f4bjh, 2020-06-05:
1 et 2 résolus avec commit https://github.com/f8kgl/swr_power_meter/commit/66f41a65b9e7f8a46d17ab331f1ff99c835a9204

f4bjh, 2020-06-08:
4 résolu avec https://github.com/f8kgl/swr_power_meter/commit/315dc46a64ec8fb90afa10f6a6c80863e6e829cd

Closed 2020-06-09.

Thread 272 (2020-05-28):

implémenter les logs "timer ADC" et registre RCON

f4bjh, 2020-05-28:

f4bjh, 2020-05-28:
le TIMER0 du PIC semble adapté au spec. Visiblement, il ne peut se synchroniser au miuex que sur Fosc/4. Soit toutes les us...
Calibrer cela avec une fonction de délai présent dans MISC au démarrage

f4bjh, 2020-06-02:
reste plus qu'à généraliser tout ça

f4bjh, 2020-06-03:
avec ce dernier commit, ça marche en pas à pas (jusqu'à l'adresse 0x00ae):
**gpsim> dump e
       00 01 02 03 04 05 06 07 08 09 0a 0b 0c 0d 0e 0f
0000:  56 30 2e 38 00 28 00 00 00 00 00 00 00 00 00 00    V0.8.(..........
0010:  10 54 45 53 56 30 2e 38 20 1c 00 ff ff ff ff ff    .TESV0.8 .......
0020:  40 0b ff ff ff ff ff ff 00 00 00 00 00 00 00 00    @..............

mais dès qu'on passe en mode "normal" (execution totale du code jusqu'au menu mesure) :
      00 01 02 03 04 05 06 07 08 09 0a 0b 0c 0d 0e 0f
0000:  56 30 2e 38 00 28 00 00 00 00 00 00 00 00 00 00    V0.8.(..........
0010:  10 54 45 53 56 30 2e 38 20 1c 00 ff ff ff ff ff    .TESV0.8 .......
0020:  40 fa ff ff ff ff ff ff 00 00 00 00 00 00 00 00    @...............

c'est à dire qu'en mode "normal", TMR0L = 0!!!

f4bjh, 2020-06-04:
#281

Closed 2020-06-09.

Thread 274 (2020-05-28):

Bouton calibration + et - au schéma

f4bjh, 2020-05-28:
non encore spécifié pour le moment dans le pdf (mais présent dans les specs fodt)

regénérer les pdf

f4bjh, 2020-06-19:
André : voici l'étape suivante
Ajouter les boutons au schéma. Sauf erreur de ma part, ils sont donc la doc

f4bjh, 2021-02-12:
Il faut rajouter des pull up sur les boutons poussoirs et une petite capa anti rebond :

https://zestedesavoir.com/tutoriels/686/arduino-premiers-pas-en-informatique-embarquee/743_gestion-des-entrees-sorties/3423_un-simple-bouton/

f4bjh, 2021-02-17:
#289

f4bjh, 2021-02-23:
Il faut rajouter des pull up sur les boutons poussoirs et une petite capa anti rebond :

https://zestedesavoir.com/tutoriels/686/arduino-premiers-pas-en-informatique-embarquee/743_gestion-des-entrees-sorties/3423_un-simple-bouton/

f4bjh, 2021-02-24:
fiche toujours ouverte

f4bjh, 2021-03-04:
ouais...alors, suite à https://github.com/f8kgl/swr_power_meter/commit/567f0b1e64702b783ecd7e1ad86ce732493772fb, les specs des boutons devient incorrectes. Je reprends la main sur cette fiche pour corriger, et clarifier tout ça

f4bjh, 2021-03-04:
spec mise à jour.

voir p17 et 18 §3.9.2 :
-supprimer les boutons de calibration
-ajout d'un filtre anti-rebond et pull up sur le bouton bande
Attention, rappel : le bouton bande doit être déporté en façade

f4bjh, 2021-03-05:
OK. Vu

Closed 2021-03-08.

Thread 275 (2020-05-28):

le clignotement n'est pas "très joli"

f4bjh, 2020-05-28:
Dans le menu calibration, le port doit clignoter en fonction de la config du module [CALC]

En réalité, "Ca saute", plus que ça ne clignote...voir comment on peut faire pour avoir un clignotement plus net et surtout plus régulier

Closed 2020-06-09.

Thread 278 (2020-05-29):

dans le menu mesure, rajouter une commande d'écriture de Rdac si G varie

f4bjh, 2020-05-29:
dans les psecs puis à implémenter

f4bjh, 2020-06-05:
bah...pourquoi "si G varie" ?

la valeur de Rdac est récupérée au travers d'une lecture en EEP, et nous ne sommes pas limités par le nombre de lecture (le nombre d'écriture oui : 1,000,000)

De plus, ça supposerait de sortir "tout" un arsenal de détection de variation de G...

pas de très bon aloi ==> ne sera pas résolu

Closed 2020-06-09.

Thread 279 (2020-05-29):

implémenter une machine d'état pour le menu calibration

f4bjh, 2020-05-29:
suite à #256 et #258

bloque :
#277
#256
#268
#269
#270
#271
#272
#273
#258

f4bjh, 2020-05-30:
ouais...peut-être pas quand même une espèce de machine d'état généralisé...

mais juste une qui soit dédiée au cas du menu de calibration (sinon, ça va encore être une usine à gaz...et un vrai nid à bugs...)

f4bjh, 2020-05-30:
bon...ben y a plus qu'à passer à la généralisation dans la machine d'état (c'est à dire entre autres passer les chaines de caractères en paramètres (voir les commmentaires de f_lcd_toggle_fwd_port))

il faudra aussi sans doute créer des fonctions du style f_bp_test_bouton_bande, et idem pour la clibration
et les utiliser dans la partie mesure

f4bjh, 2020-05-30:
il y a comme un reset généralisé de l'écran juste après être entrer dans la machine d'état...

???

f4bjh, 2020-05-31:
on sort du menu calibration mais le lcd reste bloqué

f4bjh, 2020-06-02:
reste à faire sur ce sujet là :

-gérer le cas où G>4 et G<0
-conversion en décimale de G avant affichage
-intégrer le DAC à la FSM
-MAJ Spec
-correction de la mesure en fonction de G (voir spec, car c'est spécifié)
-test et mesure de validation avec 2 (ou 3 ?) valeurs de la résistance "End to End"
=>ajouter un menu de lecture de la résistance "End to End" ?

f4bjh, 2020-06-03:
reste à faire sur ce sujet là :
-intégrer le DAC à la FSM
-correction de la mesure en fonction de G (voir spec, car c'est spécifié)
-test et mesure de validation avec 2 (ou 3 ?) valeurs de la résistance "End to End"
=>ajouter un menu de lecture de la résistance "End to End" ?

Closed 2020-06-09.

Thread 281 (2020-06-04):

Dans GPSIM, la valeur de TMR0 n'est pas correct si on ne fait pas du pas à pas

f4bjh, 2020-06-04:
En pas à pas
**gpsim> dump e
00 01 02 03 04 05 06 07 08 09 0a 0b 0c 0d 0e 0f
0000: 56 30 2e 38 00 28 00 00 00 00 00 00 00 00 00 00 V0.8.(..........
0010: 10 54 45 53 56 30 2e 38 20 1c 00 ff ff ff ff ff .TESV0.8 .......
0020: 40 0b ff ff ff ff ff ff 00 00 00 00 00 00 00 00 @..............

Sans breakpoint (execution totale du code jusqu'au menu mesure) :
00 01 02 03 04 05 06 07 08 09 0a 0b 0c 0d 0e 0f
0000: 56 30 2e 38 00 28 00 00 00 00 00 00 00 00 00 00 V0.8.(..........
0010: 10 54 45 53 56 30 2e 38 20 1c 00 ff ff ff ff ff .TESV0.8 .......
0020: 40 fa ff ff ff ff ff ff 00 00 00 00 00 00 00 00 @...............

c'est à dire que sans breakpoint, TMR0L = 0!!!

f4bjh, 2020-06-05:
faire un petit fw de test dans une branche parallèle, et poser la question à la miling list de gpsim

f4bjh, 2020-06-05:
#209

f4bjh, 2020-06-05:
il y a des tests de non regression visiblement :

gpsim-0.31.0/regression/tmr0_16bit/tmr0_16bit.asm

Closed 2020-06-09.

Thread 282 (2020-06-05):

Gérer l'octet de poids fort de Rdac dans la FSM

f4bjh, 2020-06-05:
plutôt que postinc, voir s'il n'est pas préférble d'utiliser un espèce de postDEC...

car après incrément du pointeur, le pointeur se retrouverait alors sur l'octet de poifs fort, et il suffirait de tester la retenue pour incrémenter le poids fort de 1. A priori, le poids faible retournerait directement à 0

Pour n, pas de problème a priori, car il est limité à 4 max.

Closed 2020-06-09.

Thread 284 (2020-06-08):

faire évoluer la table de Rdac

f4bjh, 2020-06-08:
suite à https://github.com/f8kgl/swr_power_meter/commit/069b6f07307f5200ad927d214aa212e5a19466e0

dans ce commit, seule la valeur pour G=1 est bonne

f4bjh, 2020-06-08:
bloque #257

Closed 2020-06-09.

Thread 292 (2020-06-16):

cablage verification et question

F0EOS, 2020-06-16:
Verifier R3
Cablage U5 fait
Verifier borne 10 de U7

condensateur c27 et c28 non raccordé , c'etait  les capa de filtrage de U8 qui est maintenant alimenter via U7

c'est un peu contradictoire avec  les explications que tu m'a donne concernant les alimentation de chaque composants
Du coup je ne comprends plus vraiment

f4bjh, 2020-06-17:
R3 => OK
U5 => OK
Borne 10 de U7 => OK

Pour répondre à ta question :
C16, C17 découple U7
C27, C28 découple U8
C21, C22 découple U6

D'accord ?

Closed 2020-06-18.

Thread 293 (2021-02-12):

Faire un cahier de recette de validation de la solution HW/SW

f4bjh, 2021-02-12:

f4bjh, 2021-02-18:
ajouter un test de Mesure du niveau de bruit à l’entrée de l’ADC

f4bjh, 2021-02-18:
https://projetsdiy.fr/activer-bus-i2c-raspberry-pi-3-pi-zero-w/

f4bjh, 2021-02-19:
ajout d'un test de relevé de log + calibration du timer (relevé de log au démarrage)

f4bjh, 2021-04-01:
#360

Closed 2021-04-05.

Thread 295 (2021-02-12):

Faire les tests de validation

f4bjh, 2021-02-12:
Sur le proto (V0.8)
Faire les tests de validation dans l'ordre suivant :

1/Monter U1, U2, le LCD
-2.2.1-f1
-2.2.1-i1
-2.2.2-i1
2/Monter U5
-2.2.2.3-f1
-2.2.2.3-i1
-2.2.2.3-p1

3/Monter U6 et U3
-2.2.2.2-f1

4/Enlever R5 et R6. Monter U4 et U7
-2.2.2.2-f2
-2.2.2.2-f3
-2.2.2.2-i1

4/Monter U8
-2.2.2.5-f1
-2.2.2-f1
-2.2.2-f2
-2.2.2.5-i1

2.2.2-p1
2.2.2-p2
2.2.1-p1

5/Monter D2, et D3
-2.2.2.1-f1
-2.2.2.1-i2

f4bjh, 2021-02-15:
dans la procédure de test, après avoir vérifier la bonne qualité, et les bonnes perf sur les mesures de tensions calibrées (adc et aop seuls, puis couplés), ajouter le test suivant :

relevé de la courbe de plusieurs diodes => permettra de spécifier le fw de calibration (et opérationnel) => V1.0

plus ajout de #310

f4bjh, 2021-02-15:
l'avantage de cette méthode, permet d'être agnostique vis à vis de la vraie relation P=f(V)

C'est dans le calibrateur, qu'il faudra que le relation soit bonne.
Si on part de l'hypothèse que le relation est du style P = K * V^a, par exemple,  on peut essayer de l'implémenter dans le calibrateur. est la tester dans le fw de test.
Indépandemment des developpements du fw de calibration, et opérationnel.

f4bjh, 2021-02-17:
ajouter des tests sw
ajouter une partie de validation du fw de calibration et opérationnel tout de même

f4bjh, 2021-04-05:
doublon avec #296

Closed 2021-04-05.

Thread 296 (2021-02-12):

Test de validation du fw de simulation

f4bjh, 2021-02-12:
-les boutons
-mesure de tension basique
-mesure de tension calibrée
-relevé I2C ADC et AOP

f4bjh, 2021-02-19:
reste à faire (en simulation) :
relevé de log
contrôler la calibration du timer

f4bjh, 2021-04-05:
fait doublon avec #360 maintenant.

Cette fiche recevra le rapport de test du coup

f4bjh, 2022-02-07:
à spécifier dans la doc SWR_POWER_METER_Tests
quelques pécisions à apporter sans doute dans la spec générale

puis implémenter les tests

Thread 299 (2021-02-12):

déplacer capa de découplage

f4bjh, 2021-02-12:
pour des raisons de clareté fonctionnelle des capa (à savoir, quelles capa découple quelle pin d'alim de quel composant)

même si ça semble quand même assez évident. De plus, facilitera le travail du routeur au moment du placement des composants

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

f4bjh, 2021-02-12:
#289

f4bjh, 2021-02-18:
euhhh...je vois pas les différences avec la version précédente...

f4bjh, 2021-02-24:
fiche toujours ouverte

Closed 2021-03-08.

Thread 300 (2021-02-12):

peut-on remplacer U2 par un CMS équivalent

f4bjh, 2021-02-12:
ce serait quand même plus simple, même si ce n'est pas nous qui allons câbler/détourer les vias...

attention à trouve un équivalent comptaible fonctionnellement (c'est à dire en terme d'intensité max disponible en sortie). Un 3A max devrait suffire.

f4bjh, 2021-02-12:
#289

f4bjh, 2021-02-15:
J'ai trouvé un régulateur qui me plait bien :-)

C'est le TPS70950DBVT

J'ai mis la doc dans src/hw/doc

f4bjh, 2021-02-15:
et je viens de l'ajouter aux specs page 33

f4bjh, 2021-02-22:
euh...j'ai comme un doute :  sur le schéma, je vois que tu as mis un : "TPS7A0522PDBV".

Et moi, je voudrais un : "TPS70950DBVT". C'est la même chose ou pas ?

f4bjh, 2021-02-22:
référence à https://github.com/f8kgl/swr_power_meter/commit/2b46d55584744f9b92d55da22f7504fea116a10b erronée

f4bjh, 2021-02-22:
rajouter une petite diode anti-retour sur le + d'alim, en entrée du régulateur, et ça devrait être bon

f4bjh, 2021-02-23:
ok pour la modif de régulateur. On peut supprimer le L7805.

Je fermerai cette fiche après suppression de l'ancien régulateur

Closed 2021-03-08.

Thread 301 (2021-02-12):

commentaires autour de R6 et R5

f4bjh, 2021-02-12:
ajouter un petit texte précisant la nature et la fonction de R5 et R6 au schéma

f4bjh, 2021-02-12:
#289

f4bjh, 2021-02-16:
R5 et R6 vaut 510 ohms, (pas 625)

f4bjh, 2021-02-16:
erreur :

R1 et R4 valent 510 ohms (pas 625)

f4bjh, 2021-02-17:
Dernier commentaire ci-dessus est FAUX

R1 et R4 valent bien 625 ohms (suite au commit https://github.com/f8kgl/swr_power_meter/commit/b9fa61e8de0cca5990cc2979cff7abadbf15d2a1)

f4bjh, 2021-02-17:
dans cette fiche, il faut juste ajouter un petit texte, autour de R5 et R6 : "résistance test ADC1"

Closed 2021-02-18.

Thread 302 (2021-02-12):

ajouter un pont diviseur de tension

f4bjh, 2021-02-12:
ajouter au schéma un pont diviseur de tension, voir spec p23 et 28

f4bjh, 2021-02-12:
#289

f4bjh, 2021-02-24:
cette fiche est toujours ouverte

voir p19

MonFrancoue, 2021-03-02:
j'ai refais une modif en lisant la compensation en temperature je pense que
le pont ressemble plus a ce qu il faut

Le mer. 24 févr. 2021 à 19:42, Fabrice DECROP LONGET <
notifications@github.com> a écrit :

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

f4bjh, 2021-03-04:
voir p15 des specs pour le pont diviseur côté ADC

f4bjh, 2021-03-05:
Je pense qu'il manque le pont divisuer côté ADC : 16 §3.8.2

f4bjh, 2021-03-05:
#289

Closed 2021-04-04.

Thread 305 (2021-02-12):

Faire le routage

f4bjh, 2021-02-12:

f4bjh, 2021-04-01:
ouais, c'est pas mal, y'a de l'idée...

tout de suite, il faut corriger 2 habitudes, avant qu'elles ne gangrènes tout le circuit :

1-faire des pistes plus large, qui grosso modo recouvrent 2/3 d'un pad CMS de composant 1206

2-éviter de faire des losanges comme celui là :
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

3-faire des pistes droites
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

4-les vias sont de diamètre trop petits (et raccourcir au maximum la ligne qui la relie à un composant)
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

f4bjh, 2021-04-01:
pour les largeurs de piste, évidemment que pour relier U4, il faudra changer la largeur de piste en plein milieu de la route...

f4bjh, 2021-04-01:
rajouter des vias de masse autour de U4 (un seul c'est pas suffisant)

f4bjh, 2021-04-02:
oui, les largeurs de piste me conviennent davantage !!! C'est parfait !!!

f4bjh, 2021-04-11:
Dans l'état actuel, c'est déjà pas mal.

J'ai vu 2 ou 3 petites choses qui me chagrinent :

-C13, C14 et R7 : il y a un + d'alim qui doit arriver d'après le schéma. Or, ce n'est pas le cas sur le routage. Il manque une piste d'alim
-essayer d'aligner avec J4 + il manque une piste
-rapprocher C15 de R16
-touner C7 et C10 de 90° + ramener au + d'alim + rapprocher ces capas de U4

f4bjh, 2021-04-11:
-rapprocher C18 de R17

f4bjh, 2021-04-11:
-et après avoir rapproché C18 auprès de R17, faire remonter tout le bloc (R16, C15, R19, R21)vers le haut, quitte à déplacer C13, C14 (et les tourner de 90°)

f4bjh, 2021-04-18:
ne manque t'il pas u fil entre U3 et R16 ?

Thread 306 (2021-02-15):

Connecteur(s) de programmation

f4bjh, 2021-02-15:
Spécifier le connecteur de programmation

Impact à prévoir sur le schéma :
séparer le connecteur LCD du connecteur de programmation
Il y a 2 composants à programmer : l'EEP (bus I2C) et le PIC
les 2 seront programmés au travers d'un Raspberry

f4bjh, 2021-03-04:
voir §3.3

f4bjh, 2021-03-05:
OK. Vu

Je reprends la main, et je modifie les specs pour simplifier le schéma, et le routage.
En plus, je pense qu'il y a bug sur le bus de programmation, si l'OM utilise un programmateur type ICD3, plutôt que ICD2...

f4bjh, 2021-03-05:
#188

Closed 2021-03-08.

Thread 307 (2021-02-15):

Boutons poussoirs

f4bjh, 2021-02-15:
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
 J'ai un doute sur les boutons poussoirs que tu as choisis :

-ceux sont bien des boutons poussoirs, ou bien des interrupteurs ?
-parce qu'il nous faut des boutons poussoirs. De plus, ces boutons ont vocation à être déportés en facade ensuite (pour la clibration, et le choix de la bande et du calibre en utilisation normale par la suite...)

§4.3 des specs

Closed 2021-03-08.

Thread 308 (2021-02-15):

Pack pile / Alim 13,8V

f4bjh, 2021-02-15:
Se pose aussi la question de "la double alim"

C'est à dire : alimentation par pack pile ou alim externe 13,8V

Dans les specs, pour le moment, le tosmètre doit pouvoir être alimenté par l'un ou l'autre des solutions.

Mais, évidemment, l'électronique ne peut pas fonctionner sur les 2 en même temps.
Comment peut-on faire la priorité ?

§4.3 des specs

f4bjh, 2021-02-17:
mettre un interrupteur général
fonctionnalité de double alim : prévoir un pack pile (4x1,5V LR6) et en façade, un jack d'alim 12V qui priorise le 12V

f4bjh, 2021-02-17:
#315

f4bjh, 2021-02-17:
et plutôt qu'un interrupteur général, mettre l'interrupteur en série que sur la pile

de telle sorte que,l'OM qui branche l'alim, fait démarrer immédiatement le dispositif. Le jack priorise l'alim 12V dans tous les cas.

f4bjh, 2021-02-19:
suite à https://github.com/f8kgl/swr_power_meter/commit/cea18d6974b1bf108f77acca47d0066fb4397d51

je pense qu'il manque l'interrupteur, en série avec la pile

f4bjh, 2021-02-23:
oubli de ma part : pour le pack pile, il faut utiliser un connecteur avec un détrompeur (histoire de ne pas pouvoir brancher le pack pile à l'envers...)

OK, il y a la diode...mais 2 protections valent mieux qu'une

f4bjh, 2021-02-24:
il faut revoir le connecteur du pack pile, et mettre un connecteur avec détrompeur

f4bjh, 2021-02-24:
Parfait !!!

Closed 2021-03-08.

Thread 310 (2021-02-15):

ajout d'un test de téléchargement d'une table de calibration

f4bjh, 2021-02-15:
ajouter un test de dl de cable de calibration (32ko !!!) à travers l'I2C

quitte à rajouter un espèce de contrôle de flux ou autre...

fw spécifique à prévoir

Closed 2021-02-18.

Thread 312 (2021-02-16):

Sensibilité de 37,5uV non atteinte en simulation

f4bjh, 2021-02-16:
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

f4bjh, 2021-02-16:
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

f4bjh, 2021-02-16:
#296

f4bjh, 2021-02-17:
Gmax = 4
donc sensibilité = 62,5uV

f4bjh, 2021-02-17:
en simulation :
G=4 : sensibilité = 59uV => menu mesure = 0x0001 / 1mV
G= 0 : sensibilité = 1mV => affichage = 0x0001 / 1mV

Pour G=4
Tension entrée ADC = 120uV => menu calcul = 62,5uV
Tension entrée ADC = 121uV => menu calcul = 125uV

f4bjh, 2021-02-17:
il y a eu un "certain" nombres de corrections faites quand même plus ou moins à l'arrache dans les modules ajoutés à gpsim...

typiquement, dans ltc2305.cc:95
j'ai appliqué un petit coefficient de correction pour pouvoir lire la bonne tension...
mais, visiblement, le coefficient n'est pas correct pour Vin = 59uV :
ltc2305.cc:158 voltage=2.049072 (0x0801)   //traces GPSIM avec flag de debug dans ltc2305.cc
alors, que dans les même conditions, en sortie de l'AD5175 (ie l'AOP), la tension est de 2.048944V (ce qui est correct)

il s'agit donc d'un big d'implémentation du ltc2305 dans gpsim (ou plus exactement, d'une erreur de calcul dans la tension d'entrée de l'ADC dans le composant ltc2305.cc de gpsim)

Closed 2021-02-18.

Thread 313 (2021-02-16):

documenter la génération "from scratch"

f4bjh, 2021-02-16:
mise en oeuvre de l'environnement

génération fw de test, calibration, opérationnel
génération de la table de calibration de test
génération du calibrateur

==> plutôt dans la doc d'implémentatipn a priori

f4bjh, 2021-02-16:
#296

Closed 2021-02-18.

Thread 315 (2021-02-17):

spécifier la dble alim pack pile/12V

f4bjh, 2021-02-17:

f4bjh, 2021-02-22:
on est d'accord, qu'en branchant un connecteur dans le jack, ça déconnecte bien la pile ?

f4bjh, 2021-02-23:
allons, allons...regarde ce que tu as fait avec D5 !!!

f4bjh, 2021-03-04:
suite à https://github.com/f8kgl/swr_power_meter/commit/7e4581cc573c57fecb6890ad80a74715ba71bfb6

d'après moi, le connecteur que t'as mis au schéma correspond à 100% à ce que l'on veut faire :
https://www.cuidevices.com/blog/understanding-audio-jack-switches-and-schematics

J'en ai trouvé chez Farnell : voir /src/hw/doc/3107863.pdf

et sous Kicad, voici ce qu'il y a en librairie : https://kicad.github.io/footprints/Connector_BarrelJack

MAIS ATTENTION : ce connecteur sera déporté en façade (avant, ou arrière, je sais pas), mais il sera déporté du circuit imprimé !!!

f4bjh, 2021-03-04:
spécifié en p11 §3.3

f4bjh, 2021-03-04:
suite à 7e4581c

d'après moi, le connecteur que t'as mis au schéma correspond à 100% à ce que l'on veut faire :
https://www.cuidevices.com/blog/understanding-audio-jack-switches-and-schematics

J'en ai trouvé chez Farnell : voir /src/hw/doc/3107863.pdf

et sous Kicad, voici ce qu'il y a en librairie : https://kicad.github.io/footprints/Connector_BarrelJack

MAIS ATTENTION : ce connecteur sera déporté en façade (avant, ou arrière, je sais pas), mais il sera déporté du circuit imprimé !!!

spécifié en p11 §3.3

f4bjh, 2021-03-04:
c'est toujours pas clair

f4bjh, 2021-03-04:
OK.

Alors, j'ai simplifié et clairifié les spec : §3.3 et §3.4 en page 11

f4bjh, 2021-03-05:
#289

Closed 2021-03-08.

Thread 316 (2021-02-17):

Vérifier empreinte de U8

f4bjh, 2021-02-17:
#289

f4bjh, 2021-02-17:
J'ai regardé l'empreinte, et d'après moi c'est bien une TSSOP8

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

f4bjh, 2021-02-17:
@F0EOS : Où vois-tu qu'il s'agit d'un MSOP ?

f4bjh, 2021-02-17:
Il faut prendre le TSSOP 4.4mm (c'est le seul qui existe au format TSSOP)

Closed 2021-03-08.

Thread 317 (2021-02-17):

Que représente la tension affichée dans le menu "mesure" ?

f4bjh, 2021-02-17:
Il faudrait afficher la tension brute entrée de l'ADC

f4bjh, 2021-02-17:
#296

f4bjh, 2021-02-17:
il s'agit bien de la tension brute, en entrée de l'ADC

ce n'est pas un bug

Closed 2021-02-18.

Thread 318 (2021-02-17):

Petite erreur au schéma

f4bjh, 2021-02-17:
Voici une fiche pour commencer avec github, Kicad, etc...
Il y a une petite bourde au schéma : il y a un fil en l'air sur le fil de donnée du bus I2C

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

Il faut connecter ces 2 petits fils en l'air :-)

bloquant pour #289

MonFrancoue, 2021-02-20:
le fil est reconnecte
j espere maintenant que le fichier est mis a jour

f4bjh, 2021-02-22:
aïe...je te confirme ce que l'on se disait avec André : à ce jour, pas vu, ni reçu de mise à jour du schéma pour cette fiche :-p

MonFrancoue, 2021-02-22:
Bonsoir Fabrice

Il semble que ce soit une histoire de droit insuffisant pour livrer les
modifications

Le lun. 22 févr. 2021 à 13:19, Fabrice DECROP LONGET <
notifications@github.com> a écrit :

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

f4bjh, 2021-02-23:
C'est bon, ça passe. Je passe cette fiche en "terminé"

Closed 2021-03-08.

Thread 320 (2021-02-18):

grosse boulette au schéma

f4bjh, 2021-02-18:
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

voir spec p27

bloquant pour #289

f4bjh, 2021-02-18:
il s'agit d'abord d'une erreur de doc (et pan...sur la tête à BJH)

f4bjh, 2021-02-18:
il faut connecter GND(1) du ltc2305 directement à la masse au schéma
voir p27 des specs (commit https://github.com/f8kgl/swr_power_meter/commit/bbd855d54c7d0c9dc7f3868afb2f3cd5ba730828)

Closed 2021-03-08.

Thread 321 (2021-02-18):

tension d'alim ADC = 4,096V ou 5V ???

f4bjh, 2021-02-18:
peut influencer directement la précision de la mesure, car la résolution de l'ADC est liée à la tension d'alim.

Voir pour Vref...

f4bjh, 2021-02-18:
#296

f4bjh, 2021-02-23:
ou bien forcer à 5V, et la résolution devient 1,22mV (cf p14/24 de l'étude)

quelles conséquences sur la précsion de la mesure ?

f4bjh, 2021-02-24:
non. On garde le 5V, et on verra bien sur la version d'étude.

f4bjh, 2021-02-27:
bah...il y quand même un problème...parce que ça joue directement sur la précision de la mesure...

#328

Closed 2021-03-08.

Thread 324 (2021-02-22):

Supprimer U4 et U7

f4bjh, 2021-02-22:

f4bjh, 2021-02-22:
#296

f4bjh, 2021-02-24:
non. garder U4 et U7 pour la version d'étude

f4bjh, 2021-03-02:
suite à https://github.com/f8kgl/swr_power_meter/commit/1ac0ee63d315aa80a2e10f9446c0617f983e4b4b

supprimer U4 et U7

f4bjh, 2021-03-02:
voir §3.7 des specs

f4bjh, 2021-03-02:
il y a un petit peu de nettoyage à faire du coup :
C16, C17, C6, C11

f4bjh, 2021-03-02:
supprimer C16, C17, C6, C11

Closed 2021-03-08.

Thread 325 (2021-02-22):

Erreurs lors des tests électrique

f4bjh, 2021-02-22:
Rapport d'erreur (22/02/2021 15:41:04, Encodage UTF8 )

***** Feuille /
ErrType(3): Pin connectée à d'autres pins, mais aucune pin pour la piloter
    @(248,92 mm, 193,04 mm): Pin 8 (Power input) du composant U7 non pilotée (Net 1).
ErrType(3): Pin connectée à d'autres pins, mais aucune pin pour la piloter
    @(260,35 mm, 59,69 mm): Pin 1 (Power input) du composant #PWR0125 non pilotée (Net 3).
ErrType(3): Pin connectée à d'autres pins, mais aucune pin pour la piloter
    @(227,33 mm, 139,70 mm): Pin 7 (Power input) du composant U5 non pilotée (Net 6).
ErrType(2): Pin non connectée (utiliser un marqueur de "non connexion" pour supprimer cette erreur)
    @(53,34 mm, 257,81 mm): La pin 3 (Passive) du composant J4 est non connectée.
ErrType(3): Pin connectée à d'autres pins, mais aucune pin pour la piloter
    @(97,54 mm, 260,35 mm): Pin 1 (Power input) du composant U9 non pilotée (Net 12).
ErrType(2): Pin non connectée (utiliser un marqueur de "non connexion" pour supprimer cette erreur)
    @(97,54 mm, 262,89 mm): La pin 3 (Entrée) du composant U9 est non connectée.
ErrType(2): Pin non connectée (utiliser un marqueur de "non connexion" pour supprimer cette erreur)
    @(84,33 mm, 251,46 mm): La pin 2 (Passive) du composant SW3 est non connectée.
ErrType(2): Pin non connectée (utiliser un marqueur de "non connexion" pour supprimer cette erreur)
    @(137,16 mm, 165,10 mm): La pin 4 (Bidirectionnel) du composant U1 est non connectée.
ErrType(12): Net différent assigné à une pin partagée d'une autre unité du même composant
    @(238,76 mm, 110,49 mm): Pin 9 de U4 est  connectée à la fois à GNDREF et Net-(R8-Pad1)
ErrType(12): Net différent assigné à une pin partagée d'une autre unité du même composant
    @(246,38 mm, 193,04 mm): Pin 9 de U7 est  connectée à la fois à GNDREF et Net-(R8-Pad1)
ErrType(3): Pin connectée à d'autres pins, mais aucune pin pour la piloter
    @(236,22 mm, 110,49 mm): Pin 8 (Power input) du composant U4 non pilotée (Net 27).
ErrType(3): Pin connectée à d'autres pins, mais aucune pin pour la piloter
    @(74,93 mm, 215,90 mm): Pin 1 (Power input) du composant U2 non pilotée (Net 29).
ErrType(3): Pin connectée à d'autres pins, mais aucune pin pour la piloter
    @(243,84 mm, 52,07 mm): Pin 1 (Power input) du composant U3 non pilotée (Net 39).
ErrType(5): Problème de conflit entre pins. Sévérité: erreur
    @(279,40 mm, 191,77 mm): Pin 8 (Sortie) du composant U8  connectée à
    @(243,84 mm, 67,31 mm): pin 5 (Power output) du composant U3 (net 40).
ErrType(5): Problème de conflit entre pins. Sévérité: erreur
    @(243,84 mm, 67,31 mm): Pin 5 (Power output) du composant U3  connectée à
    @(241,30 mm, 233,68 mm): pin 5 (Power output) du composant U6 (net 40).
ErrType(5): Problème de conflit entre pins. Sévérité: erreur
    @(241,30 mm, 233,68 mm): Pin 5 (Power output) du composant U6  connectée à
    @(112,78 mm, 260,35 mm): pin 5 (Power output) du composant U9 (net 40).
ErrType(5): Problème de conflit entre pins. Sévérité: erreur
    @(112,78 mm, 260,35 mm): Pin 5 (Power output) du composant U9  connectée à
    @(90,17 mm, 215,90 mm): pin 3 (Power output) du composant U2 (net 40).

** messages ERC: 17  Erreurs 6  Avertissements 11

Thread 326 (2021-02-23):

redéfinition des versions

f4bjh, 2021-02-23:
phase d'étude = V0.n
phase proto = V1.n
phase prod = V2.n

définir les sorties attendues
définir les phases
étude = version de carte avec pot digital + compensation en température + régulateur 4,096V

le proto = etude moins tout ce qui ne sert à rien + archi revue à la lecture des tests effectuées en phase d'étude
spec calibration et mesure après phase étude

tout cela sera à valider par les contributeurs

f4bjh, 2021-02-23:
#324
#321
#327

f4bjh, 2021-02-23:
suite à https://github.com/f8kgl/swr_power_meter/commit/04a0a23672eb4e96bfeb74a9743f708a4fc25c30

Je vous invite à lire la version courante des spécifications, et plus particulièrement la page 5/46, qui contient une information importante sur les versions.

J'aimerais savoir ce que vous en pensez ? Est-ce que cela vous convient ?

f4bjh, 2021-02-23:
#302

f4bjh, 2021-02-24:
et j'ajoute qu'en plus de la page 5/46 des specs, voudriez-vous bien attentivement relire la page 3/25 du document d'étude, et me dire si cela vous convient ?

Merci d'avance :-p

f4bjh, 2021-02-24:
après les tess sur la version d'étude, on essaiera de monter une manip, permettant de modifier le hw pour se rapprocher le plus possible d'une version prototype. Et refaire des tests pour voir si ce "simili-prototype" est fonctionnel

En tout, il faut donc prévoir 3 runs de cartes :

-run d'étude : fondée sur la v0.8 du projet. Petite série (quantité = 5 max). Passera tous les tests d'étude. Tentative de monter un "simili-proto" pour test type v1.n
-run proto : fondée sur la v1.n du projet. Petite série (quantité = 5 max).Passera tous les tests de calibration et mesure de puissance
-run production : fondée sur la V2.n du projet. Grande série.

f4bjh, 2021-02-24:
vu avec F8BUZ et F0EOS : OK

Closed 2021-03-08.

Thread 328 (2021-02-24):

Etude

f4bjh, 2021-02-24:
-bruit
-division en PIC assembleur
-durée de conversion + instant de conversion minimale nécessaire

dans le § performances, ajout d'unn schéma bloc avec les formules entrées/sorties

f4bjh, 2021-02-24:
https://indico.cern.ch/event/69321/contributions/2069683/attachments/1028720/1464832/Caspers-Meas-1.pdf

f4bjh, 2021-02-24:
la partie calcul de la sensi se fera dans le § sur les perfs

ajout de la compensation de T° à faire, et continuer d'explorer la doc hp

f4bjh, 2021-02-24:
https://www.keysight.com/upload/cmc_upload/All/DetectorOverview.pdf
https://www.everythingrf.com/community/what-is-tss-tangential-signal-sensitivity
https://olli.vanhoja.net/static/d009.pdf
https://www.rf-microwave.com/app/resources/uploads/diodes/a_temperature_compensated_linear_diode_detector.pdf
https://en.wikipedia.org/wiki/Minimum_detectable_signal

Closed 2022-02-07.

Thread 329 (2021-02-24):

Monter un "simili-proto" fondé sur la version d'étude

f4bjh, 2021-02-24:
suite à https://github.com/f8kgl/swr_power_meter/commit/b3bfa66f69ade30f163ac4c574669ed70579e355

avant de lancer la fabrication, poser un tag sur la V0.8, et passer en V0.9

à l'issue des tests sur la version d'étude, modifier "à la main" le hw sur carte, pour tenter de monter une manip qui permette d'avoir un simili-proto

Closed 2021-03-08.

Thread 331 (2021-02-24):

abandon de la calibration par EEPROM

f4bjh, 2021-02-24:
suite à https://github.com/f8kgl/swr_power_meter/commit/28770fdddc43971487e1c666e0e350f457b58c1c

dans les specs, puis au schéma : supprimer U8

f4bjh, 2021-02-24:
#188

f4bjh, 2021-02-24:
et spécifier les algo math
voir les apsects temps réels !!!

https://www.microchip.com/forums/m111755.aspx

f4bjh, 2021-02-25:
#289 #296

f4bjh, 2021-02-25:
reste à étudier puis spécifier les algo (multiplicaion et division) dans le code
et à le coder

Closed 2021-03-08.

Thread 332 (2021-02-25):

Valeur typique de la sensibilité en circuit ouvert incohérente

f4bjh, 2021-02-25:
suite à https://github.com/f8kgl/swr_power_meter/commit/2da966826effdb1379723ea968a4ff9fffdb7f5d

La valeur de K dans § 3.1.1.3 de l'étude ne correspond pas du tout à la valeur typique trouvée par HP (qui est plutôt aux alentours de 500uV/uW)

Pourquoi ?

#328

Closed 2021-03-08.

Thread 333 (2021-02-25):

ajout d'une petite adaptation en entrée du détecteur

f4bjh, 2021-02-25:
suite à https://github.com/f8kgl/swr_power_meter/commit/82204466fcf7913e579e31ce3b7fcdb80a409539

f4bjh, 2021-02-25:
spec puis schéma

f4bjh, 2021-02-25:
#289

f4bjh, 2021-02-25:
#188

f4bjh, 2021-02-25:
ajouter un circuit d'adaptation d'impédance au schéma (voir p13 et 14 des specs)

f4bjh, 2021-03-04:
OK.

En fait, les spécifications ne sont vraisemblablement pas assez claires et précises. Je fais une répide corretion pour clarifier tout cela.

f4bjh, 2021-03-04:
ah y est. Je pense que les specs sont plus clair. voir p12 et 13 §3.6.2

Merci de livrer sur les 3 numéros de fiche en même temps : #333 #302  #327

f4bjh, 2021-03-05:
euhhh...je vois pas la petite adaptation en entrée du détecteur. Il n'y a qu'une résistance en //. Il faut mettre un circuit en Pi : voir p13 §3.6.2 (Z1, Z2, Z3)

D'après moi, au schéma il n'y a que Z3

f4bjh, 2021-03-05:
#289

f4bjh, 2021-03-06:
C'est parfait !!!

Closed 2021-03-08.

Thread 334 (2021-02-25):

supprimer U8

f4bjh, 2021-02-25:
suite à https://github.com/f8kgl/swr_power_meter/commit/e914692e678b05e6d7258ca977febf84a28a309a

supprimer U8 du schéma

f4bjh, 2021-02-25:
#289

MonFrancoue, 2021-03-02:
Bonjour Fabrice,

Avant de faire une betise je te demande pour etre sur ,Tu veux que l'on
supprime la mémoire  c'est bien cela ?

Le jeu. 25 févr. 2021 à 23:58, Fabrice DECROP LONGET <
notifications@github.com> a écrit :

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

f4bjh, 2021-03-02:
Absolument, oui !!!

f4bjh, 2021-03-02:
ok. Vu.

Closed 2021-03-08.

Thread 337 (2021-02-27):

test des logs dans le fw de simulation

f4bjh, 2021-02-27:
#296

f4bjh, 2021-03-12:
l'octet d'acrtivation en EEP ne fonctionne pas visiblement (on peut mettre 0x00 ou 0x41...ça n'a strictement aucun effet sur le niveau de trace effectivement écrit en EEP)

f4bjh, 2021-03-16:
test ajouté au cahier de recette

Closed 2021-03-16.

Thread 340 (2021-02-27):

conclusions de l'étude

f4bjh, 2021-02-27:
1-Rappeler les quelques principes de réglages décrits dans les § précédents
Par apport à une problématique possible (par ex, manque de sensiilbité), quelles sont les marges de manœuvre (ça peut être Rv, Rl, C du détecteur, manque de gain, etc...)

2-Décrire également l’ajout dess ponts de résistnaces pour les tests ie :
En 1er test ADC en jectant une tension en entrée de l’ADC sans AOP
Idem avec AOP

3-Dans la conclusion,s donner des pistes pour choisir les composants.
Ex : pour la diode, les perfs sont liés à Is et n par ex. Rappeler les « bonnes de Is et n » pour choisir le composant (ne pas oublier, Rl, et Rv par la même occasion)
Dessins d’archi général

#328

Closed 2022-02-07.

Thread 341 (2021-02-27):

étude des perf

f4bjh, 2021-02-27:
faire le budget de la chaine et d’en déduire tous les paramètres de perfromance de manière un peu théorique

ne pas oublier la notion de niveau de bruit

#328

f4bjh, 2022-02-07:
repoussé en V1.0 lors des tests de montage

Thread 342 (2021-03-02):

suppression du potentiomètre digitale

f4bjh, 2021-03-02:
dans les specs (avec évolutin du menu calibration du fw de test)
puis la simu
puis le code

#188
#331

f4bjh, 2021-03-02:
dans l'état actuel du code, le LCD affiche 2000mV fixe, quelque soit la tension d'entrée
de plus, il y a encore 2 fils (initialement le bus I2C) sur les composants lt1818 sous gpsim

Closed 2021-03-08.

Thread 343 (2021-03-02):

modif AOP

f4bjh, 2021-03-02:
suite à https://github.com/f8kgl/swr_power_meter/commit/1ac0ee63d315aa80a2e10f9446c0617f983e4b4b

le montage des AOP est différents (d'un montage non inverseur, on passe à un montage en inverseur)

voir §3.7

f4bjh, 2021-03-02:
voir §3.7 des specs

f4bjh, 2021-03-02:
attention, je pense qu'il y a une erreur de U6 : la sortie out (patte 1) est shuntée à la masse

f4bjh, 2021-03-03:
ok, c'est pas mal. Ca commence à avoir de la gueule :-)

alors, il y a les mêmes modifs à reporter sur U3 (c'est à dire ajout d'un pont de résistance + modif du schéma pour le passer en mode inverseur, plutôt que non inverseur)
ensuite R4=100 ohms, et R6 = 1000 ohms.
supprimer les textes "résistance de test"

attention, il y a un fil qui se croise entre U6 et le détecteur HF. Ca risque de poser un pb au routage. Revoir le placement de U6.

Toutes les modifs appliquées à U6 doivent être également appliquées sur U3 en mirroir

f4bjh, 2021-03-05:
#289

f4bjh, 2021-03-05:
OK. Vu

Closed 2021-03-08.

Thread 344 (2021-03-02):

documenter la calibration dans le fw de test

f4bjh, 2021-03-02:
dans a feuille excel :

1/mettre la valeur de K
2/Reporter Pin(W) et la valeur d'ADC dans les cases G17 et H17
3/contrôle de la valeur de n dans J17 (=2^n ?) -> ajuster R2 en conséquene
4/contrôle pour ADC = 54 (case N30)
5/contrôle du % d'erreur

f4bjh, 2021-03-03:
à spécifier à présent #188

Closed 2021-04-05.

Thread 346 (2021-03-02):

test gpsim du fw de test

f4bjh, 2021-03-02:
suite à https://github.com/f8kgl/swr_power_meter/commit/35b982543697a2e5df8911ae73a5b9bf3ae2a6fb
qui supprime l'AOP dans le code et la simu :

tests fonctionnelle minimale de remontée de tension sous gpsim à refaire #296

Closed 2021-03-08.

Thread 347 (2021-03-03):

calcul de la puissance en dBm

f4bjh, 2021-03-03:
§6.1.3.1 de l'étude

#328

f4bjh, 2021-03-03:
à spécifier #188

f4bjh, 2021-03-03:
aaarggghhh référence ci-dessus éronnée

f4bjh, 2021-03-03:
#348

f4bjh, 2021-03-05:
Revenir à l'étude, §6

Décrire la mesure en hexa
Décrire la mesure puis le calcul en mV
Décrire la mesure puis le calcul en dBm
Décrire la mesure puis le calcul en W
A reporter dans la conclusion (quelle mesure/calcul vs xWATT ou SWR POWER METER ?

Puis à reporter dans les specs, et y introduire d'ailleurs une différence xWATT vs SWR POWER METER (sous forme de flag, ça parait évident)

f4bjh, 2021-03-05:
#296

f4bjh, 2021-03-08:
#370

f4bjh, 2021-03-10:
préciser la taille des LUT
attention, j'ai cru voir une petite difficulté sur le calcul de x...à voir

puis à spécifier

f4bjh, 2021-03-10:
préciser la taille des LUT
attention, j'ai cru voir une petite difficulté sur le calcul de x...à voir

puis à spécifier

f4bjh, 2021-03-11:
euhhh...ouais...mais c'est loin d'être fini quand même...

f4bjh, 2021-03-18:
dans l'état actuel des choses, le calcul ne donne pas les résultats théoriques attendus (pour ADC=0x52, donne -33,3dBm...devrait donner -22,9)
Ensuite, faire varier Vfwd donne des résultats aléatoires (lié à #386 ?

un rapide examen du contenu de la RAM (v_calc_10logADC) semble montrer que pour ADC=0x52, 10logADC = 0xA2
Visiblement, déjà là...il y a qqc qui ne va pas

f4bjh, 2021-03-18:
il y a toujours un petit souci de répétabilité, si on fait varier Vfwd à la volée
mais par contre, faire x2 sur Vin, fait bien varier de 3dB la puissance

pour ADC=0x52, Pfwd = -25,6dBm...au lieu de -22,9

f4bjh, 2021-03-19:
Il faut faire 2 choses

Decrementer de 1 la valeur d'Adc avant de taper en flash...car on doit ignorer la valeur 0
Et ensuite, il faut sans doute multiplier la valeur d'adresse par 2. Les données sont elles alignées sur 8 ou 16 bits ?

Ensuite, il faudra checker les valeurs de R1 et R2, par rapport à la feuille de calibration sous excel.
Ne pas oublier de setter la valeur de kconv en dbm au démarrage (pour ça il fait absolument résoudre le bug de chargement en eeprom par le .stc)

f4bjh, 2021-03-19:
donne de bons résultats de mesure avec cette valeur de calibration (0x014A Kconv(dBm) = -33,0 dBm)

f4bjh, 2021-03-20:
restee plus qu'à ajouter la voie REF

f4bjh, 2021-03-31:
reste plus qu'à mettre la voie REF

f4bjh, 2021-03-31:
à tester...

attention, assez grosse modif, et il y a au moins 3 choses à vérifier :

-le passge sous IF 0 des bouts de code de f_calc_P_dBm (et donc le résultat en sortie sur _v_calc_bin_P_dBm sur la voie FWD déjà, pour commencer
-le résultat en sortie de f_calc_conv_dBm_to_ascii sur v_Pfwd_and_ref_dBm_ascii sur la voie FWD (mais pourquoi diantre, le 1er octet en ASCII était dans v_Pfwd_and_ref_dBm_ascii+1  ???)
-ensuite, le résultat en sortie de f_calc_P_dBm sur la voie REF, puis le processus de conversion pour le stockage dans v_Pfwd_and_ref_dBm+1 et +2), puis le passage dans la conversion ascii

f4bjh, 2021-04-01:
enlever les IF 0

f4bjh, 2021-04-01:
affichage de la voie REF toujours défaillant (mais voie FWD revenu à l'état normal)
+ enlever les IF 0

Closed 2021-04-04.

Thread 348 (2021-03-03):

mise en ouvre du menu "tension" et "puissance"

f4bjh, 2021-03-03:
suite à https://github.com/f8kgl/swr_power_meter/commit/35b982543697a2e5df8911ae73a5b9bf3ae2a6fb

f4bjh, 2021-03-03:
#349
#347

f4bjh, 2021-03-08:
#370

f4bjh, 2021-04-05:
si on s'attache juste au titre de cette fiche, dans l'état (https://github.com/f8kgl/swr_power_meter/commit/837ee307b97f63a6dba81d3194ab3d9e6f4ad4af), la fonctionnalité est développée.

Le pb de reproductibilité sera traité dans le cadre des tests
ensuite, le calcul de la puissance en W et le calcul de ADCfwd/ADCref a été repoussée en V1.0. Autrement dit cette fiche ne pourrait être traitée en V0.8, alors que cette fonctionnalité es essentielle (même au fw de test)
=> ne sera pas résolu

Closed 2021-04-05.

Thread 349 (2021-03-03):

compensation de l'offset d'AOP

f4bjh, 2021-03-03:
suite à https://github.com/f8kgl/swr_power_meter/commit/567f0b1e64702b783ecd7e1ad86ce732493772fb

p28 des specs

f4bjh, 2021-03-03:
aarrrgghhh référene ci-dessus éronée

Closed 2021-03-08.

Thread 352 (2021-03-04):

revenir sur la notion de "version d'étude"

f4bjh, 2021-03-04:
suite à l'introduction de la notion de Kconv(dBm), la notion de version d'étude pure n'a plus vraiment de sens, et la version initialement appelée prototype peut servir de version d'étude le cas échéant.

Closed 2021-03-08.

Thread 355 (2021-03-04):

les valeurs d'ADC restent bloquées. MAJ impossible

f4bjh, 2021-03-04:

f4bjh, 2021-03-04:
c'est un peu pénible à vrai dire : il n'est pas possible de faire un get dans la partie non i2c à la volée (du moins, je ne sais pas si c'est réellement possible...)

f4bjh, 2021-03-04:
#296

Closed 2021-03-08.

Thread 356 (2021-03-05):

Revoir le placement du détecteur HF

f4bjh, 2021-03-05:
Il y a un (assez gros) travail à faire autour du placement du détecteur HF et du LT1818

Je conseillerai de faire de la manière suivante :

1/déplacer le détecteur HF
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

2/Idem sur la voie REF
3/Rotation de 180° des détecteurs
4/rotation des LT1818 pour avoir des connections en directe

5/améliorer le +d'alim du pont diviseur : dans l'idée d'avoir une connexion plus courte, et surtout (surtout !!!) éviter les boucles d'alim au routage
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

La philosophie générale que je préconise est la suivante :
faire un schéma qui se rapproche le plus possible du PCB (d'où certains fils du schéma qui passe EN DESSOUS des composants). C'est effectivement de cette façon que le routage doit se faire, pour que les fils ne se croisent pas.
Du coup, il faut faire le placement des composants COMME SI on était déjà en train de router le PCB pour de vrai.

f4bjh, 2021-03-05:
#289

f4bjh, 2021-03-06:
Ah ouais !!! C'est niquel pour U5.

Reste à faire la même chose sur U3

MonFrancoue, 2021-03-06:
[image: image.png]  si on laisse le composant comme cela le logiciel est il
capable de le placer correctement ou bien vas t il croire que le composant
est monté à l'envers ?

Le sam. 6 mars 2021 à 17:52, Fabrice DECROP LONGET <notifications@github.com>
a écrit :

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

f4bjh, 2021-03-06:
Je ne connais pas assez Kicad pour evaluer la qualité du placement/routeur automatique.

En tout état de cause, ce qui compte, quelle que soit la valeur de Kicad, ceux sont les connexions électriques, qui elles doivent être correctes au schéma. A mons d'un gros bug chez Kicad, si la pin n°1 de U1 est connecté à une fiche SMA (c'est un exemple), on a l'assurance que cera le cas dans le mesh sur le PCB. La notion de composant à l'envers n'a, a priori, pas trop de sens à ce niveau.

Par contre, je conseille toujours de ne pas se fier aux placement/routeur automatique. Car le placement/routage est un sujet EXTREMENT délicat. S'ils ne sont pas de qualité, des problèmes fonctionnels important peuvent se présenter au final. Le pacement/routage est affaire de compromis. Il y a évidemment quelques règles incontournables : des connexions courtes, pas de boucles, éviter les couplages entre siganux sensibles et bus numériques haute vitesse, alim, etc...
Mais on ne fait pas toujours tout ce qu'on veut. C'est pour ça qu'il faut parfais faire des compromis. Et c'est là que les alogorithmes automatiques des placements/routage montrent bien des faiblesses.

Bref...tout ça pour dire que (et pour répondre à ta question) : normalement, non, il n'y a pas de raison a priori pour qu'il place le composant à l'envers. Par contre, je déconseille vivement d'utiliser les placeurs/routeurs automatiques. C'est la raison pour laquelle je vous demande de faire un schéma qui se rapproche déjà du PCB. Car, alors, il suffira de placer les composants au même endroits géométriques que le schéma. De tracer les pistes du PCB de la même manière que le schéma. S'il n'y a pas de piste qui se croisent au schéma, il n'y aura pas non plus de piste qui se croisent au moment du routage. Autre avantage de cette méthode (qui est la méthode F1FDD), c'est qu'en faisant le placement déjà au schéma, c'est que c'est plus simple au schéma (que sur le PCB en live). En effet, au schéma, c'est plus lisible, et on a une vision plus fonctionnelle que sur le PCB en live. Moins de risque de se plante a priori.

MonFrancoue, 2021-03-07:
Merci Fabrice

Le sam. 6 mars 2021 à 20:50, Fabrice DECROP LONGET <notifications@github.com>
a écrit :

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

Closed 2021-03-08.

Thread 357 (2021-03-05):

Remettre le schéma entier sur une grille

f4bjh, 2021-03-05:

f4bjh, 2021-03-05:
#289

f4bjh, 2021-03-06:
C'est bien !!!

Quelques petites remarques :
-R9=R15=1000ohms
-C18 mal placée (voir les specs)

Test DRC :

ErrType(3): Pin connectée à d'autres pins, mais aucune pin pour la piloter
    @(243,08 mm, 184,91 mm): Pin 1 (Power input) du composant #PWR025 non pilotée (Net 3).
ErrType(3): Pin connectée à d'autres pins, mais aucune pin pour la piloter
    @(98,04 mm, 251,21 mm): Pin 1 (Power input) du composant U1 non pilotée (Net 12).
ErrType(2): Pin non connectée (utiliser un marqueur de "non connexion" pour supprimer cette erreur)
    @(98,04 mm, 253,75 mm): La pin 3 (Entrée) du composant U1 est non connectée.
ErrType(3): Pin connectée à d'autres pins, mais aucune pin pour la piloter
    @(290,58 mm, 153,42 mm): Pin 1 (Power input) du composant U5 non pilotée (Net 15).
ErrType(3): Pin connectée à d'autres pins, mais aucune pin pour la piloter
    @(235,20 mm, 26,67 mm): Pin 1 (Power input) du composant U3 non pilotée (Net 24).
ErrType(2): Pin non connectée (utiliser un marqueur de "non connexion" pour supprimer cette erreur)
    @(151,13 mm, 158,24 mm): La pin 2 (Entrée) du composant U2 est non connectée.
ErrType(3): Pin connectée à d'autres pins, mais aucune pin pour la piloter
    @(232,16 mm, 106,68 mm): Pin 7 (Power input) du composant U4 non pilotée (Net 34).
ErrType(5): Problème de conflit entre pins. Sévérité: erreur
    @(290,58 mm, 168,66 mm): Pin 5 (Power output) du composant U5  connectée à
    @(235,20 mm, 41,91 mm): pin 5 (Power output) du composant U3 (net 37).
ErrType(5): Problème de conflit entre pins. Sévérité: erreur
    @(235,20 mm, 41,91 mm): Pin 5 (Power output) du composant U3  connectée à
    @(113,28 mm, 251,21 mm): pin 5 (Power output) du composant U1 (net 37).
ErrType(2): Pin non connectée (utiliser un marqueur de "non connexion" pour supprimer cette erreur)
    @(151,13 mm, 160,78 mm): La pin 1 (Entrée) du composant U2 est non connectée.

** messages ERC: 10  Erreurs 2  Avertissements 8

f4bjh, 2021-03-06:
non, non...pour C18 regarde p16 §3.8.2

Et puis, si tu veux bien, profites-en pour rajouer le pont de résistance (sur la fiche #302 )

f4bjh, 2021-03-06:
C'est niquel chrome !!! Good job :-)

JE passe la fiche en "terminé"

Closed 2021-03-08.

Thread 358 (2021-03-05):

Pb de connecteurs

f4bjh, 2021-03-05:
Il y a un problème ave les connecteurs, et je n'arrive pas à trouver des connecteurs qui vraiment pourraient faire l'affaire.

Je liste içi les contraintes :

1/Connecteurs CMS
Aujourd'hui, au schéma, on a des connecteurs traversant. C'est un tout petit eu embêtant, car ça veut dire qu'on est obligé de détourer le plan de masse sur le PCB. Ca a surtout l'inconvénient d'augmenter le QSJ
Il nous faudrait des connecteurs CMS

2/Connecteurs avec détrompeur
pour empêcher que les OM branche à l'envers. Tout simplement

3/Connecteur pour lesquels le (ou les) câbles ne se débranchent pas en bougeant le tosmètre...
Hormis peut-être pour le connecteur de programmation.

4/Des connecteurs pour lesquels on sait "facilement" fabriquer des câbles et des nappes
En effet, il faut pouvoir fabriquer "facilement" les cables LCD, programmateur, pile, alim, etc...
Connecteur à sertir pour les câbles ? Comment ça marche ? Ca se fait facilement ?
Connecteurs à souder pour les câbles ?

Il faut 2 connecteurs 2 points (pour l'inverseur du pack pile, et pour le bouton poussoir)
Il faut 1 connecteur 3 points (pour l'alim 12V)
Il faut un connecteur 6 points pour le connecteur de programmation
Il faut un connecteur 8 points pour le LCD

Pour les piles, il y a avait ça : https://fr.rs-online.com/web/p/embases-circuits-imprimes/4838461/ et https://fr.rs-online.com/web/p/boitiers-de-connecteurs-pour-circuits-imprimes/6795363/
Mais c'est traversant côté PCB, et à sertir côté câble ==> bof bof

Pour le LCD, il y aurait éventuellement ça : https://fr.rs-online.com/web/p/embases-circuits-imprimes/8633295/
Mais que faire côté nappe LCD ?

Pour la programmation, il y a ça : https://fr.rs-online.com/web/p/embases-circuits-imprimes/7676695/
Mais idem, comment faire le câble de programmation ?

f4bjh, 2021-03-05:
#306

f4bjh, 2021-03-05:
#289

F0EOS, 2021-03-05:
j'ai trouve les connecteur suivant qui pourrais servir

connecteur HARVIN
https://fr.rs-online.com/web/p/boitiers-de-connecteurs-pour-circuits-imprimes/1707061/
ou ce type la
https://fr.rs-online.com/web/p/boitiers-de-connecteurs-pour-circuits-imprimes/6812824/

bien sur avec le nombre de bornes adequat

f4bjh, 2021-04-01:
il va y avoir un peu le même pb que pour les fiches SMA : les connecteurs LCD et programmation sont traversants => il faudrait détourer le plan de masse. Chose à éviter au maximum !!!

Il faut trouver des connecteurs CMS pour brancher le LCD et le connecteur de programmation.

f4bjh, 2022-01-12:
@F0EOS tu peux regarder cette fiche : #358 ?

et me dire si d'après toi, elle est résolue ?

Closed 2022-04-30.

Thread 359 (2021-03-06):

Optimisation de la RAM

f4bjh, 2021-03-06:
Avec l'arrivée du multiplicateur 16 bits, revoir l'utilisation de la RAM, et l'optimiser

passer le multiplicateur sous IF 0
revoir l spec, et définir proprement les tailles des paramètres d'entrée et sorties
passer ttles les fonctions de conversion (BCD, ASCII, mV) dans CALC, dans un fichier conv.asm
revoir en conséquence le driver lcd et aff.asm, pour factoriser un maximum :
genre une fonction pour affiche 2 octets (quelque soit le format d'entrée etc etc...) => spécifier plus clairement les fonctions LCD dans la spec

f4bjh, 2021-03-06:
#353

f4bjh, 2021-03-08:
#370

f4bjh, 2021-03-10:
à tester (et supprimer les IF 0 si ça marche)

f4bjh, 2021-03-12:
il y a encore des choses à faire. En profiter pour faire un peu d'optimisation de code.

f4bjh, 2021-03-23:
suite à https://github.com/f8kgl/swr_power_meter/commit/7e447f08fc8445f2807797099d0cad4576f77b3a
ne compile plus :

error: No target memory available for section ".udata".
error: Error while writing object file.
make: *** [Makefile:79: swr_power_meter_f8kgl-V0.8.TEST.GPSIM.hex] Error 1

#390 #347 #391

f4bjh, 2021-03-24:
ce pb d'avère très complexe à résoudre, sachant qu'un trè gros travail a déjà été mené en ce sens. Et de plus, c'est sans garantie d'y arriver efficacement.

Le mieux est sans doute de revoir le scope du fw de test (et d'en enlever les dev du calcul de puissance en W)
Et eventuellement tirer une branche pour le futur fw opérationnel (sachant qu'on a déjà une fonctionnalité de calibration à peu près proche de la fonctionnalité finale)
Et de plus, ça permettrait de traiter la fiche #309

f4bjh, 2021-03-25:
reproduire les modifs du Makefile du lcd dans tous les autres composants

Closed 2021-04-04.

Thread 360 (2021-03-06):

Rapport de test FW de simulation

f4bjh, 2021-03-06:
Spécifier les tests de la simu GPSIM à faire (typ, appliquer certaines aleur à R1, et R2, une certain tension d'entrée, en déduire la valeur théorique
Faire les tests (c à d relever et les valeurs d'ADC du LCD en simu) #296
Faire un rapport des tests

Servira de modèle pour valider le proto finalement (pour les tests ADC et AOP en tout cas)

Closed 2021-04-05.

Thread 363 (2021-03-08):

revoir les conventiosn de nommage des variables

f4bjh, 2021-03-08:
l'objectif est d'optimiser l'utilisation de la RAM.

Pour cela, il faudrait que les variables soient créées par le main, et que l'on passe uniquement des pointeurs (taille 2 octets donc) à toutes (ou presque...faut voir, histoire de pas top compliquer le truc non plus...) les fonctions.

Main.asm
que des v_XXX pour les variables à proprement parler (ie adc, adc_ascii, adc_bcd, etc etc...)
que des v_p_XXX pour les variables en entrées/sorties des fonctions.

#362

Closed 2021-03-08.

Thread 369 (2021-03-08):

erreur de mesure à cause de GPSIM

f4bjh, 2021-03-08:
en fixant Vfwd = 0,1V

ADC FWD sur le LCD = 0x5F

Trace GPSIM : ltc2305.cc:156 CH0 voltage_in=0.100006 voltage_AOP_out=2.399994

En sortie AOP, on devrait avoir 2,40000V

f4bjh, 2021-03-08:
#370

f4bjh, 2021-04-11:
ltc2305.cc:156 CH0 voltage_in=0.100000 voltage_AOP_out=2.400000
ltc2305.cc:179 voltage=2.400000 (0x07ae)

Closed 2021-04-11.

Thread 372 (2021-03-08):

petit temps de latence entre la sortie du message de boot, et l'affichage de ADC FWD et REF

f4bjh, 2021-03-08:
cela vient-il sans doute des log timer sample.

A confirmer.

Sera corrigé du coup ?

f4bjh, 2021-03-16:
en effet. En déactivant les traces (TAG 0x0004), cette latence disparaît

Closed 2021-04-05.

Thread 373 (2021-03-08):

les logs redémarre @0x00 après avoir écrit entièrement l'EEP

f4bjh, 2021-03-08:
le buffer circulaire commence en 0x20. Sinon, écrase le début de l'EEP (et donc la version écrite en dure, et les paramètes de calibration...ce qui est particulièrement gênant ;-)

Closed 2021-03-09.

Thread 377 (2021-03-11):

Log timer FXM1616U (tag=0x42)

f4bjh, 2021-03-11:
Mise en place d'un log timer pour FXM1616U (attention, timer 0 déjà utilisé...) pour confirmer les valeurs de l'étude §5.3.1

à ajouter aux tests

f4bjh, 2022-02-07:
repoussé en V1.0

Thread 378 (2021-03-11):

les valeurs en mV affichée sont fausses

f4bjh, 2021-03-11:
Typ, pour V=0,3V, affiche 0A00V (valeur hexa...)
Et de plus, il y a des valeur rémanantes qui restent affichées si on change les valeurs de tension à la volée

Closed 2021-03-11.

Thread 379 (2021-03-11):

passer par f_calc_shift_12bits prend plus de temps

f4bjh, 2021-03-11:
suite à https://github.com/f8kgl/swr_power_meter/commit/b54db4aec62be579402ab95b6e6831933e590e97

j'observe que pour diviser par 4096, il vaut mieux passer par une division écrite manuellement, plutôt que par un appel de fonction qui factorise.

f4bjh, 2021-03-19:
flag de debug implémenté

Thread 380 (2021-03-12):

octet d'activation des niveaux de traces en EEP

f4bjh, 2021-03-12:

f4bjh, 2021-03-15:
si config =0x44 => ça marche
si config = 0x42 => ça marche (et tout ça à la volée)

par contre config = 0x46...plus aucune trace (alors qu'on aurait du avoir les 2 précédentes par ex)

f4bjh, 2021-03-16:
bon, déjà il y a un pb dans les specs (ex 0x43) est surchargé par 0x42 ou 0x41

il y a encore des traces AOP dans les specs

bref...specs à revoir déjà pour commencer

f4bjh, 2021-03-16:
le pb vient de ce que le quartet peut activer plusieurs TAG de log à chaque fois...ce qui pose un réel problème

f4bjh, 2021-03-16:
il y a du mieux...mais ça écrit 0xFF en boucle

f4bjh, 2021-03-16:
si l'on fait du pas à pas sous Gpsim, tout fonctionne convenablement.

Mais dès que l'on passe en dynamique, le timer0 se réinitialise tout seul dès que l'on arrête 'au travers d'un clrf T0CON, ou même d'un bcf T0CON,7)
=> restrictions V0.8

f4bjh, 2021-03-19:
flag de debug implémenté

Thread 386 (2021-03-17):

Pb de reproductibilité de la mesure de tension

f4bjh, 2021-03-17:
au démarrage, le LCD affiche 52h - 100mV (pour Vfwd = 0.1mV =>OK)

mettre Vfwd = 2,4V

puis revenir à 0,1V

Le LCD affiche alors 5Fh - et 115mV !!!

f4bjh, 2021-03-17:
#348

Closed 2021-04-11.

Thread 387 (2021-03-18):

le chargement de kconv (en dBm) sous GPSIM ne fonctionne pas

f4bjh, 2021-03-18:
cmd_load module=p18f1320 file=kconv.TEST.hex
Extended linear address 0 0
Extended linear address 0 f00000
Index 15728648 exceeds size 256 at line 3

f4bjh, 2021-03-19:
à voir : p15 de http://gpsim.sourceforge.net/gpsim.pdf

à tester aussi du coup : chargement d'un .hex plutôt que d'un .cod par gpsim (sans doute faire évoluer le plan de test aussi du coup...)

f4bjh, 2021-03-19:
#347

Closed 2021-04-04.

Thread 388 (2021-03-19):

ajout du calibrator dans le Makefile

f4bjh, 2021-03-19:
ajouter la compilation du calibrator dans le Makefile

+la génération de kconv.TEST.hex
+la recopie de kconv.TEST.hex dans /bin

f4bjh, 2021-03-20:
à ajouter au readme.md, pour ne pas oublier comment il s'utilise (via le makefile), et donner quelques explications sur sa manière de fonctionner

Closed 2021-04-04.

Thread 389 (2021-03-20):

faut-il charger kconv.GPSIM.hex ou kconv.TEST.hex ?

f4bjh, 2021-03-20:
Sur la cible, quel fichier de calinration de kconv faudra t'il charger ?

Les 2 fichiers sont formattés légèrement différement.

GPSIM prend par défaut l'adresse de départ à 0x0000 (voir §2.11 de   http://gpsim.sourceforge.net/gpsim.pdf)

Or, sur la cible réelle, ce ne sera pas le cas a priori...

Thread 395 (2021-03-31):

pas mal de factorisation à faire dans aff.asm

f4bjh, 2021-03-31:
beaucoup de fonction appelées qui se répète...

mutualiser tout ça pour gagner un peu de place dans le code

f4bjh, 2021-04-01:
à reporter dans les autres fonctions si ça marche
enlever les IF 0

Closed 2021-04-05.

Thread 396 (2021-04-01):

affichage de la tension en mV est cassé

f4bjh, 2021-04-01:
suite à https://github.com/f8kgl/swr_power_meter/commit/9e2678deca245412820cff695d4c7f86771aacc4

l'affichage de la tension en mV des voies FWD er REF est cassé (affiche 0000mV ou 0A00mV)

#347

Closed 2021-04-04.

Thread 407 (2022-05-11):

Question PCB

F0EOS, 2022-05-11:
Pour J4 et J7 ne peut on pas mettre des points info comme J2 , J3 ou J6
si je me trompe pas c'est la que vas venir "la tension" mesurée aux bornes de la ligne coaxial

pour j4 et j7 je peut on pas les mettre de chaque cote du PCB  toujours par rapport a la ligne coaxiale ??

ne doit on pas fixer une taille maxi du PCB ?? afin d'optimiser au mieux l'emplacement des composants ? peut être a voir en fonction de la ligne coaxial si elle est realisée sur PCB

f4bjh, 2022-05-16:
>Pour J4 et J7 ne peut on pas mettre des points info comme J2 , J3 ou J6
>si je me trompe pas c'est la que vas venir "la tension" mesurée aux bornes de la ligne coaxial

Non. Car ce n'est pas "la tension à mesurer" qui arrive sur J4 ou J7. Mais les signaux HF transmis et réfléchis

>pour j4 et j7 je peut on pas les mettre de chaque cote du PCB toujours par rapport a la ligne coaxiale ??
Oui ça c'est possible

>ne doit on pas fixer une taille maxi du PCB ?? afin d'optimiser au mieux l'emplacement des composants ? peut être a voir en >fonction de la ligne coaxial si elle est realisée sur PCB

Oui.

Thread 410 (2022-05-19):

améliorer le routage de J5

f4bjh, 2022-05-19:
éviter que les pistes de bornes 1 et 2 de J5 fassent le tour du composant.

cela suppose une modif schéma :

-refaire le schéma des pin 13 et 14 de U2 pour les relier aux pins 1 et 2 de J5
-tirer les fils des pin 15 et 4 de U2 sur les pins 3 et 4 de J5

faire le routage en conséquence

Thread 419 (2022-05-23):

firmware de calibration

f4bjh, 2022-05-23:
développement du fw de calibration suivant les specs qui suit #264

f4bjh, 2022-05-23:
suite au commit ci-dessous, make test ne passe plus :

`$ make test
mkdir -p ../bin
cp ../prj/*.stc ../bin
cp ../src/hw/sim/gpsim/netlist.stc ../bin
cp ../src/tools/gen_table/10logADC.inc ../src/sw/inc
gpasm -c -e ON -DSW_VERSION="\"V1.0\"" -DTEST -DDEBUG_ISSUE_379 -DDEBUG_ISSUE_380 -DDEBUG_ISSUE_389 -p 18f1320 -I../src/sw/inc/ -o main.TEST.o main.asm
gpasm -c -e ON -DSW_VERSION="\"V1.0\"" -DTEST -DDEBUG_ISSUE_379 -DDEBUG_ISSUE_380 -DDEBUG_ISSUE_389 -p 18f1320 -I../src/sw/inc/ -o ../src/sw/data/eep_int.TEST.o ../src/sw/data/eep_int.asm
gpasm -c -e ON -DSW_VERSION="\"V1.0\"" -DTEST -DDEBUG_ISSUE_379 -DDEBUG_ISSUE_380 -DDEBUG_ISSUE_389 -p 18f1320 -I../src/sw/inc/ -o ../src/sw/data/lcdmsg.TEST.o ../src/sw/data/lcdmsg.asm
gpasm -c -e ON -DSW_VERSION="\"V1.0\"" -DTEST -DDEBUG_ISSUE_379 -DDEBUG_ISSUE_380 -DDEBUG_ISSUE_389 -p 18f1320 -I../src/sw/inc/ -o ../src/sw/data/10logADC.TEST.o ../src/sw/data/10logADC.asm
make -C ../src/sw/misc ../../../bin/libtestmisc.a
make[1] : on entre dans le répertoire « /home/f4bjh/devel/f8kgl/swr_power_meter/src/sw/misc »
gpasm -c -I../inc/ -DTEST -DDEBUG_ISSUE_379 -DDEBUG_ISSUE_380 -DDEBUG_ISSUE_389 -p 18f1320 tempo.asm -o tempo.TEST.o
gplib -c ../../../bin/libtestmisc.a tempo.TEST.o
rm *.o
rm *.lst
make[1] : on quitte le répertoire « /home/f4bjh/devel/f8kgl/swr_power_meter/src/sw/misc »
make -C ../src/sw/lcd ../../../bin/libtestlcd.a
make[1] : on entre dans le répertoire « /home/f4bjh/devel/f8kgl/swr_power_meter/src/sw/lcd »
gpasm -c -I../inc/ -DTEST -DDEBUG_ISSUE_379 -DDEBUG_ISSUE_380 -DDEBUG_ISSUE_389 -p 18f1320 aff.asm -o aff.TEST.o
gpasm -c -I../inc/ -DTEST -DDEBUG_ISSUE_379 -DDEBUG_ISSUE_380 -DDEBUG_ISSUE_389 -p 18f1320 driver.asm -o driver.TEST.o
gplib -c ../../../bin/libtestlcd.a aff.TEST.o driver.TEST.o
rm *.o
rm *.lst
make[1] : on quitte le répertoire « /home/f4bjh/devel/f8kgl/swr_power_meter/src/sw/lcd »
make -C ../src/sw/i2c ../../../bin/libtesti2c.a
make[1] : on entre dans le répertoire « /home/f4bjh/devel/f8kgl/swr_power_meter/src/sw/i2c »
Makefile:29: avertissement : surchargement de la recette pour la cible « ../../../bin/libcalibi2c »
Makefile:24: avertissement : ancienne recette ignorée pour la cible « ../../../bin/libcalibi2c »
make[1]: *** Aucune règle pour fabriquer la cible « ../../../bin/libtesti2c.a ». Arrêt.
make[1] : on quitte le répertoire « /home/f4bjh/devel/f8kgl/swr_power_meter/src/sw/i2c »
make: *** [Makefile:132 : ../bin/libtesti2c.a] Erreur 2
`
