f8kgl/swr_power_meter/(list of files, drawings)

Other design files:
src/hw/TOSMETRE.dsn
