f8kgl/swr_power_meter/src/hw/TOSMETRE.kicad_pcb

## KiCad design src/hw/TOSMETRE.kicad_pcb (2022-05-24)

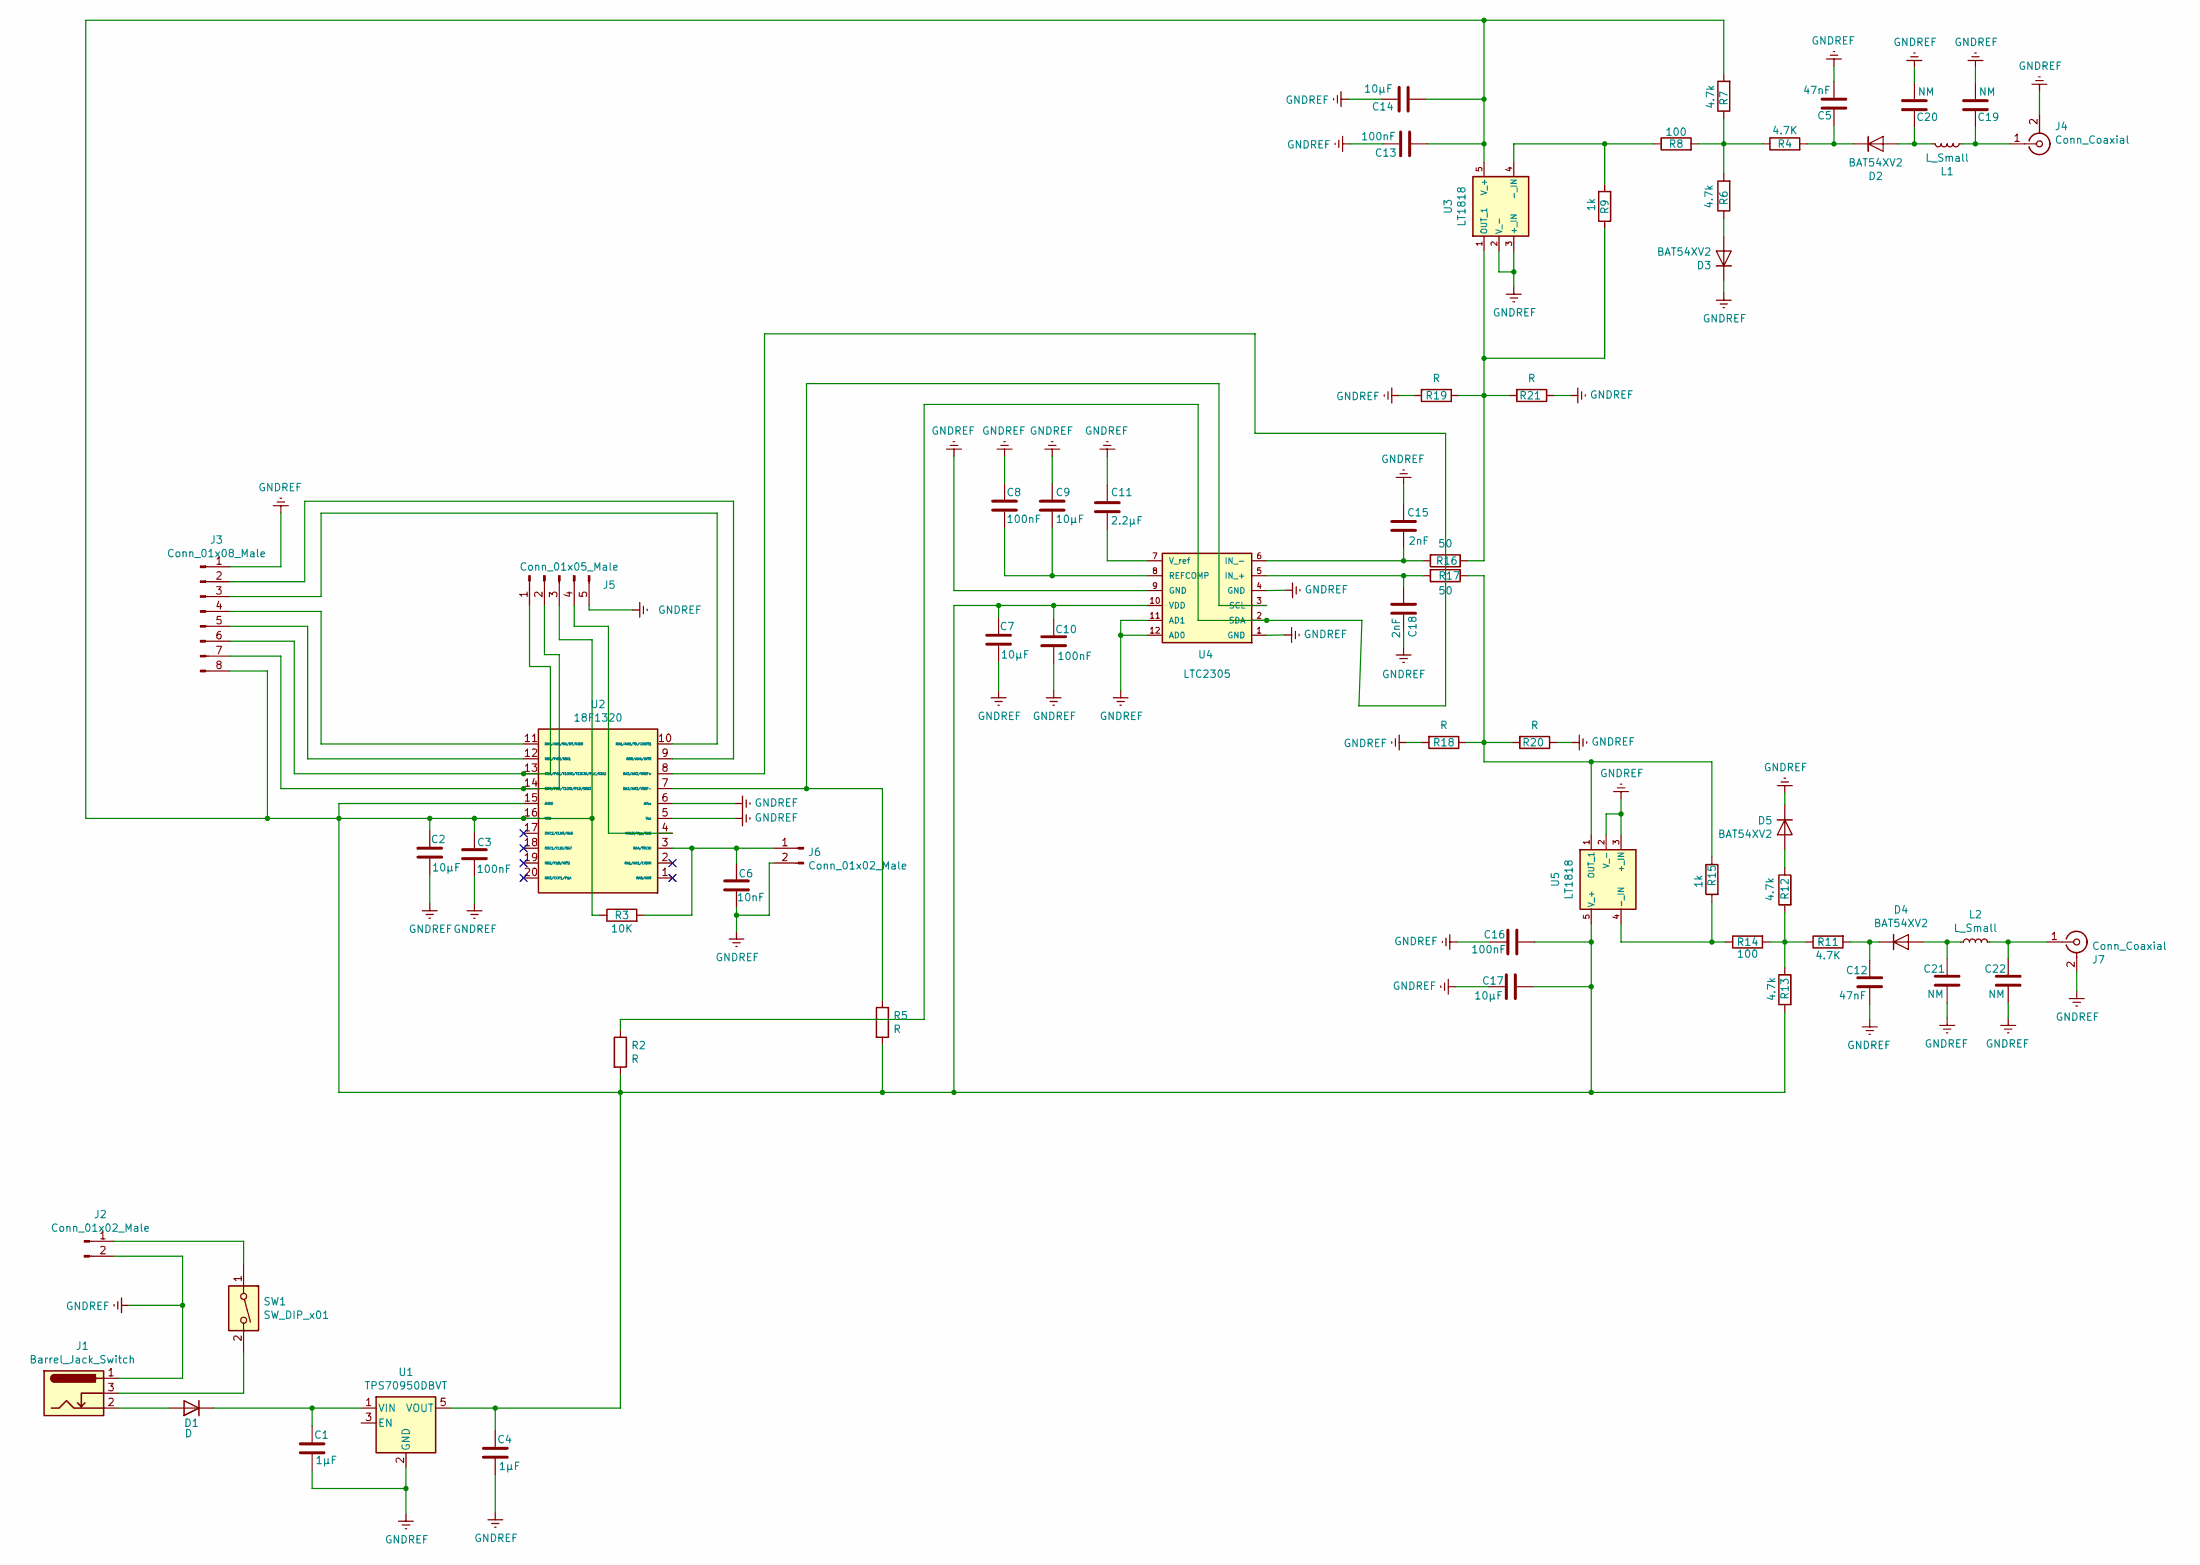
[picture p48: schematic TOSMETRE.kicad_sch]

Parts:
C1, C4: 1µF; C_1206_3216Metric
C2, C7, C9, C14, C17: 10µF; C_1206_3216Metric
C3, C8, C10, C13, C16: 100nF; C_1206_3216Metric
C5, C12: 47nF; C_1206_3216Metric
C6: 10nF; C_1206_3216Metric
C11: 2.2µF; C_1206_3216Metric
C15, C18: 2nF; C_1206_3216Metric
C19, C20, C21, C22: NM; C_1206_3216Metric
D1: D; D_1206_3216Metric
D2, D3, D4, D5: BAT54XV2; D_SOD-523
J1: Barrel_Jack_Switch; PinHeader_1x03_P2.54mm_Vertical_SMD_Pin1Left
J2, J6: Conn_01x02_Male; PinHeader_1x02_P2.54mm_Vertical_SMD_Pin1Left
J3: Conn_01x08_Male; PinHeader_1x08_P2.54mm_Vertical_SMD_Pin1Right
J4, J7: Conn_Coaxial; MMCX_Molex_73415-0961_Horizontal_0.8mm-PCB
J5: Conn_01x05_Male; PinHeader_1x05_P2.54mm_Vertical_SMD_Pin1Left
L1, L2: L_Small; R_1206_3216Metric
R2, R5, R18, R19, R20, R21: R; R_1206_3216Metric
R3: 10K; R_1206_3216Metric
R4, R11: 4.7K; R_1206_3216Metric
R6, R7, R12, R13: 4.7k; R_1206_3216Metric
R8, R14: 100; R_1206_3216Metric
R9, R15: 1k; R_1206_3216Metric
R16, R17: 50; R_1206_3216Metric
SW1: SW_DIP_x01; PinHeader_1x02_P1.00mm_Vertical_SMD_Pin1Left
U1: TPS70950DBVT; SOT-23-5
U2: 18F1320; SSOP-20_4.4x6.5mm_P0.65mm
U3, U5: LT1818; TSOT-23-5
U4: LTC2305; MSOP-12_3x4mm_P0.65mm

Connections:
GNDREF: C1.2, C2.1, C3.1, C4.2, C5.2, C6.2, C7.1, C8.1, C9.1, C10.1, C11.1, C12.2, C13.1, C14.1, C15.1, C16.1, C17.1, C18.1, C19.2, C20.2, C21.2, C22.2, D3.1 (K), D5.1 (K), J1.1, J2.2, J3.1, J4.2 (Ext), J5.5, J6.2, J7.2 (Ext), R18.2, R19.2, R20.1, R21.1, U1.2 (GND), U2.5 (Vss), U2.6 (AVss), U3.2 (V_-), U3.3 (+_IN), U4.1 (GND), U4.4 (GND), U4.9 (GND), U4.11 (AD1), U4.12 (AD0), U5.2 (V_-), U5.3 (+_IN)
unnamed: C1.1, D1.1 (K), U1.1 (VIN)
unnamed: C5.1, D2.1 (K), R4.2
unnamed: C6.1, J6.1, R3.2, U2.3 (RA4/T0CKI)
unnamed: C8.2, C9.2, U4.8 (REFCOMP)
unnamed: C2.2, C3.2, C4.1, C7.2, C10.2, C13.2, C14.2, C16.2, C17.2, J3.8, J5.3, R2.2, R3.1, R5.2, R7.2, R13.2, U1.5 (VOUT), U2.15 (AVDD), U2.16 (VDD), U3.5 (V_+), U4.10 (VDD), U5.5 (V_+)
unnamed: C11.2, U4.7 (V_ref)
unnamed: C12.1, D4.1 (K), R11.2
unnamed: C15.2, R16.2, U4.6 (IN_-)
unnamed: C18.2, R17.2, U4.5 (IN_+)
unnamed: C19.1, J4.1 (In), L1.1
unnamed: C20.1, D2.2 (A), L1.2
unnamed: C21.1, D4.2 (A), L2.1
unnamed: C22.1, J7.1 (In), L2.2
unnamed: D1.2 (A), J1.2
unnamed: D3.2 (A), R6.1
unnamed: D5.2 (A), R12.1
unnamed: J1.3, SW1.2
unnamed: J2.1, SW1.1
unnamed: J3.2, U2.9 (RB0/AN4/INT0)
unnamed: J3.3, U2.10 (RB1/AN5/TX/CKINT1)
unnamed: J3.4, U2.11 (RB4/AN6/RX/DT/KIB0)
unnamed: J3.5, U2.12 (RB5/PGM/KBI1)
unnamed: J3.6, J5.1, U2.13 (RB6/PGC/T1OSO/T13CKI/P1C/KBI2)
unnamed: J3.7, J5.2, U2.14 (RB7/PGD/T1OSI/P1D/KBI3)
unnamed: J5.4, U2.4 (MCLR/Vpp/RA5)
unnamed: R2.1, U2.8 (RA3/AN3/VREF+), U4.2 (SDA)
unnamed: R4.1, R6.2, R7.1, R8.2
unnamed: R5.1, U2.7 (RA2/AN2/VREF-), U4.3 (SCL)
unnamed: R8.1, R9.2, U3.4 (-_IN)
unnamed: R11.1, R12.2, R13.1, R14.2
unnamed: R14.1, R15.2, U5.4 (-_IN)
unnamed: R15.1, R17.1, R18.1, R20.2, U5.1 (OUT_1)
unnamed: R9.1, R16.1, R19.1, R21.2, U3.1 (OUT_1)

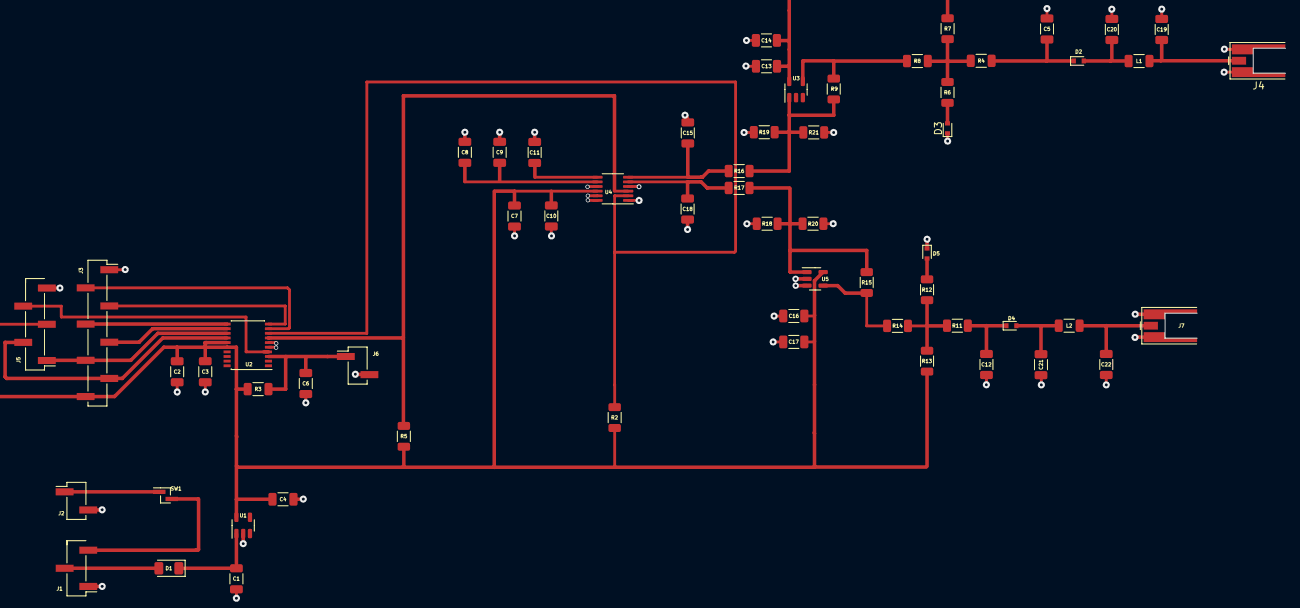
[picture p49: board TOSMETRE.kicad_pcb from above]

Board: 2 copper layers, 61 parts (0 on the bottom side), 34 nets.
