f8kgl/swr_power_meter/(commit log)

2017-12-15 Version 0.2 de la spec
2017-12-17 V0.2 : -affichage du message de calibration -tempo de 5 secondes après affichage du message de boot -détail le mot de config du PIC -ajout des commentaires dans main -MAJ de la spec -remarque : dans 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
    [TOSMETRE.kicad_pcb, TOSMETRE.sch]
2017-12-18 -ajout du composant EEP -eep_readbyte utilisé par le composant lcd -MAJ des Makefil en conséqunce -Spec V0.3
2017-12-18 -V1.0 -changement PIC : 16F628a -> 16F88 -correction dans le paramètre d'entrée de eep_readbyte
    [driver.asm, main.asm]
2017-12-18 composant ADC : mesure du port FWD
2017-12-18 affiche le résultat de la conversion analogique-numérique
2017-12-19 -dans lcd_convtoascii, il manque les lettres A,B,C,... -mauvaise gestion des octets récupérés à afficher (rrf->swapf) -MAJ de la spec -main.inc ne sert plus à rien
    [driver.asm]
2017-12-20 changement de stratégie dans la gestion de version : V0.x : versions pour développement des fonctionnalités V1.x : sera le 1er tag de la version définitive du sw et hw, embarquant toutes les fonction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
2017-12-20 -affiche le résulyat de l'ADC sur le port réfléchi aussi -v_charpos est en bank 0 -test l'octet de calibration en EEPROM
2018-03-10 grosse MAJ HW
    [TOSMETRE.kicad_pcb, TOSMETRE.sch]
2018-03-10 MAJ doc
    [courbe_Vdetect.ods]
2018-03-15 essai mise a jour avec modif cablage LCD/PIC
    [TOSMETRE.kicad_pcb, TOSMETRE.sch]
2018-03-17 realisation PCB avec Plan de masse
    [TOSMETRE.kicad_pcb, TOSMETRE.sch]
2018-03-18 MAJ de la doc -> V0.5
2018-03-18 Bug n°1 : mise en forme du message de boot
2018-03-18 MAJ doc V0.5 : ajout d'un tableau de bug pour le suivi des erreurs soft et hw (erreurs de schémas, erreur de PCB) + ajout d'un tableau de suivi de version + maj du message de boot + ajout de la doc V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
2018-03-19 déplace le fichier de suivi de bug et de versions vers un répertoire plus haut car ce fichier ne sera pas tagué
    [Bug_et_suivi_de_version.ods]
2018-03-20 connecteur pour LCD
    [TOSMETRE.kicad_pcb]
2018-03-20 Correction #2 : Mise en forme du message du mode test (spec) Correction #14 : Erreur dans la doc §3.5.4.2 Correction #22 : Définir un mode test (spec)
2018-03-21 Modif Plots Alimentation CI
    [TOSMETRE.kicad_pcb, TOSMETRE.sch]
2018-03-21 réalisation du composant 18F1320 réalisation schéma avec composant 18f1320
    reste a associer l’empreinte au composant et PCB a réaliser
    [TOSMETRE18F1320.kicad_pcb, TOSMETRE18F1320.sch]
2018-03-21 realisation rapide PCD 18f1320 a optimiser
    [TOSMETRE18F1320.kicad_pcb, TOSMETRE18F1320.sch]
2018-03-21 Allez, c'est parti : correction de #39 : Mise à jour en V0.5 (1er round). Içi, se borne essentiellement à la mise à jour des Makefile pour la génération des fw de test ajoute une table de calibration
2018-03-22 Correction de #40 :Warning[220] Address exceeds maximum range for this processor.
2018-03-22 nom de cste plus clair et cohérent avec la fonctionnalité
2018-03-22 Correction de #42 : place correctement la table de calibration en 0xC00
2018-03-22 oubli de masse sur 7805 et LCD rectifie
    [TOSMETRE.kicad_pcb]
2018-03-22 relocalise le vecteur de reset en 0x0
    [main.asm]
2018-03-22 correction petite erreur sur PCB
    [TOSMETRE.kicad_pcb]
2018-03-22 Correction de #45, 44,43, 41,22 (10%) Saloperie de #!§?$/ d'éditeur de lien : obligé de le laisser faire pour fixer l'adresse de la table de calibration (grrrr !!!). Du coup, tout le code a bougé, et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
    [adc.asm, main.asm]
2018-03-23 oubli de rev62 (driver eep) + correction partielle de 47 : bug d'affichage du message de boot. Il faut effectivement positionner la valeur de PCLATH avant tout appel de fonction ou de tableaux dont l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
    [driver.asm]
2018-03-23 oups (confusion possible entre le nom du module eep, et le fichier source eep.asm) + MAJ tableau de suivi de bug et versions
2018-03-23 Modification C5 Modification du PCB suite modif c5 Preparation dimension PCB pour ligne 50 Ohms
    [TOSMETRE.kicad_pcb]
2018-03-28 oubli du via de masse sur C3
    [TOSMETRE.kicad_pcb, TOSMETRE.sch]
2018-05-13 modification alimentation de la platine
    [TOSMETRE.kicad_pcb]
2018-05-16 deplacement piste entre borne 14 et 15 du LCD suite a contact
    [TOSMETRE.kicad_pcb]
2018-05-16 preparation pour mise a la taille du PCB pour Boitier Disponible au RC
    [TOSMETRE.kicad_pcb]
2018-05-25 Modif piste pour "esthetique"
    [TOSMETRE.kicad_pcb]
2018-05-30 ouh ouh !!! Ahhhhhh y est !!!!!!!!!!!!!!!!!!!!!!!!!!! Punaise de saloperie de bug du registre PCLATH. Je t'ai eu !!! Chaque appel de fonction doit s'assurer que le PCLATH est placé à la bonne valeur.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
    [driver.asm, main.asm]
2018-05-30 MAJ doc en conséquence des derniers SVN
2018-06-03 MODIF OPTIMISATION EN COURS AVEC SUPPRESSION Q ET CAPA
    [TOSMETRE.kicad_pcb]
2018-06-03 MODIF EN COURS AVEC CONNECTEUR PROGRAMMATION LA PRISE DE TETE A VENIR ........................
    [TOSMETRE.kicad_pcb, TOSMETRE.sch]
2018-06-03 réminiscence du pb de PCLATH : il faut veiller aussi à sa valeur pour les tableaux statiques. Dans l'immédiat, déplace les tableaux statiques du LCD dans /data...il faudra trouver un e meilleur solut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
2018-06-03 ben oui, il faut appliquer la correction du PCLATH à TOUS les appels de fonctions (pffff..). L'affichage de la valeur de l'ADC brute est ainsi rendue fonctionnelle de surcroît...ça veut dire que ça s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
2018-06-03 Version Opti V1
    [TOSMETRE.kicad_pcb, TOSMETRE.sch]
2018-06-03 Mise a jour reussi
    Ne pas tenir compte de mon Mail
    [TOSMETRE.kicad_pcb]
2018-06-06 Aeration Schema de principe
    [TOSMETRE.sch]
2018-06-10 positionne la valeur de l'ADC fwd au bon endroit sur le LCD
2018-06-10 MAJ doc + erreur dans un commentaire dans la table de calibration + oubli dans le makefile
2018-06-11 remplace les noms de fonctions en commençant par f_xxx, et idem pour les tableaux statiques en commençant par c_xxx (c comme "constante")
2018-06-11 1ère mouture d'affichage d'une valeur d'ADC en mV (driver de flh + calibration). Tout ça pour le firmware de test uniquement
2019-02-10 JUSTE POUR REMEMORISER ET MODIF LARGEUR PISTE A UN ENDROIT
    RIEN DE NOUVEAU DEPUIS LA NOUVELLES VERSION
    LE PC ET LA SOURIS ATTENDENT DE TRAVAILLER.......... lol
    [TOSMETRE.kicad_pcb]
2019-03-02 MAJ de la doc, et nettoyage de printemps. bug #51 corrigé. Reste le 52, qui est plus compliqué que prévu...
    [driver.asm, main.asm]
2019-03-04 MAJ base de bug et doc. correction mineure du driver de flh
    [driver.asm]
2019-03-04 bug #52,53,54,55 (et c'est que le début...) 16f88 -> 18f1320 pour s'affranchir du pb de read dans la flash sous gpsim...
    [adc.asm, calc.asm, driver.asm, main.asm]
2019-03-05 bug #52,53,54,55,11 on s'attache à faire marcher le LCD déjà. On verra pour le reste ensuite
    [driver.asm, main.asm]
2019-03-11 -on utilise INTIO1 pour l'OSC (et non pas XT) -ajout d'init du PIC -bug #59 : il faut incrémenter v_charpos 2 fois (le contenu pointé par PC est sur 16bits visiblement) -pas de BANKSEL avec le 18lf13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
    [driver.asm, main.asm]
2019-03-11 bug 58,59 il faut désactiver AN6 avant d'utiliser le LCD. Sinon, RB4 n'est pas drivable par le PIC. Pour le moment, désactive tous les ADC dans ADCON1 à l'arrache (tant que #61 n'est pas corrigé et q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
    [main.asm]
2019-03-12 #61 pas de BANKSEL sur 18f1320 + correction driver (bit CFGS de EECON1) + la lecture en EEPROM se fait sur 8 bits (et non 16 bits comme en flash)
    [driver.asm]
2019-03-12 -corrige un commentaire -#61 initialise OSCON + pour une raison que j'ignore, gpasm semble rajouter un nop après chaque goto/call. Si bien que les tempos ne sont plus correctes
    [main.asm]
2019-03-12 #60 : remet la lecture des ADC pour le 18f1320
2019-03-12 #60 : affiche la valeur des ADC sur le LCD
2019-03-12 #11,60,56 : YESSSSSSSSSS !!! passage au 18F1320 terminé !!! MAJ de la base de bug remet le calcul en mV des ADC remet le driver de flh (avec TBLRD cette fois-ci) encore un petit effort, et on va pouv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
    [calc.asm, driver.asm, main.asm]
2019-03-13 #65 : la table de calibration contient des valeurs sur 16 bits. Il faut adapter le pointeur en conséquence : multiplier par 2 la valeur retournée par l'ADC. En l'état, cette correction ne marche pas 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
    [calc.asm]
2019-03-14 prépare l'affichage des adc en mV sur le LCD
2019-03-14 affichage de l'ADC en mV sur le LCD : work in progress
2019-03-27 affiche l'ADC en mV
2019-03-27 commence à préparer un peu la suite (V1.0)
2019-03-27 un peu de cosmétique, c'est bientôt le printemps :-)
2019-03-27 fin de la V0.5. Doc complète et à jour
2019-05-20 mise a jour des fichiers suite a la mise a jour de kicad Pas de modification
    [TOSMETRE.sch]
2019-05-25 REMPLACEMENT lcd ET PRISE INFO PAR CONNECTEUR
    [TOSMETRE.kicad_pcb, TOSMETRE.sch]
2019-05-25 MODIFICATION PIC PAR 18F13K50 SSOP POUR EMPREINTE DU 18F1320 NORMALEMENT C'EST LES MEME AU NIVEAU GABARIT
    CABLAGE DES BORNES RA0 RA1 RA3 RA4 RA5 SUR LES BORNES RA0 RA1 RA3 RA4 RA5 DU 18FXXXX
    CABLAGE DES BORNES RB4 RB5 RB6 RB7 SUR LES BORNES RB4 RB5 RB6 RB7 DU 18FXXXX
    CABLAGE DES BORNES VSS ET VDD SUR LES BORNES VSS ET VDD DU 18FXXXX
    JE N'AI PAS SUPPRIMER LE 16F PARCE QUE JE NE SAIS PAS OU VONT LES BORNES 9 ET 10 SUR LE 18F
    VERIFIE DEJA CA AVANT QUE JE RAJOUTE LES MAX.....
    [TOSMETRE-2019-05-20-21-33-12.sch, TOSMETRE.sch]
2019-05-29 association des composants avec les empreintes
    [TOSMETRE.kicad_pcb, TOSMETRE.sch]
2019-05-29 PCB réaliser et a vérifier
    pas de max installer pour le moment
    voir les bornes a déplacer du 16f au 18f
    [TOSMETRE.kicad_pcb, TOSMETRE.sch]
2019-05-31 sup du 16f88 raccordement borne 9 du 16f a la borne 9 du 18f ( RB2/SDO/RX/DT => T10SC0/SDO/AN9/RC7) raccordement borne10 du 16f a la borne 7 du 18f ( RB3/PGM/CCP1 => PGM/C12IN3-/P1C/AN7/RC3)
    BIEN SUR TOUTES LES CORRESPONDANCE SONT A VERIFIER
    [TOSMETRE.sch]
2019-06-03 CREATION pic 18F1330 SUITE A CONFUSION RESTE A ME DIRE OU TOUT LE RESTE VA
    [TOSMETRE.sch]
2019-06-03 modif schema sur PIC 18f1320 creation PIC 18f1320
    Racordement sur pic a verifier
    [TOSMETRE.sch]
2019-06-08 refonte totale PCB probleme cablage du composant
    Sauvegarde en cours de realisation
    [TOSMETRE.kicad_pcb, TOSMETRE.sch]
2019-06-08 Finalisation PCB reste face GND et via a faire sans les MAX
    [TOSMETRE.kicad_pcb]
2019-06-09 CABLAGE DU 11100 IDENTIQUE A LA DATASHEET REALISATION DU max11100 ET DU max4624
    ATTENT CONSIGNE
    [TOSMETRE.sch]
2019-06-12 Les max sont present sur pcb max 11100 cablé selon datasheet et relier au +5v max4624 present sur pcb mais non cable
    [TOSMETRE.kicad_pcb, TOSMETRE.sch]
2019-06-17 arrangement visuel
    [TOSMETRE.sch]
2019-06-24 Modif "Freidrischaffen"
    Borne LCD =======================> BORNE PIC
    1 VSS -------------->GND
    2 D7---------------------------------> 7 RA2
    3 D6---------------------------------> 11 RB4
    4 D5 --------------------------------> 12 RB5
    5 D4 --------------------------------> 13 RB6
    6 RS --------------------------------> 14 RB7
    7 E ---------------------------------> 20 RB3
    8 VDD ------------> +5V
    Si le pcb te conviens voila les corrections LCD=>PIC
    [TOSMETRE.kicad_pcb, TOSMETRE.sch]
2019-06-25 DEPLACEMENT CONNECTEUR PRG
    [TOSMETRE.kicad_pcb]
2019-06-26 nettoyage, non pas de printemps, mais de début d'été
2019-06-26 il ne faut jamais, AU GRAND JAMAIS, livrer des binaires.
    Car il s'agit d'espace payant, inutile, inutilisé, et inutilisable...
    A raison de 1 pack de bière par ko, tu me dois environ 30 pack de 6 leffes blondes (note à l'OM qui développe le hardware de ce projet)
2019-06-26 #76 : discrime les utillisateurs de Windows et Linux
    #77 : ne sera pas corrigé (trop galère, avec cette saloperie de Windows...) et n'apporte finalement pas grand chose. L'utilisateur windows devra récupérer le fichier 18f1320_g.lkr, et le mettre dans prj. Le fichier lkr n'a pas vocation à être livré non plus pour éviter les doublons
2019-06-30 simulation du détecteur HF sous Qucs
    [SWR_POWER_METER_F8KGL_detecteur.sch]
2019-07-01 Etude du détecteur HF
    [SWR_POWER_METER_F8KGL_detecteur.sch, courbe_Vdetect.ods]
2019-07-01 Etude du detecteur HF (doc + simu)
    [SWR_POWER_METER_F8KGL_detecteur.sch, SWR_POWER_METER_F8KGL_etude_detecteur_V0.6_@2.1.1.sch, courbe_Vdetect.ods]
2019-07-01 Compléments sur l'étude du détecteur +Etude du coupleur directif
    [SWR_POWER_METER_F8KGL_etude_coupleur_directif.sch, courbe_Vdetect.ods]
2019-07-02 MAJ des specs +correction du schéma Qucs du détecteur HF +ajout de la doc de la BAS70H
    [SWR_POWER_METER_F8KGL_etude_detecteur_V0.6_@2.1.1.sch]
2019-07-02 Refonte de la doc d'implémentation (et suivi de la spec en conséquence)
2019-07-03 Abandon du bouton reset/validation calibration #36
    Spécification de l'appli PC de calibration
2019-07-04 Ajout d'un flow chart logiciel dans les specs
2019-07-05 Etude et tentative (infructueuse pour le moment) de calibration en partant des données simulées par Qucs
    [courbe_Vdetect.ods]
2019-07-05 Encore à la recherche de la bonne calibration... mais la courbe orange ne daigne pas suivre la courbe bleue...grrrrr
    [courbe_Vdetect.ods]
2019-07-06 Ajout d'autres régressions exponentielle, dans l'espoir de trouver la bonne #23
    [courbe_Vdetect.ods]
2019-07-06 test f0eos
    [TOSMETRE.sch]
2019-07-06 test f0eos 2
    [TOSMETRE.sch]
2019-07-06 test 3
    [TOSMETRE.sch]
2019-07-06 Encore et toujours #23 Toujours pas de courbes satisfaisante
    [courbe_Vdetect.ods]
2019-07-07 Mise en forme du tableau courbe_Vdetect.ods #23
    [courbe_Vdetect.ods]
2019-07-07 Voyons voir un peu ce qu'il se passe sous Qucs L'idée étant de valider le principe de calibration vu dans courbe_Vdetect.ods
    [SWR_POWER_METER_F8KGL_etude_detecteur_V0.6_@2.2.2.sch, courbe_Vdetect.ods]
2019-07-07 Tentative de calibration à 1W sous Qucs. On tombe toujours dans le bug #49. #23
    [SWR_POWER_METER_F8KGL_etude_detecteur_V0.6_@2.2.2.sch]
2019-07-07 tentative de calibration par une fonction puissance de 10 #23
    [courbe_Vdetect.ods]
2019-07-07 Pourquoi la courbe d'interpolation par une puissance de 10, passant par les 2 points de calibration n'est pas une droite en échelle logarithmique ? #23
    [courbe_Vdetect.ods]
2019-07-08 mise en polace du Fils manquand sur PCB Creation fichiers Ligne imprime-cache.lib
    Rien de realisaer a ce jour
    [TOSMETRE.kicad_pcb]
2019-07-08 L'axe des absicces est également logarithmique. La relation P=f(Vout) est de la forme P=K*(Vout^a) #23 #66
    [courbe_Vdetect.ods]
2019-07-09 Modification schema avec cablage du 4624 Verifier Borne In du 4624 sur Borne RA0/AN0 du 18F
    Cablage sur PCB du 4624
    [TOSMETRE.kicad_pcb, TOSMETRE.sch]
2019-07-09 essai post de caracteristique FR4.xls
    On me porpose pas de reposer les message du Schema et PCB deja poste avec message d'erreur
    [CARACTERISTIQUE FR4.xlsx]
2019-07-09 Un peu de nettoyage (déplace les fichiers au bon endroit) + NE PAS UTILISER D'ESPACE DANS LES NOMS DE FICHIERS $%#!&@
    [CARACTERISTIQUE_FR4.xlsx]
2019-07-09 Ajout d'un feuille pour la calibration de l'ADC #23
    [courbe_Vdetect.ods]
2019-07-09 essai post deux comaratif tosmetre en cours
    [COMPARATIF TOSMETRE.xlsx, Ligne imprime.kicad_pcb, Ligne imprime.sch]
2019-07-09 deplacement fichier caracteristique FR4 dans src/hw/doc/
    [COMPARATIF TOSMETRE.xlsx]
2019-07-09 fichier comparatif tosmetre commerce termine
    [COMPARATIF TOSMETRE.xlsx]
2019-07-10 Pré-nettoyage des commit 0ecaa69dd6f8bc7af803491b78190ec2dfddce83 et commit 4fcc67b1dd28b33aa8be7d4707608642628ec698
2019-07-10 Etude de la diode HSMS2822 - relevé de Vout=f(Pin) #73 Tentative de calibration de cette diode #23
    [courbe_Vdetect.ods]
2019-07-10 Synthèse des études précedentes, vues dans courbe_Vdetect.ods +Principe mathématique de calibration +Mesure de la diode HSMS2822 +Nettoyage divers et variés +Tentative de justification (à peu près pa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
    Tout ça dans doc/SWR_POWER_METER_F8KGL_etude_detecteur_HF_v0.6.odt
    +Ajout de la calibration adc dans doc/courbe_Vdetect.ods
    Tout ça pour satisfaire ces messieurs #72 #70 #36 #26 #23 #22 #8
    [courbe_Vdetect.ods]
2019-07-10 Mise en forme de la doc pour #72 #68 #26 #23
2019-07-10 MAJ de l'index
2019-07-10 Ajout des valeurs de a et K #72 #26 #23
2019-07-10 Un petit rafraichissement de la spec s'impose du coup #72 #26 #23 #68 #70 #36 #22 #8
2019-07-11 Parce que tout est mini dans notre vie, mini rafraichissement de la doc d'implémentation #72 #26 #23 #68 #70 #36 #22 #8
2019-07-11 MAJ de la doc d'étude du détecteur HF + spécifications + ajout d'une doc pour le bench des solutions de calibration #72 #26 #23 #68 #70 #36 #22 #8 #79
2019-07-11 MAJ des specs suite aux avancées sur le détecteur : -ajout des switch -spec du détecteur -diverses corrections etude_detecteur : -définition des paramètres de la spec (et démonstration) MAJ du tablea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
    [courbe_Vdetect.ods]
2019-07-15 Confusion entre P0 et P. Il faut effectivement que a<0,13 dans la 1ère zone #84
    [courbe_Vdetect.ods]
2019-07-16 continue de spécifier le détecteur HF #6 #22 #23 #26
2019-07-16 Enlève une ENORME épine du pied. En effet, cette version de la doc d'étude du détecteur HF met en évidence : -la nécessité de placer le point de fonctionnement à au moins N=10 (§3.2.1) -c'est à dire 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
2019-08-04 MISE A JOUR DU FICHIER EXCEL AVEC LES TARIFS
    SOURCE wimo, BIRD, CB+, EBAY
    [COMPARATIF TOSMETRE.xlsx]
2020-03-09 essai de livraison mais sans ........
    [TOSMETRE.kicad_pcb, TOSMETRE.sch]
2020-03-09 pointe les erreurs de #94 au schéma (petites flêches vertes)
    [TOSMETRE.sch]
2020-03-27 re essai post
    [TOSMETRE.sch]
2020-03-28 Modification piste du MAX11100 sur Schema et sur PCB
    [TOSMETRE.kicad_pcb]
2020-03-28 essai envoie apres epuration schema filaire
    [TOSMETRE.kicad_pcb, TOSMETRE.sch]
2020-03-28 essai envoi
    [TOSMETRE.sch]
2020-03-28 essai livraison 2
    [TOSMETRE.sch]
2020-03-28 essai x....
    [TOSMETRE.sch]
2020-04-17 essai livraison
    [TOSMETRE.sch]
2020-04-17 livraison avec "croix de non connecte"
    [TOSMETRE.sch]
2020-04-21 de grandes avancées sur les apsects théoriques, simu et pratique sur le détecteur HF. Enfin, une compréhension fine de la notion de "Square Law Region" #89 #88 #73 #49 #26 #22
    [SWR_POWER_METER_F8KGL_etude_coupleur_directif.sch, SWR_POWER_METER_F8KGL_etude_detecteur_V0.6_@2.1.1.sch, SWR_POWER_METER_F8KGL_etude_detecteur_V0.6_@2.2.2.sch, detecteur_HF.ods, detecteur_HF_bas70.sch]
2020-04-21 modifie la capa de 47n à 10p pour gagner sur le temps de réponse rajoute la valeur RMS et moyenne sur les 1000 derniers points #99
    [detecteur_HF_bas70.sch]
2020-04-21 ajout de la simu et la mesure à 50MHz #99 #79 #72 #43
    [detecteur_HF.ods, detecteur_HF_bas70.sch]
2020-04-23 1.1 de #99 (ainsi que #72 et #43) les idées sont beaucoup plus claires sur la notion de square law region, et surtout le pmin en entrée.
    [CARACTERISTIQUE_FR4.xlsx, COMPARATIF_TOSMETRE.xlsx, detecteur_HF.ods]
2020-04-23 ben oui...ça n'a rien à faire là, ça...
    [CARACTERISTIQUE_FR4.xlsx]
2020-04-23 ajout de #100 continue #99
    [detecteur_HF.ods]
2020-04-23 commence les conclusions pour #99...ça sent la fin de l'étude du détecteur !!!
    [detecteur_HF.ods]
2020-04-23 supprime des chevrons inutiles #101
2020-04-23 raccordement des bornes 1 9 et 10 de U4 sur bornes 17-18-19 de U1
    [TOSMETRE.sch]
2020-04-23 met fin au débat : la caractérisitque i-v de la BAS70 sous Qucs n'est pas conforme à la spec... #99 #100 #79 #43
    [detecteur_HF.ods, detecteur_HF_bas70.sch]
2020-04-23 fin de l'étude du détecteur #103 #87 #83 #79 #78 #72 #70 #26 #22 #9 Sans véritablement de conclusions tout à fait satisfaisante. On fera une calibration par morceau de la courbe V=f(P). Reste à déter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
    [detecteur_HF.ods]
2020-04-24 connection borne 5 de U4 sur borne 5 de U3
    suppression masse borne 5 de U3 suite a raccordement sur u4
    [TOSMETRE.sch]
2020-04-24 essai livrasion
    [TOSMETRE.sch]
2020-04-26 Ajout d'un message de test pour André au schéma #106
    [TOSMETRE.sch]
2020-04-26 Ebauche d'une stratégie de calibration #104 Il en ressort que la puissance max à l'entrée du détecteur ne devra pas dépasser -20dBm (création d'une fiche en conséquence pour le reporter dans les conc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
    [detecteur_HF.ods]
2020-04-26 MSG test essai de recup supprimer pour livraison
    [TOSMETRE.sch]
2020-04-26 ajout d'une conclusion supplémentaire pour ébaucher la startégie de calibration #107
    [detecteur_HF.ods]
2020-04-26 ebauche d'implémentation de l'AOP à gain variable #105
2020-04-27 ajout d'une feuille "calibration" #104
    [detecteur_HF.ods]
2020-04-27 en prévision de poser un tag sur la V0.6 ?
2020-04-27 en prévision de poser un tag sur la V0.6
    [detecteur_HF.ods]
2020-04-27 ajout de la 3ème diode BAS70H #103
    [detecteur_HF.ods]
2020-04-27 ajout de la mesure du niveau de bruit de l'oscillo + ajout d'une mesure à 430MHz #103
    [detecteur_HF.ods]
2020-04-27 ajout BAT54 #103
    [detecteur_HF.ods]
2020-04-27 espérons que ce soit la bonne, cette fois-ci pour fermer #103
    [detecteur_HF.ods]
2020-04-28 ajout convrsion decimale -> hexa #112
    [detecteur_HF.ods]
2020-04-28 version ++ MAJ des spec pour les versions ajout des SMA à souder sur PCB dans l'implémentation #113
2020-04-28 implménetatin des boutons #113
2020-04-28 mise en place des connecteur SMA en attendant la suite
    [TOSMETRE.kicad_pcb, TOSMETRE.sch]
2020-04-28 implémente les AOP #113
2020-04-28 Oubli de la pin ADDR de l'AD5175 #118 Implémentation de l'ADC
2020-04-28 ajoute la chaâine de caractère "I2C" dans le nom de fichier généré #120
2020-04-29 test du client github desktop
    test
    [TOSMETRE.sch]
2020-04-29 test desktop github pour F0EOS
    Ajout d'un texte de test au schéma
    A supprimer
    [TOSMETRE.sch]
2020-04-29 supp de text de test
    supp de texte de test #120
    [TOSMETRE.sch]
2020-04-30 supprime le message de test
    [TOSMETRE.sch]
2020-04-30 ébauche d'un driver I2C pour i2c2par de gpsim +un peu d'architecteur logicielle revue #120
2020-05-01 supprime l'alias 16F628 #109 sans doute un mauvais nettoyage issu d'un vieux commit...et laissé là par flemmardise aigue de ma part ;-)
2020-05-01 bon...un peu de nettoyage s'impose...#124 #125
    [TOSMETRE.sch]
2020-05-01 mise en place BAT54XV2
    Mise en place BAT54XV2 + capa #116
    [TOSMETRE.sch]
2020-05-01 positionne PCLATH à la bonne valeur #128
2020-05-01 supprime un incf de trop ajout des pull up à la simu sous gpsim #120
2020-05-02 vérification de la tempo #127
2020-05-02 L'octet de poids fort est...par définition (!!!) l'octet de poids fort #130
2020-05-02 changement suite a erreur mais regarde tes mail
    changement suite a erreur de sens BAT54 #116
    [TOSMETRE.sch]
2020-05-02 la capa du détecteur vaut 47n #116
    [TOSMETRE.sch]
2020-05-02 oubli de generation de la netlist
    oubli de generation de la netlist suite a mise en palce BAT54 #116
    [TOSMETRE.kicad_pcb, TOSMETRE.sch]
2020-05-04 revert https://github.com/f8kgl/swr_power_meter/commit/4e8600d9a3c8a27968c8512ddf40390111f1eb64 init un peu différente #120 #131
    [driver.asm, main.asm]
2020-05-04 supprime correctement les incf #120
    [driver.asm]
2020-05-04 lit l'ACK de l'esclave qu'une seule fois #132
2020-05-04 passe la librairie et les modules gpsim sous contrôle de version #120
2020-05-04 passe la tempo de boot à 3s #127
2020-05-04 fait appraître le nom "ltc2305" dans la liste des modules de la librairie lib_swrpowermeterf8kgl_modules #120
2020-05-04 trame i2c read fixe la valeur de retourn à 0xFD (impossible de driver le port de sortie du ltc2305) #120
    [adc.asm, driver.asm, frame.asm]
2020-05-04 définition des bits de commande #120
2020-05-05 un ADC 8 bits sous Gpsim #120
2020-05-05 ADC sur 12 bits (CH0) #120
2020-05-06 ajout des devices supportés par les outils microchip #120
2020-05-06 -implémente les commandes du LTC2305 -CH0/CH1) -corrige un bug mineur (non référencé : effet de seuil si V>4.096V) #120
    [adc.asm, main.asm]
2020-05-06 1ère ébauche de ce driver, mais le module gpsim ne compile pas #121
2020-05-07 ajoute les résistances de pull up à la doc d'implémentation
    ajout des pull-up en page 15 #119 #143
2020-05-07 remplacement SMA verticale par des Horizontale
    remplacement SMA verticale par des Horizontale #145
    [TOSMETRE.kicad_pcb, TOSMETRE.sch]
2020-05-07 spécifie la gestion de fiche sur Github
2020-05-07 Revert "spécifie la gestion de fiche sur Github"
    This reverts commit 66eb2142ebd53784e12ac41e454546d143bd6a5c.
2020-05-07 Revert "Revert "spécifie la gestion de fiche sur Github""
    This reverts commit 718f9f182c04af72a2b04093dcd6a7b8d03d75d4.
2020-05-07 repositionnement c7
    repositionnement c7 #150
    erreur de ma part j'avais bien vu mais mal place
    [TOSMETRE.sch]
2020-05-07 évite de compiler ma librairie perso... #121 #152
2020-05-07 applique la correction de #128 à #151 #121
2020-05-08 précise la destination #153 #121
2020-05-08 précisions dans la procédure de génération de libraire gpsim #154 #152
2020-05-09 déplace la problématique du pclath à l'intérieur de la table #121 #128
2020-05-09 [gpsim] vfwd=0.035 typiquement, et met la bonne adresse I2C de l'AD5175 de la voie FWD #121
2020-05-09 La 1ère trame provoque un NACK de l'esclave Contournement mis sous flag DEBUG_ISSUE_134 #121 #157
2020-05-09 suppression U3 et U4 #155
    suppression U3 et U4 #155
    [TOSMETRE.sch]
2020-05-10 repart de qqc de propre #163 #162
2020-05-10 un peu de nettoyage supplémentaire #155 #118
    [TOSMETRE.sch]
2020-05-10 ajout de trace printf sous flag DEBUG et remet la librairie lib_swrpowermeterf8kgl_modules #161 #121
2020-05-10 pose de l'AD5175
    pose de l'AD5175 #164
    [TOSMETRE.sch]
2020-05-10 un clear file un peu mal placés +ajoute des traces de debug #167 #121
2020-05-11 revoit entièrement la philosophie de la doc d'implémentation
    pour être plus clair et plus exhaustif aussi.
    ajoute l''implémentation du LT1818 et du 18F1320 aussi...#171
2020-05-11 spec et implémentation revue
    refonte totale des docs implémentation et spécifications.
    Les specs contiennent dorénavant, 3 gros chapitre :
    1-spec générales
    2-spec hw (avec la définition des composants, boitier, fonctions des pin, sch de principe)
    3-spec sw : relativement générales (=>pas de spec des traitements)
    Doc d'implémentation :
    côté hw, contiendra l'explication du schéma
    coté sw, contiendra le détail de l'implémentation sw
    #148
2020-05-11 ajoute les octets de commande de l'ADC +quelques corrections mineures +revoit un peu l'init du coup pour coller à la spec #148 #160
    [adc.asm, main.asm]
2020-05-11 oubli d'une référence externe (f_i2c_init) et typo sur le flag de debug gpsim #170 #176
2020-05-11 mauvaise définition du flag de debug de 134 #170 #177
2020-05-11 $!§#%$$ de PCLATH de $!§#%$$ #178 #170
2020-05-11 passe par Vpullup pour fixer la tension de sortie #170 #167
2020-05-11 encore ce $!§#%$$ de PCLATH #179 #167
2020-05-11 fixe la valeur de la résistance de pull up #167
2020-05-12 mise en oeuvre de l'AOP REF #181
2020-05-12 report de la correction PCLATH #183
2020-05-12 supprime des fichiers inutiles #174
    [Ligne imprime.kicad_pcb, Ligne imprime.sch, TOSMETRE18F1320.kicad_pcb, TOSMETRE18F1320.sch]
2020-05-12 supprime les nodes inutiles #184
2020-05-12 fin du merge : remet le texte d'origine + enlève les traces de debug
2020-05-12 suppresion des pdf (pb de mise en forme graphique des schéma). Sule .odt seront commités dorénavant
2020-05-13 nouveau mode de livraison des docs #186
    [COMPARATIF_TOSMETRE.xlsx, courbe_Vdetect.ods, detecteur_HF.ods]
2020-05-13 Update SWR_POWER_METER_F8KGL_specifications.fodt
    Evolution d'interface : fixer la résistance plutôt que le gain #187
2020-05-13 Mise en place LT818
    mise en place du LT818 #168
    [TOSMETRE.sch]
2020-05-13 Update SWR_POWER_METER_F8KGL_specifications.fodt
    MAJ des versions dans spec (ajout V0.8) #188
2020-05-14 renomme les pdf #192 enlève "I2C" du binaire généré #193
2020-05-14 renomage et ajout composant
    renomage du composant LT818 et LT1818 dans le schema et la librairie
    Ajout du AD5175 manquant #191
    [TOSMETRE.sch]
2020-05-15 preparation installation tutoriel github
    preparation tuto d'installation de github avant la phase de post et recup
2020-05-15 mise en place du LTC2305
    mise en place du LTC2305 #119
    [TOSMETRE.sch]
2020-05-15 spec V0.8
    ajout du menu AOP dans les specs du fw de test
    ajout du xWATT METER F8KGL #188
2020-05-16 RACORDEMENT AD LTC ET LT
    PREMIERE VAGUE
    #196
    [TOSMETRE.sch]
2020-05-16 Spec du menu AOP (début de la mesure de V en mV en entrée de l'AOP) Ajout des logs #188
2020-05-17 Raccordement AD LTC et LT suite
    Raccordement AD LTC et LT #196 mais maintenant je calle grave je me perd
    [TOSMETRE.dsn, TOSMETRE.sch]
2020-05-17 raccodement #196
    je patoge grave de grave
    je vois des petit truc que je peux faire mais je comprend plus rien
    [TOSMETRE.sch]
2020-05-17 correction erreur
    correction erreur vu sur U7 #196
    generation fichier netlist pour mieux les reperer en cas d'erreur eventuelle
    [TOSMETRE.sch]
2020-05-18 création du doc principe de calibration #188
2020-05-18 Principe de calibration
    Introduction #188
2020-05-18 spec HW de l'EEP #188
2020-05-18 spec V0.8 et calibration
    table de calibration du menu "AOP"
    + spec logicielle de CALC #188
2020-05-18 ajout d'une feuille de calcul pour le ROS
    [detecteur_HF.ods]
2020-05-18 Revert "ajout d'une feuille de calcul pour le ROS"
    This reverts commit bfab1620dbb5bf8af9d7d3e9546c394e6707a68f.
    [detecteur_HF.ods]
2020-05-18 bon...nouvelle méthode de calibration. A adapter dans le FW de test (il faut que le gain réglable...)#188
    [detecteur_HF.ods]
2020-05-19 suite raccordement composants
    mauvaise position du LTC2305
    Raccordement alimentation des LT1818
    Raccordement "SMA BAT54" sur LT1818 (mais pas sur)
    je pense avoir tout fait sauf le raccordement du 18F1320 sur le, je pense, 2305
    je te dirais que j'ai encore beaucoup d'interrogations et que ca loin d'etre evident meme avec des explications
    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
    [TOSMETRE.sch]
2020-05-19 Revert "Merge branch 'master' of https://github.com/f8kgl/swr_power_meter"
    This reverts commit e91baacce1cfff05617cbc605e423fe19a361c77, reversing
    changes made to 44e5e039900b94dcaa12221737dca48e4b943d86.
    [detecteur_HF.ods]
2020-05-19 Revert "Revert "Merge branch 'master' of https://github.com/f8kgl/swr_power_meter""
    This reverts commit aa64e9d03a5a16bf042da0269a96390c3369ca4b.
    [detecteur_HF.ods]
2020-05-19 tentative de procédure de calibration #188
    Dans l’état actuel des choses, je suis totalement incapable de pouvoir spécifier la procédure de calibration.
    En effet, il en ressort que la calibration dépend beaucoup des performances du coupleur ET aussi des perfs de la diode (typiquement, les valeurs de a et b)
    Le fw de test sera pourvu d’un menu AOP, qui doit, entre autres, valider l’architecture SW et HW choisie. La procédure de test (que j’ai appelé « test de validation ») devra donc s’attacher à vérifier que c’est calibrable (avec ET sans ligne de couplage).
    Pour cela, il faudra éditer une procédure de test pour les tests de validation.
    Tout d’abord, dans cette p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
    [detecteur_HF.ods]
2020-05-19 Update SWR_POWER_METER_F8KGL_specifications.fodt
    MAJ du "Calibrateur" #188
2020-05-19 SUITE #196
    Correction #212
    Correction #213
    Correction #214
    [TOSMETRE.sch]
2020-05-22 raccordement 2305 sur 18F
    raccordement 2305 sur 18F
    verifier raccordement lcd #196
    [TOSMETRE.sch]
2020-05-23 recherche optimisation sans croisement
    recherche optimisation sans croisement pour le raccordement du 18f au LCD sans changement pour les PIN de programmation
    A verifier bien sur tout cela #196
    [TOSMETRE.sch]
2020-05-25 rectif 18f fils qui se croisent
    rectif 18f fils qui se croisent suite a msg Whastapp #196
    [TOSMETRE.sch]
2020-05-26 Publie les spec V0.8
    #217
2020-05-26 MAJ spec V0.8
    p15 : redite "robuste"
    p16 : suppression commentaire. Ajout de #223
    p19 : ajout EEP
    p21 : typo
    p26 : précise GND et VSS
    p29 : évolution du bus I2C côté PIC
    p34 : suppression de commentaire
    #188
2020-05-26 MAJ pinout PIC I2C #222
2020-05-26 Ajout d'un flag pour le xWATT METER
    Uniquement pour les fw calibration et opérationnel
    pour le fw de test, le LCD affiche SWR POWER METER quelque soit le hw utilisé
    #197
2020-05-26 gain en puissance de 2
    les 25 ohms passent à 510 sous GPSIM aussi !!! #210
2020-05-26 Table de calibration sortie brute de l'ADC
    c'est précisemment le but du menu ADC
    #142
2020-05-26 compensation de l'offset AOP 2,048V #189
2020-05-26 Spec EEP pour driver #238
2020-05-26 Ajout d'une boite EEP au schéma de principe du MCU §4.8.2
2020-05-26 gros commit divers et variés : #234 : typo #142 : la nouvelle table ne rentre pas dans la section .code (revert) #197 : applique correctement les flags dans le cas des fw non-TEST
2020-05-26 renomme digit_pot en aop rend Rdac programmable dans le module gpsim de l'AD5175 #248
2020-05-26 debut de table G/Rdac #250 mais il faut revoir le driver de flash qui ne sait lire que dans la table de calibration en flash
2020-05-26 Alors...en effet, la table de calibration NE PEUT PAS rentrer dans la flash du PIC. Car cette table fait : 4095x12bits...soit près de 6ko. On la supprime donc, et on passe directement la valeur de l'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
2020-05-27 généralisation de l'adresse de début d'une table dans le driver de flash
    #250
2020-05-27 fixe le gain à G=2
    +évolution GPSIM pour tenir compte la valeur typique de la résistance end to end (10k)
    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
2020-05-27 préparation des menu
    menu ADC et menu AOP #200 #201
2020-05-27 ah la la oups 3 fois #200 #201
2020-05-27 pour être conforme à la spec #200
2020-05-27 précisie la lecture des ADC dans la spec #251
    tout ça après les développements...mais bon...mieux vaut tard que jamais ;-)
2020-05-27 correction fiches 240 et 241
    Correction fiches #240 et #241
    [TOSMETRE.sch]
2020-05-27 ajout des message de boot pour le xWATT METER
    #243
2020-05-27 spécifie la conso du PIC #231
2020-05-27 plus besoin de faire les manips au démarrage de gpsim on charge l'ensemble (code + breadboard avec la commande gpsim -c swr_power_meter.stc
2020-05-27 ajout du bouton bande dans le breadbord + quelques corrections dans le fw #198
    [main.asm]
2020-05-27 met la création des liens symboliques dans le makefile du projet (na na nèreuhhh) #255
2020-05-27 force la création des liens même si les fichiers existent #255
2020-05-27 dans le fw, compile les lib vraiment avec le flag TEST +cast en double la valeur de rdac dans le module ad5175 #250
2020-05-27 enlève le flag de debug du module ad5175
2020-05-28 renomme les menus #267
2020-05-28 spec de "fixe le gain" dans [CALC] #269
2020-05-28 init des modules AOP et CALC #266
2020-05-28 spec du changement de port [CALC] et [LCD] #268
2020-05-28 début de spec pour les logs #209
2020-05-28 spec test timer0 dans les les log #272
    Le bit 1 n’est utilisé que dans le firmware de test à des fins de vérifications du timer 0 après passage par une fonction de temporisation (Del160us par exemple)
    +regen PDF
2020-05-28 mise en conformité avec la spec du menu "mesure"
2020-05-28 début du menu calibration - pour le moment se contente d'afficher FWD et REF #273 +MAJ spec portA du PIC +debut de cahier de test au format txt
2020-05-28 clignotement LCD en fonction de la valeur de v_calc_port #266 #268 #273
2020-05-28 ajout d'un flag DEBUG_ISSUE_256 pour pouvoir retourner dans le menu de mesure après la calibration #276 #256 #273 #268
2020-05-28 affiche les chaines G et Rdac #273
2020-05-29 ajout init de n #266 factorise #273
2020-05-29 Mettre les capa de découplage du PIC sur VDD #242
    Mise en place des capa de découplage du PIC sur VDD #242
    [TOSMETRE.sch]
2020-05-30 c'est tout à fait confirmé !! Le boutpn sous GPSIM n'est PAS avec relâchement. Cela dit, le vrai bouton peut avoir du rebond. Contourne les 2 avec ce commit. +de nombreuses révisions plus ou moins es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
2020-05-30 machine d'état pour la gestion du menu de calibration #279 dans l'état, il sembelrait qu'on ne passe par par _fsm_lcd_toggle_state2 ?
2020-05-30 généralisation de la longuer de la chaine #279
2020-05-30 mise en place de EEP non raccorde
    composant EEP mis sur le schme mais non raccorde #208
    [TOSMETRE.sch]
2020-05-30 généralisation de la chaine de caractère + revoit l'archi sw du code #279
2020-05-30 un peu de nettoyage
2020-05-30 généralisation de la position du curseur #279
2020-05-31 un tout petit d'archi sw + gestion du bouton avec timeout (dans le cas des rebons d'un bouton) #279
2020-05-31 revient au menu mesure après être sorti de la machine d'état #274
2020-05-31 correction d'un petit bug d'affichage repasse par l'affichage de "FWD G DAC/REF G DAC" systématiquement après un appui sur boutn cal+ #279
    [main.asm]
2020-05-31 oups (j'ai eu de la chance sur ce coup là) #279
2020-06-01 passe la valeur de G dans la FSM #279
2020-06-01 rectif
    fiche #240
    fiche #229
    fiche #228
    fiche #242
    j'ai suivi les consigne du fichier Specifications pour le raccordement du LCD mais ca croise
    [TOSMETRE.sch]
2020-06-02 conversion en décimale de G avant affichage #279
2020-06-02 gére les cas où G>4 et G<0 #279
2020-06-02 1ère mouture de log avec le registre RCON #272
2020-06-02 la fin d'écriture détectée par une IT ne fonctionne visiblement pas...c'est pas très grave => polling sur le bit EEIF
2020-06-03 toggle la valeur de n sur port REF #279
2020-06-03 ah là là...c'est pas idéal (et pas tout à fait conforme à la spec)...mais c'est un peu mieux quand même effet de saturation pour n>4, fontionnenement circulaire pour G<0 #272
2020-06-03 G choisi de manière circulaire #272 mais ne passe pas encore par 0 si "cal-"
2020-06-03 généralisation des log
    ajoute une trace de l'appli en cours d'éxecution
    et nettoie quelque warning de compil
2020-06-03 rempli les logs à la bonne adresse en EEP
    le Contenu du champ valeur ne fait que 7 octets (et nons pas 8)
2020-06-03 boucle principale sur v_log_nb_byte_to_write, et petit boucle interne sur v_log_data_size + compte le bon nb d'octet dans v_log_nb_byte_to_write +remet le marqueur de fin de chaine de version (et dép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
2020-06-03 intégère une trace du timer0 au démarrage #272
2020-06-04 un peu de factorisation
    et affiche la valeur de n dès la rentrée dans le menu de calibration #279
2020-06-04 affiche la valeur de Rdac #279
2020-06-04 gère correctement N_MIN et N_MAX #279
    [main.asm]
2020-06-04 passe Rdac dans la FSM du LCD #279
2020-06-05 fixe Rdac dans [AOP] #270
    [main.asm]
2020-06-05 calcul de la partie entière et partei décimale #271
2020-06-08 modifie les bons registres #271
2020-06-08 affiche la tension calibrée sur la voie REF #271
2020-06-08 position de la partie décimale sur l'écran #271
2020-06-08 raccordement U5 au +5v
    #229
    [TOSMETRE.sch]
2020-06-08 améliore la précision de la simulation #257
2020-06-08 applique la nouvelle valeur du DAC à la voie REF aussi #284
2020-06-08 incrémentation du poids fort de Rdac en utilisant POSTDEC (remarque : la carry a une polarité inversée => bit "borrow") #282 +retire les traces de debug sous gpsim
2020-06-09 passe la résistance de l'entrée inverseur à 625 ohms #284
2020-06-09 gère correctement la valeur de TMR0 #281
    [main.asm]
2020-06-09 un peu de factorisation
2020-06-09 économie de ram et supprime les binaires inutiles
2020-06-09 ajout de l'EEP 256k au breadboard #207
2020-06-09 génération des data eep externe
2020-06-09 essai d'optimisation
    essai d'optimisation pour evite les long et tres long ue jonctions entre composants
    mais si on raccourci d'un cote on rallonge de l'autre
    dis moi ce que tu en penses sinon fait faire au projet un retour en arriere
    [TOSMETRE.sch]
2020-06-09 #115
    RE POST POUR OPTIMISATION
    [TOSMETRE.sch]
2020-06-10 generation de la table de calibration de TEST #207
2020-06-10 table de calibration pour le fw de TEST #207
2020-06-11 driver EEP externe dans le menu mesure #207
2020-06-12 ajout des NACK éentuels dans les logs #209
    + supprime le flag DEBUG_ISSUE_134 #159
2020-06-16 archi hw revue #263 #249 #230 #226 #216 #215 #95
    [TOSMETRE.sch]
2020-06-16 pull up sur le bus I2C + un peu de comestique diverse #249
    [TOSMETRE.sch]
2020-06-16 510 passe à 625ohms #283
    [TOSMETRE.sch]
2020-06-16 modif addresse I2C AOP #287
    spec + code + simu
2020-06-16 bouton de calibration sur RA0/RA1 et le bus I2C sur RA2/RA3 #286
2020-06-16 voir fiche #292
    voir fiche #292
    [TOSMETRE.sch]
2020-06-17 raccordement pin 1 de U6
    raccordement pin 1 de U6 #292
    [TOSMETRE.sch]
2020-06-17 oubli raccordement C3
    #292
    [TOSMETRE.sch]
2020-06-18 ajout du module resistor aux sources #244
2020-06-18 #288
    raccordement C28 c27
    #288
    [TOSMETRE.sch]
2020-06-19 évite de passer en dessous de R2
    car, pour le coup, R2 est taversé par un le signal de mesure, signal plutôt sensible a priori, et il vaut mieux, dans la mesure du possible, éviter tout couplage avec d'autres signaux...d'autant plus s'il s'agit de Vdd, qui est, par nature, extrêmement pollué. De plus, on évite une boucle de Vdd, qui serait une véritable antenne #288
    [TOSMETRE.sch]
2020-06-21 renomme resistor en detector #244
2020-06-21 mise en place bouton #274
    SUR U1
    VERIFIER AVSS ET VSS
    mise en place des bouton sur RA0-RA1- et RA4
    [TOSMETRE.sch]
2021-02-10 documente le changement de méthode de chargement dans gpsim #255
2021-02-12 Update SWR_POWER_METER_F8KGL_specifications.fodt
    change Ligne de mesure en ligne de couplage #294
2021-02-12 specs de test
    specs des tests PIC généraux (et un peu de typo dans les specs) #293
2021-02-12 Update SWR_POWER_METER_F8KGL_Tests.fodt
    Ajout de test #293
2021-02-12 Update SWR_POWER_METER_F8KGL_specifications.fodt
    ajout d'un bouton de calibration dans les specs suite à un oubli #297
2021-02-12 ajout d'un pont diviseur de tension
    #260 ajout d'un pont de résistance pour les tests sur version proto p23 et 28
2021-02-12 NETTOYAGE #298
    NETTOYAGE 1 ET 2 #298
    [TOSMETRE.sch]
2021-02-13 nettoyage 3 #298
    [TOSMETRE.sch]
2021-02-13 #303
    Ajout REF et FWD
    [TOSMETRE.sch]
2021-02-15 Create TPS70950DBVT.pdf
    ajout spec d'un régulateur 5V au format SOT23 (et dispo chez RS ou Farnell pour pas trop cher) #300
2021-02-15 rotation de texte
    #303
    [TOSMETRE.sch]
2021-02-15 upodate specs
    diverses corrections, préparation des specs pour la calibration
2021-02-16 MAJ principe de calibration #146
2021-02-16 Update SWR_POWER_METER_F8KGL_principes_de_calibration.fodt
    début de table de ROS #236
2021-02-16 génération from scratch dans les docs
    documente la génération from scratch (à reporter aussi dans la doc d'implémentation) #313
    et du coup, ajoute la génération de la table dans la règle "all"
2021-02-16 modif bouton poussoir #307
    modification bouton poussoir
    [TOSMETRE.sch]
2021-02-17 #307
    Mise a jour des empreintes pour le schema
    [TOSMETRE.sch]
2021-02-17 revoit entièrement le déroulé des tests, afin de coller davantage au principe "monté bloc par bloc fonctionnel", avec validation d'interface #293 #310 +regen spec pdf
2021-02-17 #299
    #299 deplacement capa de decouplage
    [TOSMETRE.sch]
2021-02-17 #301
    Modification valeur R1 et R4 valent 510 ohms (pas 625)
    [TOSMETRE.sch]
2021-02-17 #301 modification valeur de R1 et R4
    Modification valeur de R1 et R4 en 625
    Du coup valeur de R5 et R6 a verifier
    [TOSMETRE.sch]
2021-02-17 #301
    Rajout commentaire résistance test ADC1 sur resistance R6 et R5
    [TOSMETRE.sch]
2021-02-17 MAJ (gratuite et offerte par la maison) des specs
2021-02-18 #320
    Peux tu verifier si le remplacement du 7805 est ok
    Dans ce cas je le supprimerai pour ne laisser que le tps709
    [TOSMETRE.sch]
2021-02-18 oups
    c'est de ma faute
    [TOSMETRE.sch]
2021-02-18 Update SWR_POWER_METER_F8KGL_Tests.fodt
    ajout de tests AOP et compléments sur les tests ADC #293
2021-02-18 correction doc
    corrige la connection GND du LTC2305 dans les specs + regen pdf #320
2021-02-18 Update SWR_POWER_METER_F8KGL_principes_de_calibration.fodt
    spec de calibration (aspects théoriques) #188
2021-02-18 #320
    suppression des capa sur la borne 1 {GND) du LTC2305
    [TOSMETRE.sch]
2021-02-18 raccourci les fils #320
    [TOSMETRE.sch]
2021-02-18 #315
    mise en place double alimentation pile
    [TOSMETRE.sch]
2021-02-18 #315
    pour mise a jour ds composants sur pc pro
    pas de modif particuliere
    Accessoirement tuto pour Post pour Francois
    [TOSMETRE.sch]
2021-02-19 clarification de l'init + update spec + regen pdf #309
2021-02-19 #308
    mise en place de l'interupteur
    Fab peut tu valider la modif afin de supprimer la partie alimentation a base du 7805 STP
    [TOSMETRE.sch]
2021-02-22 #315
    Modification appellation de TPS7A0522 en TPS70950DBVT
    génération fichier netlist pour répertorier nouveaux composants
    [TOSMETRE.sch]
2021-02-22 #323
    supprimer
    [TOSMETRE.sch]
2021-02-22 calibration de la diode
    #188 c'est définitivement pas simple
    ajout fichier d'erreur #325
2021-02-22 #315
    Ajout de Diodes D4 et D5 sur la " double" alimentation
    [TOSMETRE.sch]
2021-02-22 #315
    ESSAI POUR FRANCOIS
    [TOSMETRE.sch]
2021-02-23 #315
    déplacement diode esthétique
    [TOSMETRE.sch]
2021-02-23 #188
    redéfinition de la V0.8 => étude
2021-02-23 revoit la philosophie de gestion de version
    revoit la philosophie des versions :
    V0.8 = version d'étude
    V1.0 = prototype
    suppose donc de faire faire des PCB V0.8
    puis des PCB proto V1.0 #188
2021-02-23 #318
    ok fait
    [TOSMETRE.sch]
2021-02-23 #315 suppression regulateur dc
    7805 suprime
    [TOSMETRE.sch]
2021-02-23 #315 suppression d5 pres de j6
    [TOSMETRE.sch]
2021-02-23 revoit entièrement la spec suite à la notion de version d'étude en V0.8 #188
2021-02-23 refont de l'étude #326
2021-02-23 refonte de l'étude #326
2021-02-23 1ère version des tests de la version d'étude
2021-02-24 continue la refonte de l'étude #326
2021-02-24 test de conformité par rapport aux fonctionnalités HW attendues + ajout d'un test sur le K de la diode + ajout d'un test sans AOP #326
2021-02-24 précision importante ajoutée à la version de test
    #326 (+ gen pdf associé)
2021-02-24 ajout d'une remarque de F0EOS
    très judicieuse, sur les runs de cartes à prévoir #326
2021-02-24 square law region + outil RF
    outil pour divers calcul rf simples #330
    +principe théorique de la square law region #328
    [divers_rf_calc.ods]
2021-02-24 #308
    définition de l'empreinte de J6 avec détrompeur pour PCB avec génération de la net-liste
    [TOSMETRE.sch]
2021-02-24 ajout d'un § sur la T° + regen pdf #328
2021-02-24 #299
    deplacement capa
    [TOSMETRE.sch]
2021-02-24 codage de la calibration de la puissance par table #328
2021-02-24 compléments sur la table de calibration en EEPROM #328
2021-02-25 tentative d'AN sur la sensi en circuit ouvert du détecteur (BAS70 et BAT54) #328
    [divers_rf_calc.ods]
2021-02-25 BJH doit retourner à l'école
    pour faire des multiplications #332
2021-02-25 AN
    #328
    [divers_rf_calc.ods]
2021-02-25 ajout de 2 Tests de sensibilité
    sur la carte d'étude #328
2021-02-25 supprime l'EEP des spec
    #331
2021-02-25 un peu de cosmetique
2021-02-25 supprime toute trace de l'EEP dans les spec #331
2021-02-25 étude sur la bande passante #328
2021-02-25 ajout d'un circuit d'adapation d'impédance aux spec #333
2021-02-26 shunte la recherche de valeur en EEP #331
2021-02-26 étude de la résistance de charge du détecteur HF #328
2021-02-26 étude d'un circuit de coompensation en T° #328 + ajout d'un test de stabilité #328 + spec #327
2021-02-26 oups
    il y avait une contradiction dans le §4.2.3.3
2021-02-26 étude aop
    + test + divers calcul excel
    [divers_rf_calc.ods]
2021-02-27 un peu de cosmétique, de temps en temps, ça ne fait pas de mal #328
2021-02-27 finalement, il n'y a pas grand chose à dire de plus sur l'ADC. Pour la position de la virgule, il y a le §6.1.2 #328
2021-03-01 Update SWR_POWER_METER_F8KGL_etude.fodt
    étude du calcul de la tension calibrée : calcul de la partie entière et décimale ramenée en entrée de l'AOP #338
2021-03-01 mmhh...la phase de calibration semble s'éclaircir ?
    #339
    [divers_rf_calc.ods]
2021-03-02 nbeuses modifs
    modif AOP + suppression AD5175 + étude remontée de mesure en W (et dBm) + ajout d'une feuille de calcul pour tout cela #339
    [divers_rf_calc.ods]
2021-03-02 #334 u8 supprime
    fait
    [TOSMETRE.sch]
2021-03-02 #302
    ajout pont diviseur mais je ne suis pas bien sur d'avoir compris
    [TOSMETRE.sch]
2021-03-02 #343 modif aop
    modif faite sur un aop si ok je fais la modif sur le deuxieme
    [TOSMETRE.sch]
2021-03-02 #327 #302
    compensation temp et pont diviseur
    [TOSMETRE.sch]
2021-03-02 #324 supprimer u4 et u7
    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
    [TOSMETRE.sch]
2021-03-02 #324
    modification des jonction sur les R et generation netliste
    [TOSMETRE.sch]
2021-03-02 supprime le driver EEP #336 ajout d'une règle de maj du proj gpsim dans le makefile #345
2021-03-02 #324
    Suppression des fils ne servant a rien
    [TOSMETRE.sch]
2021-03-02 supprime le cmp sw AOP + revoit l'AOP en mode inverseur dans la libraire gpsim + spec #342
2021-03-02 #324
    petit peu de nettoyage :
    C16, C17, C6, C11
    [TOSMETRE.sch]
2021-03-02 #324
    ÉCLAIRCISSEMENT DU SCHEMA
    [TOSMETRE.sch]
2021-03-03 # modif patte out a la masse
    si c'est ok il reste le deuxieme a faire
    [TOSMETRE.sch]
2021-03-03 Update SWR_POWER_METER_Tests.fodt
    #344 (finalement, on revient directement au proto, et on annule la version d'étude)
2021-03-03 #343
    RAJOUT FILS MANQUANT
    [TOSMETRE.sch]
2021-03-03 #343
    CORRECTION FILS
    [TOSMETRE.sch]
2021-03-03 étude de la chaine rf
    calibration : §5.3.2 #344
    puissance en dBm #347
    #340 #341
    [divers_rf_calc.ods]
2021-03-03 introduction du Kconv(dBm) dans l'EEP interne du PIC
    + revoit la compensation de l'offset de l'AOP #347
    +remise en forme plus ou moins générale avec suppression des dernières traces du pot digital et de l'EEP externe
    +continue la mise en oeure des nouveaux menus tension et puissance
    [divers_rf_calc.ods]
2021-03-03 #343 modif aop
    [TOSMETRE.sch]
2021-03-03 #333 adaptation 50 ohms
    [TOSMETRE.sch]
2021-03-03 #274 bouton calibration + -
    modif libelle boutons calibration
    [TOSMETRE.sch]
2021-03-03 # modif libelle bouton freq
    [TOSMETRE.sch]
2021-03-04 clarifiication des specs hw
    au niveau du détecteur HF #333 #302 #327
2021-03-04 clarification de la spec
    pour le pont diviseur en entrée de l'ADC #302
2021-03-04 clarification des specs pour les boutons
    suppression des boutons cal+ et cal-
    +ajout d'un filtre anti-rebond et pull up sur le bouton bande #274
2021-03-04 supprime la dépendance avec
    la règle de génération de la table de calibration qui se trouvait en EEP externe #314
2021-03-04 conversion en mV
    specs #353
    [divers_rf_calc.ods]
2021-03-04 revoit la spec des connecteurs
    #315
2021-03-04 connecteur de programmation #306
    + oups #315
2021-03-04 intégration de l'offset AOP #349 + supprime le composant AOP de gpsim, car pas de maj possible s'il n'y a pas de requete I2C (du coup, on baocule l'AOP dans l'ADC...c'est pas très propre, mais bon...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
2021-03-05 #274 boutons calibrations supprimes
    pullup sur bouton bande
    [TOSMETRE.sch]
2021-03-05 #306 connecteur de prog
    il faudra faire un pont sur le circuit imprime
    [TOSMETRE.sch]
2021-03-05 #333 #302 #327
    modif pont divisieur aop
    [TOSMETRE.sch]
2021-03-05 spec calcul en dBm
    1ère mouture #347
    [divers_rf_calc.ods]
2021-03-05 #357
    Grosse modification pour "coller" avec la grille
    Grosse aération du schéma
    Optimisation peut être a prévoir
    Attention nouvelle reference et appelation des composants
    [TOSMETRE.sch]
2021-03-06 rapport des test ERC #357
2021-03-06 adapate les noms de variables #353
2021-03-06 adapte les specs aussi du coup #353
2021-03-06 #357
    Remplacement des valeurs R9 et R15
    declacement de C18 mais pas sur a verifier
    [TOSMETRE.sch]
2021-03-06 #302 #307
    Modif condensateur C18
    Ajout pont diviseurs
    du coup de ne sais pas s'il faut laisser le C ou le retirer ?
    [TOSMETRE.sch]
2021-03-06 #302 #307
    Oubli generation de la netliste
    [TOSMETRE.sch]
2021-03-06 #333
    Pi= l'abaque de Smith c'est loin pour moi
    [TOSMETRE.sch]
2021-03-06 commence le transfère des fonctions de conversion vers CALC #359
2021-03-06 # 357
    GÉNÉRATION NETLISTE
    EDITION DES EMPREINTE POUR PCB
    [TOSMETRE.sch]
2021-03-07 #357
    DEPLACEMENT PARTI REF
    [TOSMETRE.sch]
2021-03-07 #357
    generation de netliste en vu du PCB
    Des erreurs sont a corriger
    [TOSMETRE.sch]
2021-03-08 mise ne place d'un pointeur pour la conversion BCD #362
2021-03-08 nouvelle convention de nommage des variables
    passer plutôt par des pointeurs (version minimale à tester) #363
2021-03-08 #357
    suppression des erreur dans le fichier netliste
    suppression PCB qui ne correspondait a plus rien
    [TOSMETRE.kicad_pcb, TOSMETRE.sch]
2021-03-08 Update frame.asm
    passe par lfsr dans FSR1 #364
2021-03-08 ajout d'un log
    timer SAMPLE #359
2021-03-08 suppression du cmp sw bp #365 +supprime tout le code mort #366 +place correctement les MSB/LSB des pointeurs #364 +généralisation des pointeurs dans les cmp sw #363
    [adc.asm, conv.asm, frame.asm, main.asm]
2021-03-08 rend cohérent les MSB/LSB de FSR0 avec v_p_lcd_string+1 #371
2021-03-08 log ADC #367
2021-03-08 quad l'adresse des log est à 0xFF, la prochaine adresse d'écriture n'est pas 0x00 mais 0x20. On détecte le passage 0xFF -> 0x00 par le bit carry du registre status #373
2021-03-09 gestion de la retenue de _v_adc
    lors du complément à 2 #368
2021-03-09 début de calcul en mV
    mise en en place de la nouvelle version de la conversion BCD (optimisée en RAM+résultat sur 2 octets) #362 #359 #353
2021-03-09 quelques petites erreur de compilation + passe par FSR2 pour la gestion du LCD (évite d'écraser FSSR0 par la même occasion) #374
2021-03-09 ajoute de la conversion bcd et ascii
2021-03-10 aligne les octets à gauche
    pour la conversion BCD #375
2021-03-10 un peu d'optmisation
    de code et de RAM (tout ça pour 1 octet...)
2021-03-10 étude du calcul des puissances en dBm et W
    #347
    [divers_rf_calc.ods]
2021-03-11 spécifie le test 0x42
    timer FXM1616U #377
2021-03-11 étude et spec du calcul de P en dBm
    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
    [divers_rf_calc.ods]
2021-03-11 affichage de la tension en mV #375 #362 #359 #353 +compil +modif Vref = 0,3V dans gpsim #378
2021-03-11 supprime un rlcf dans le calcul BCD, car celui ci provoque un *2 dans le résultat...#378 Pour le moment, on garde la version du diviseur par 4096 dans sa version "manuelle", plutôt que par appel à f_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
2021-03-11 mise en place d'un flag de debug pour #379
2021-03-12 mise en oeuvre d'un octet en EEP pour activation d'un niveau de trace en fonction du tag
    #380
2021-03-12 cahier de recette (brouillon) du fw de simu
    #360
2021-03-12 c'est la crise, faut faire des économies #359
2021-03-12 cahier de recette #360
2021-03-12 nettoyage des IF 0 #359
2021-03-12 ajout tests des log #360
2021-03-15 ajout de tests à l'init
    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
2021-03-15 modif capa C19 C20 C21 C22
    non montées #381
    [TOSMETRE.sch]
2021-03-15 ahhh...l'octet de config de trace est en 0x1F
    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
2021-03-15 ajout du tableau des tosmètre du commerce
    +petite modif sur le nom du tag sample timer #362
2021-03-15 tstfsz ne fonctionne que sur des files + gestion correcte du bit zero du regsitre de status #3810
    [main.asm]
2021-03-16 revoit la spec des logs #380
2021-03-16 introduit la notion de TAG et d'ID_LOG #380
2021-03-16 revoit entièrement la fonctionnalité de log
    en prenant 2 octets de TAG
    réduit en conséquence la taille des buffers de trace
    mutualise et rationnalise les contenues
    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
2021-03-16 début de mise en oeuvre de la table 10*log(ADC)
    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
2021-03-16 il faut gérer correctement la fin de trame des log pour ne pas écrire des 0xFF en boucle +pour les logs de timer, re-gère celui dans une macro (en passant par v_tmp) +ajout d'un flag de debug #380
    [main.asm]
2021-03-16 driver de flash pour réupérer les valeurs de la table de 10log(ADC) #347
2021-03-17 faut arrêter les délires, à un moment donnée...
    #347 #384
2021-03-17 génération de la table de 10*log(ADC) #347
2021-03-17 Ahhh...ça fait plaisir de se séparer de INDF0 et INDF1 !!! Enfin !!! #359
2021-03-17 et on continue dans la joie et la bonne humeur #359
2021-03-18 calibrator #347
2021-03-18 oups #359 (compil + mauvais report de nomn de fonction)
2021-03-18 calcul de P en dBm #347
2021-03-19 calcule correctement l'adresse à pointer en flash pour remonter 10log(ADC) #347
    +ajout du calibrator dans le readme (pour intégration ensuite dans le makefile à faire) #388
    [calc.asm]
2021-03-19 replace les valeurs de calibration avec R1=R2=1 ohms, pour être cohérent avec l'état actuel de la simu #347
    [calibrator.c]
2021-03-19 oubli #347
    [divers_rf_calc.ods]
2021-03-20 utilise correcetment la command gpsim pour charger l'EEPROM du PIC #387 ajout du calibrator dans le makefile #388
2021-03-22 etude et spec du calcul de P en W #390
2021-03-22 1ère mouture de P en W et ADCfwd/ADCref #391 #390
2021-03-22 sort _v_calc_bcd_count de sa fonction pour la rendre paramètrable +ajout de Kconv(nW) en EEPROM #390
2021-03-23 #302
    remise en place des resistance R18 a R21
    je pose sur cette fiche j'ai pas retrouver la fiche adequat
    [TOSMETRE.sch]
2021-03-23 donne accès aux paramètres de calibration
    en ligne de commande #390
2021-03-23 documente le calibrator #388
2021-03-23 remet le calibraotr bien au propre, et gère la plupart des cas de figure (hormis fw operationnel pour le moment) #390 +mise en place du flag DEBUG_ISSUE_389 #389
2021-03-23 calcul de P en W #390
2021-03-24 gain de RAM en déplaçant le calcul de P en W
    dans le fw opérationnel uniquement #359
2021-03-25 pour optmisation RAM
    séparation TEST/CALIBRATION/OPERATIONNEL #359
2021-03-26 compil + propagation des flags HW dans les makefile #359
2021-03-27 #305
    debut routage mais seulement positionnement des composants pour sauvegarde
    [TOSMETRE.kicad_pcb]
2021-03-29 #304
    implentation composants
    [TOSMETRE.kicad_pcb]
2021-03-30 grosse modif
    pour les optimisations de RAM, mise en oeuvre des fw test et opérationnel #359
2021-03-30 gagne 4ko de code pour le SWR_POWER_METER #359
2021-03-30 #394
    modif empreinte J4 et J7 en vue du Pcb
    [TOSMETRE.kicad_pcb, TOSMETRE.sch]
2021-03-31 ajout de la voie REF #347
2021-03-31 déjà, faut lui donner des données de calibration hein #347
2021-04-01 Update calc.asm
    tous les résultats sont décalés de 4 bits à droite. peut-être que cela vient de là en fait... #347
2021-04-01 compléments sur les tests manuels et ajouts de commentaires sur les tests auto #360
2021-04-01 factorisation dans les fonctions d'affichage #395
2021-04-01 vérif de calibration_done #393
2021-04-01 ajout d'un test pour vérifier le temps de conversion ADC #180
2021-04-01 #305
    debut routage pour degrossir et se rendre compte
    a optimiser
    [TOSMETRE.kicad_pcb]
2021-04-01 #305
    pour validation
    Pise 1mm
    via diametre 1,4 et percage de 0,6
    [TOSMETRE.kicad_pcb]
2021-04-01 oups +regen calibration #393
2021-04-01 remet la puissance en dBm sur la voie FWD de manière correcte #347
    [calc.asm, conv.asm, main.asm]
2021-04-02 grrrrrr $!%^*#{[ #396
    comment cela a t'il pu m'échapper...
2021-04-02 fait rentrer b'0' au début du shift à droite
    et poisitionne correctement le debut de la chaine de char pour la valeur de P en dBm sur la voie REF #347
    [conv.asm]
2021-04-02 #305
    suite du routage
    [TOSMETRE.kicad_pcb]
2021-04-02 #305
    ROUTAGE
    Apres je ne sais pas comment je peux faire
    [TOSMETRE.kicad_pcb]
2021-04-04 positionne correctement l'octet d'entrée de parse_ref #347
    [calc.asm]
2021-04-04 et il faut également à aligner le résultat BCD de vla voie REF à guache #347
2021-04-04 #305
    MODIFICATION EMPREINTE J3 J5 ET J2
    [TOSMETRE.kicad_pcb, TOSMETRE.sch]
2021-04-05 warning de copim divers et variés #314
2021-04-05 spécifie le calibrator du fw de test #344
2021-04-06 #304
    MODIFICATION PCB AVEC NOUVELLE EMPREINTE J2 J3 ET J5
    [TOSMETRE.kicad_pcb]
2021-04-06 #304
    OUPS DES PETIT OUBLI
    [TOSMETRE.kicad_pcb, TOSMETRE.sch]
2021-04-11 corrige le facteur de correction (hum hum...) #369
2021-04-11 poubellise le résultat de la conversion précédente #386
2021-04-13 nom de fichier incorrecte #398
2021-04-13 supprime les dernières traces ce lt1818 #398
2021-04-18 Mise à jour des how to #296
2021-04-18 déplace le répertoire de tests #296
2021-04-18 #305
    Livraison suite a coup de telephone
    [TOSMETRE.kicad_pcb, TOSMETRE.sch]
2021-04-18 #305
    LIVRAISON SUITE A TELEPHONE 2 ET AVANT DE POURSUIVRE SI PAS BON
    [TOSMETRE.kicad_pcb]
2021-04-19 #305
    MODIFICATION CIRCUIT
    RAPPROCHEMENT DES COMPOSANTS SUR PISTES
    RAJOUT PLAN DE MASSE
    [TOSMETRE.kicad_pcb, TOSMETRE.sch]
2021-05-01 #305
    Ajout de masse oublier sur C5 et C20
    [TOSMETRE.kicad_pcb]
2021-11-06 #305
    rajout non connection sur U2 borne 1 et 2
    [TOSMETRE.sch]
2022-01-11 un peu de cosmétique dans le readme
2022-01-12 plusieurs corrections et clarifications + ajout des campagnes de test
2022-02-07 #146 #188 supprime toutes traces de V1.0 et au dessus (pour pouvoir passer aux dev des tests) spécifie le programmateur (câble + connecteur)
2022-04-09 #173
    Mise a jour suite a la version kicad 6
    [TOSMETRE.kicad_pcb, TOSMETRE.kicad_sch]
2022-04-30 #402
    BROULLION
    [TOSMETRE.kicad_pcb, TOSMETRE.kicad_sch]
2022-05-03 #406
    pour verification 18F1320 sans pave
    [TOSMETRE.kicad_pcb, TOSMETRE.kicad_sch]
2022-05-04 #406
    modification piste qui se croise sous U2
    A valider par PANORAMIX
    [TOSMETRE.kicad_sch]
2022-05-04 #406
    DEBUT DU ROUTAGE
    [TOSMETRE.kicad_pcb]
2022-05-04 #406
    erreur danns la net liste
    le U4 etait un 8plot alors qu'il en faut 12
    rectif faite
    [TOSMETRE.kicad_pcb, TOSMETRE.kicad_sch]
2022-05-04 #406
    circuit terminer
    j'ai du faire passe une piste sous U5 pour relier C16 et C17
    attente de validation plus faire une embellissement et élargir les pistes si besoin en fonction de tes desideratas et des contrainte électrique
    [TOSMETRE.kicad_pcb]
2022-05-06 #406
    Modification des pistes de 0.25 a 0.40
    modification des VIa de 0.6 a 1
    "compactage "du pcb
    envoie depuis le reseau WIFI du TGV arrivant en gare de nimes
    [TOSMETRE.kicad_pcb]
2022-05-09 #406
    debut optimisation
    [TOSMETRE.kicad_pcb]
2022-05-13 #406
    PB termine
    Nouvelle appleation suite a mauvaise manip (GRRRR) desole
    Voir si on peux pas changer R1et R2 pour eviter qu'une piste passe dessous
    [TOSMETRE.kicad_pcb, TOSMETRE.kicad_sch]
2022-05-14 #406
    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
    [TOSMETRE.kicad_pcb, TOSMETRE.kicad_sch]
2022-05-16 #406
    re routage en cours suite a plantage
    [TOSMETRE.kicad_pcb]
2022-05-16 supprime les traces
2022-05-17 #406
    mise a jour du schema suite au plantage
    vu erreur de pistes sous les via ( en cours de modification)
    elargissement des via a 1mm
    elargissement des pistes a 0.5 et 0.4 selon les endroits
    Reste a modifiier les pistes cote J4 et J7
    [TOSMETRE.kicad_pcb]
2022-05-17 #406
    routage terminer
    attente de validation
    [TOSMETRE.kicad_pcb]
2022-05-19 un tout petit peu de cosmétique sur le readme
2022-05-20 #412
    via au plus pres des composants
    [TOSMETRE.kicad_pcb]
2022-05-20 #413 #412
    #412 MASSE OUBLIER SUR U4
    [TOSMETRE.kicad_pcb]
2022-05-20 #410
    Modif Schema et routage sur J5 a valider par grand MANITOU
    [TOSMETRE.kicad_pcb, TOSMETRE.kicad_sch]
2022-05-20 #410
    a valider sinon retour en arriere
    [TOSMETRE.kicad_pcb]
2022-05-21 #412
    OUBLIE DE MASSE SUR CERTAIN COMPOSANTS
    VERIFIER LES VIA DE gnd CERTAIN SONT PLUS PETIT A CAUSE DU DRC
    [TOSMETRE.kicad_pcb]
2022-05-23 #412
    OUBLI DE VIA
    MODIFICATION TYPE ECRITURE DESIGNATION COMPOSANT
    iL FAUT PASSER LE TEMPS AVEC 2H DE RETARD ET BLOQUER EN GARE DE NIMES
    [TOSMETRE.kicad_pcb]
2022-05-24 #417
    RACCORDEMENT BORNE 8 DE u2
    Mauvaise connection dans le schema donc la netliste ne le voyait pas
    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
    [TOSMETRE.kicad_pcb, TOSMETRE.kicad_sch]
2022-05-25 #417
    si rajout de R1 (à Ohms) plus de piste sous R16 et R17
    [TOSMETRE.kicad_sch]
